Dimasssius/DIY_Alliance_NixieClock_Userland/hardcore/README.md

[Главная](../README.md) / Hardcore

# ⚡ Hardcore Edition

Обложка DIY_Alliance Nixie Clock

Расширенная линейка часов DIY_Alliance. Сборочные документы выбираются по количеству индикаторов и комплектации.

## Выберите количество индикаторов

| Плата | Вид платы | Материалы |
| :--- | :---: | :--- |
| **Hardcore · 4 индикатора** | Верхняя сторона Hardcore на 4 индикатора, базовая комплектация | [Выбрать комплектацию](assembly/hardcore-boards-x4-tubes/README.md) |
| **Hardcore · 6 индикаторов** | Верхняя сторона Hardcore на 6 индикаторов, базовая комплектация | [Выбрать комплектацию](assembly/hardcore-boards-x6-tubes/README.md) |

## Комплектации Hardcore

| Название в документах | Как понимать |
| :--- | :--- |
| Minimal | Минимальная комплектация компонентов для запуска часов |
| Base | Базовая комплектация с основными функциями |
| Maximal | Расширенная комплектация с дополнительными датчиками и модулями |

Выбирайте комплектацию по своему набору и BOM. Наличие отдельных функций проверяйте по схеме и настройкам прошивки.

## Сборка, прошивка и использование

| Задача | Раздел |
| :--- | :--- |
| Подготовиться к первой сборке | [Начало работы](../START_HERE.md) |
| Найти инструкцию | [Инструкции Hardcore](manuals/README.md) |
| Настроить и загрузить прошивку | [Совместимость Hardcore](firmware/README.md) · [Общий порядок настройки](../common/firmware/CONFIGURATION.md) |
| Настроить время, подсветку и будильник | [Управление часами](../common/manuals/USER_GUIDE.md) |
| Найти ответ или причину неисправности | [Вопросы по Hardcore](faq/README.md) · [Диагностика](../common/troubleshooting/README.md) |
| Найти характеристики компонентов | [Даташиты](datasheets/README.md) |

> [!NOTE]
> Отдельная пошаговая инструкция Hardcore и готовые сборки прошивок пока не опубликованы. Доступны схемы, BOM, чертежи и общие руководства.

Ревизию уточняйте по маркировке платы. Изображения в каталоге служат визуальным ориентиром. [Полный каталог сборочных материалов](assembly/README.md).
