Dimasssius/DIY_Alliance_NixieClock_Userland/standard/README.md

[Главная](../README.md) / Standard

# 🔧 Standard Edition

Обложка DIY_Alliance Nixie Clock

Базовая линейка часов DIY_Alliance. Сборочные документы выбираются по количеству индикаторов, варианту монтажа и ориентации индикаторов.

## Выберите количество индикаторов

| Плата | Вид платы | Материалы |
| :--- | :---: | :--- |
| **Standard · 4 индикатора** | Верхняя сторона Standard на 4 индикатора | [Выбрать документы](assembly/standard-boards-x4-tubes/README.md) |
| **Standard · 6 индикаторов** | Верхняя сторона Standard на 6 индикаторов | [Выбрать документы](assembly/standard-boards-x6-tubes/README.md) |

## Варианты Standard

Для каждой платы есть документы на **выводной монтаж** и **поверхностный монтаж (SMD)**, с **вертикальными** или **горизонтальными** индикаторами. Выбирайте одинаковый вариант в BOM, схеме и сборочном чертеже.

## Сборка, прошивка и использование

| Задача | Раздел |
| :--- | :--- |
| Подготовиться к первой сборке | [Начало работы](../START_HERE.md) |
| Найти инструкцию | [Инструкции Standard](manuals/README.md) |
| Настроить и загрузить прошивку | [Совместимость Standard](firmware/README.md) · [Общий порядок настройки](../common/firmware/CONFIGURATION.md) |
| Настроить время, подсветку и будильник | [Управление часами](../common/manuals/USER_GUIDE.md) |
| Найти ответ или причину неисправности | [Вопросы по Standard](faq/README.md) · [Диагностика](../common/troubleshooting/README.md) |

> [!NOTE]
> PDF-инструкции по сборке опубликованы для x4 и x6. Готовые сборки прошивок для скачивания пока отсутствуют; доступны заметки по настройке.

Ревизию уточняйте по маркировке платы. Изображения в каталоге служат визуальным ориентиром. [Полный каталог сборочных материалов](assembly/README.md).
