Dimasssius/DIY_Alliance_NixieClock_Userland/images/diagrams/README.md

[Главная](../../README.md) / [Изображения](../README.md) / Диаграммы и схемы подключения

# 🖼️ Диаграммы и схемы подключения

Отдельные поясняющие диаграммы пока не добавлены.

Электрические схемы конкретных плат доступны в каталогах [Standard](../../standard/assembly/README.md) и [Hardcore](../../hardcore/assembly/README.md).
