Dimasssius/DIY_Alliance_NixieClock_Userland/START_HERE.md

[Главная](README.md) / Начало работы

# 🚀 Начало работы: от платы до работающих часов

Если часы уже собраны, откройте [руководство пользователя](common/manuals/USER_GUIDE.md). Если возникла неисправность — [диагностику](common/troubleshooting/README.md).

## 1. Определите свою сборку

Перед выбором файлов уточните:

| Параметр | Что нужно знать |
| :--- | :--- |
| **Линейка** | Standard или Hardcore |
| **Количество индикаторов** | 4 или 6 |
| **Ревизия** | Маркировка на плате и документы к набору |
| **Вариант сборки** | Для Standard — выводной или поверхностный монтаж и ориентация индикаторов; для Hardcore — Minimal, Base или Maximal |
| **Индикаторы** | Модель и посадочное место верхней индикаторной платы |

Число индикаторов и ревизия платы — разные параметры. Если маркировка непонятна, уточните вариант у автора проекта до выбора компонентов и прошивки.

| Ваша плата | Материалы |
| :--- | :--- |
| Standard, 4 индикатора | [Страница платы](standard/assembly/standard-boards-x4-tubes/README.md) |
| Standard, 6 индикаторов | [Страница платы](standard/assembly/standard-boards-x6-tubes/README.md) |
| Hardcore, 4 индикатора | [Выбор комплектации](hardcore/assembly/hardcore-boards-x4-tubes/README.md) |
| Hardcore, 6 индикаторов | [Выбор комплектации](hardcore/assembly/hardcore-boards-x6-tubes/README.md) |

## 2. Подготовьте документы и компоненты

На странице своей платы или комплектации откройте **BOM → схему → сборочный чертёж**. Для Standard выбирайте один и тот же вариант монтажа и ориентации индикаторов во всех документах.

- **BOM** — список компонентов, их номиналы, корпуса и количество.
- **Схема** — электрические соединения и обозначения компонентов.
- **Сборочный чертёж** — расположение компонентов на плате.
- **Рендер** — внешний вид платы для визуальной проверки.

Прочитайте [подготовку к сборке](common/manuals/ASSEMBLY_GUIDE.md) и проверьте [совместимость индикаторов](common/indicators/README.md).

Для Standard опубликованы [PDF-инструкции на 4 и 6 индикаторов](standard/manuals/README.md). Отдельной пошаговой инструкции Hardcore пока нет; доступны [общие рекомендации и документы комплектаций](hardcore/manuals/README.md).

## 3. Соберите и проверьте плату

Следуйте инструкции своей версии. Сверяйте номиналы с BOM, ориентацию компонентов — со схемой и маркировкой, расположение — со сборочным чертежом.

Перед первым включением проверьте монтаж, полярность питания и отсутствие коротких замыканий. Известные нюансы описаны в [общем руководстве](common/manuals/ASSEMBLY_GUIDE.md#известные-нюансы-индикаторных-плат).

> [!CAUTION]
> В часах есть высоковольтная часть. Выполняйте пайку и исправление монтажа при отключённом питании.

## 4. Настройте и загрузите прошивку

> [!NOTE]
> Готовые сборки прошивок для плат DIY_Alliance в этом репозитории пока не опубликованы. В Wiki описана настройка внешней прошивки radon-lab/NixieClock.

Откройте [раздел прошивки](common/firmware/README.md), затем [порядок настройки и загрузки](common/firmware/CONFIGURATION.md). Сверьте линейку, ревизию, число индикаторов, периферию и разводку своей платы.

## 5. Проверьте результат и настройте часы

После загрузки проверьте отображение цифр, порядок индикаторов и работу кнопок. Настройте время и нужные функции по [руководству пользователя](common/manuals/USER_GUIDE.md).

Если результат отличается от ожидаемого, выберите симптом в [разделе диагностики](common/troubleshooting/README.md). Если вопрос остался, подготовьте данные своей сборки и [описание проблемы](FAQ.md#какие-данные-подготовить-для-обращения-за-помощью).
