Dimasssius/DIY_Alliance_NixieClock_Userland/announcements/2026-06-07-pcb-v2-announcement.md

[Главная](../README.md) / [Новости](README.md) / Платы v2.0

# 📰 Новая версия печатных плат v2.0 заказана

**Опубликовано: 7 июня 2026 года.** Описание планов и состояния проекта на дату публикации.

Подготовлена новая версия печатных плат DIY_Alliance Nixie Clock v2.0 для Standard и Hardcore линеек.

Платы уже заказаны. После получения я протестирую их, исправлю возможные проблемы, внесу мелкие доработки и после этого буду готов запускать платы в производство и продажу.

## Standard Boards x4 Tubes v2.0

В стандартной плате на 4 индикатора изменений не очень много, но они затрагивают удобство сборки и качество разводки:

- Изменено расположение почти всех компонентов, увеличено расстояние между ними, улучшена разводка дорожек и полигонов.
- Доработаны футпринты некоторых компонентов, например изменен футпринт Micro USB-коннектора.
- UART-преобразователь CH340C перенесен на верхний слой. Теперь все компоненты, кроме холдера батарейки CR1025, находятся на верхнем слое печатной платы.
- Слегка изменены размеры печатной платы: размеры теперь кратны сетке 0.025 мм.
- Buzzer заменен на FUET-4020.
- Изменились некоторые электронные компоненты, например установлен другой, более подходящий MOSFET.

## Standard Boards x6 Tubes v2.0

В стандартной плате на 6 индикаторов изменения аналогично направлены на улучшение разводки и сборки:

- Изменено расположение почти всех компонентов, увеличено расстояние между ними, улучшена разводка дорожек и полигонов.
- Доработаны футпринты некоторых компонентов, например изменен футпринт Micro USB-коннектора.
- UART-преобразователь CH340C перенесен на верхний слой. Теперь все компоненты находятся на верхнем слое печатной платы.
- Слегка изменены размеры печатной платы: размеры теперь кратны сетке 0.025 мм.
- Изменились некоторые электронные компоненты, например установлен другой, более подходящий MOSFET.

## Hardcore Boards x4 Tubes v2.0

Версия Hardcore на 4 индикатора была переработана значительно глубже:

- Плата переделана с нуля, изменены некоторые компоненты, например MOSFET у повышающего преобразователя.
- Повышающий преобразователь перемещен на верхний слой. Теперь на нижнем слое размещается только CH340C.
- Buzzer заменен на FUET-4020.
- Типоразмер конденсаторов и резисторов заменен на 0603 у всех компонентов, кроме обвязки ESP8266, где остался 0402.

## Hardcore Boards x6 Tubes v2.0

Версия Hardcore на 6 индикаторов также переработана с нуля:

- Плата переделана с нуля, изменены некоторые компоненты, например MOSFET у повышающего преобразователя.
- Повышающий преобразователь перемещен на верхний слой. Теперь все компоненты расположены на верхнем слое.
- Типоразмер конденсаторов и резисторов заменен на 0603 у всех компонентов.
- Добавлена поддержка RTC RV-3028-C7.
- Выведены Test Point под пайку MP3-плеера и FM-тюнера.

## Следующие шаги

1. Получить заказанные платы v2.0.
2. Собрать и протестировать Standard x4/x6 и Hardcore x4/x6.
3. Исправить возможные проблемы после проверки.
4. Внести мелкие доработки, если они понадобятся.
5. Портировать актуальную прошивку под печатные платы DIY_Alliance.
6. Подготовить платы к производству и продаже.
7. Плотно заняться переработкой верхних, индикаторных печатных плат под все поддерживаемые индикаторы.
