Dimasssius/DIY_Alliance_NixieClock_Userland/hardcore/assembly/hardcore-boards-x4-tubes/base-configuration/report-board-stack/Report Board Stack.PDF

# Board Stack Report

Stack Up | Layer Stack
Layer | Board Layer Stack | Name | Material | Thickness | Constant

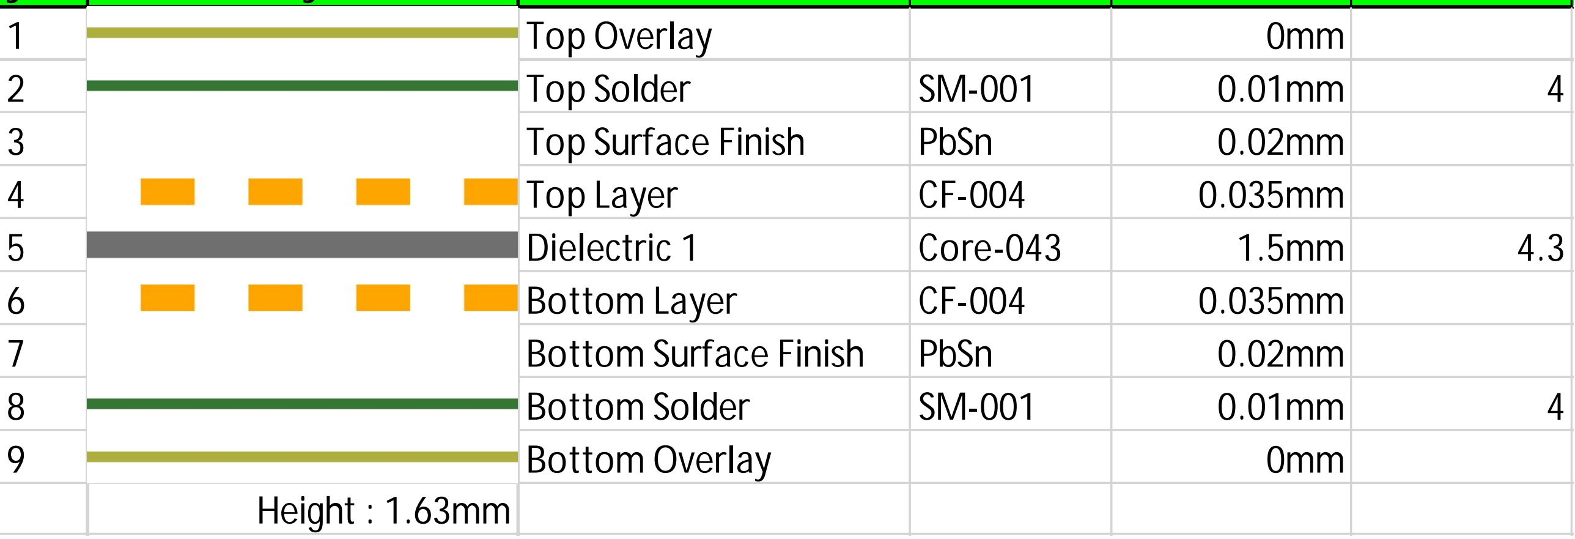
[picture p6: figure]
Top Overlay; Top Solder; Top Surface Finish; PbSn; Top Layer; Dielectric 1; Core-043; Bottom Layer; Bottom Surface Finish; Bottom Solder; Bottom Overlay; Height : 1.63mm
