Dimasssius/DIY_Alliance_NixieClock_Userland/announcements/README.md

[Главная](../README.md) / Новости проекта

# 📰 Новости проекта

Объявления о платах и планах автора. Дата публикации важна: планы из старого объявления не подтверждают текущую готовность платы или прошивки.

| Дата | Объявление |
| :--- | :--- |
| 7 июня 2026 | [Заказаны новые платы v2.0: изменения Standard и Hardcore](2026-06-07-pcb-v2-announcement.md) |

Изменения файлов Wiki: [история изменений](../CHANGELOG.md).
