Dimasssius/DIY_Alliance_NixieClock_Userland/common/README.md

[Главная](../README.md) / Общие материалы

# 🧭 Общие материалы

Руководства и справка для Standard и Hardcore. BOM, схемы и сборочные чертежи выбирайте в [каталоге Standard](../standard/README.md) или [каталоге Hardcore](../hardcore/README.md).

| Задача | Раздел |
| :--- | :--- |
| Подготовиться к сборке и проверить компоненты | [Общие рекомендации по сборке](manuals/ASSEMBLY_GUIDE.md) |
| Научиться управлять часами | [Кнопки, настройки и режимы](manuals/USER_GUIDE.md) |
| Выбрать прошивку и понять совместимость | [Прошивка](firmware/README.md) |
| Настроить пины, катодную маску и порядок анодов | [Настройка и загрузка прошивки](firmware/CONFIGURATION.md) |
| Проверить модель индикаторов и сокет | [База индикаторов](indicators/README.md) |
| Подобрать катодную маску | [Инструменты](tools/README.md) |
| Найти причину неисправности | [Диагностика](troubleshooting/README.md) |

Все руководства, включая PDF по эксплуатации: [раздел инструкций](manuals/README.md).
