Dimasssius/DIY_Alliance_NixieClock_Userland/images/README.md

[Главная](../README.md) / Изображения

# 🖼️ Изображения проекта

| Что нужно | Где найти | Статус |
| :--- | :--- | :--- |
| Фотографии газоразрядных индикаторов | [Галерея индикаторов](indicators/README.md) | Есть фотографии советских моделей |
| Рендеры конкретной платы | [Standard](../standard/README.md) · [Hardcore](../hardcore/README.md) | Есть в материалах плат и комплектаций |
| Общие фотографии сборки | [Фотографии проекта](photos/README.md) | Пока не добавлены |
| Обложка и правила оформления Wiki | [Баннеры Wiki](banners/README.md) | Есть тематическая обложка |
| Общие рендеры устройств | [Рендеры проекта](renders/README.md) | Пока не добавлены |
| Поясняющие диаграммы | [Диаграммы](diagrams/README.md) | Пока не добавлены |

Список поддерживаемых моделей и сокетов находится в [базе индикаторов](../common/indicators/README.md).
