Dimasssius/DIY_Alliance_NixieClock_Userland/common/firmware/README.md

[Главная](../../README.md) / [Общие материалы](../README.md) / Прошивка

# ⚙️ Прошивка: источник, совместимость и настройка

> [!NOTE]
> Готовые сборки прошивок для плат DIY_Alliance в этой Wiki пока не опубликованы. Здесь описана адаптация внешней прошивки под вашу сборку.

В документации проекта используется [radon-lab/NixieClock](https://github.com/radon-lab/NixieClock). Её исходный код находится во внешнем репозитории; здесь собраны пояснения по настройке для Standard и Hardcore.

## С чего начать

| Задача | Документ |
| :--- | :--- |
| Проверить, что учитывать для своей линейки | [Standard](../../standard/firmware/README.md) · [Hardcore](../../hardcore/firmware/README.md) |
| Настроить пины, периферию и индикацию | [Порядок настройки](CONFIGURATION.md#порядок-настройки-прошивки) |
| Загрузить прошивку в микроконтроллер | [Порядок загрузки](CONFIGURATION.md#порядок-прошивки-микроконтроллера) |
| Исправить неправильные цифры | [Подбор катодной маски](CONFIGURATION.md#подбор-катодной-маски-индикаторов) |
| Исправить порядок индикаторов | [Подбор порядка анодов](CONFIGURATION.md#подбор-порядка-анодов) |
| Разобраться с ошибкой | [Диагностика](../troubleshooting/README.md) |

## Что зависит от платы

Сверьте **линейку → ревизию → число индикаторов → вариант сборки → установленную периферию**. Настройки пинов, индикации и модулей проверяйте по схеме своей платы.

Общие инструкции описывают процесс настройки. Проверенный комплект конфигурационных файлов для каждой ревизии в Wiki пока не опубликован.

| Файл внешней прошивки | Назначение в документации Wiki |
| :--- | :--- |
| `connection.h` | Пины подключения периферии |
| `userConfig.h` | Выбор периферии и пользовательские настройки |
| `config.h` | Общие настройки, маска дешифратора и порядок катодов |
| `indication.h` | Порядок анодов индикаторов |
| `boards.h` | Собственные настройки платы для переноса на другие версии прошивки |

Для разводки, отличающейся от базовой платы автора прошивки, в документации Wiki используется `BOARD_TYPE 0`. Подробности — в [порядке настройки](CONFIGURATION.md).

## Сервисные режимы при включении

[Сброс настроек, меню отладки и тест системы](../manuals/USER_GUIDE.md#сервисные-режимы-при-включении) описаны в руководстве пользователя. Наличие и поведение режимов зависят от используемой прошивки.

## Источник и изменения плат

Источник прошивки: [radon-lab/NixieClock](https://github.com/radon-lab/NixieClock), лицензия MIT.

Изменения новых плат описаны в [объявлении от 7 июня 2026 года](../../announcements/2026-06-07-pcb-v2-announcement.md). Объявление фиксирует планы на дату публикации; совместимость конкретной сборки проверяйте отдельно.
