Dimasssius/DIY_Alliance_NixieClock_Userland/common/indicators/README.md

[Главная](../../README.md) / [Общие материалы](../README.md) / Индикаторы

# 💡 Поддерживаемые индикаторы

База моделей газоразрядных индикаторов и вариантов индикаторных плат DIY_Alliance. Модель индикатора относится к верхней плате; материалы нижней платы выбирайте в [Standard](../../standard/README.md) или [Hardcore](../../hardcore/README.md).

## Как выбрать вариант

1. Найдите модель в таблице ниже.
2. Проверьте число индикаторов и наличие смешанной конфигурации.
3. При замене модели откройте список совместимых сокетов.
4. Сверьте распиновку, электрические и механические параметры со своей сборкой.

**«4 или 6 индикаторов»** означает два отдельных варианта платы. **«ИН-8 + ИН-16»** означает смешанную сборку: 4 основных ИН-8 и 2 ИН-16 для секунд.

Совместимость сокета описывает посадочное место. Применимость другой модели к конкретной сборке нужно проверять отдельно.

[Советские модели](#советские-индикаторы) · [Популярные зарубежные](#популярные-зарубежные-индикаторы) · [Редкие зарубежные](#редкие-зарубежные-индикаторы) · [Фотографии](../../images/indicators/README.md)

## Советские индикаторы

| Индикатор | Вариант платы | Совместимые по сокету |
| :--- | :--- | :--- |
| **ИН-1** | 4 или 6 индикаторов | — |
| **ИН-2** | 4 или 6 индикаторов | — |
| **ИН-4** | 4 или 6 индикаторов | — |
| **ИН-4 + ИН-2** | 4 индикатора ИН-4 + 2 секундных ИН-2 | — |
| **ИН-8** | 4 или 6 индикаторов | — |
| **ИН-8 + ИН-16** | 4 индикатора ИН-8 + 2 секундных ИН-16 | — |
| **ИН-8-2** | 4 или 6 индикаторов | — |
| **ИН-8-2 + ИН-16** | 4 индикатора ИН-8-2 + 2 секундных ИН-16 | — |
| **ИН-12** | 4 или 6 индикаторов | [Список моделей](#сокет-ин-12) |
| **ИН-12 + ИН-17** | 4 индикатора ИН-12 + 2 секундных ИН-17 | [Список моделей](#сокет-ин-12) |
| **ИН-14** | 4 или 6 индикаторов | — |
| **ИН-14 + ИН-16** | 4 индикатора ИН-14 + 2 секундных ИН-16 | — |
| **ИН-16** | 4 или 6 индикаторов | — |
| **ИН-17** | 4 или 6 индикаторов | — |
| **ИН-18** | 4 или 6 индикаторов | — |
| **ИН-18 + ИН-14** | 4 индикатора ИН-18 + 2 секундных ИН-14 | — |

## Популярные зарубежные индикаторы

| Индикатор | Вариант платы | Совместимые по сокету |
| :--- | :--- | :--- |
| **Z566M** | 4 или 6 индикаторов | [Список моделей](#сокет-z566m) |
| **Z560M** | 4 или 6 индикаторов | [Список моделей](#сокет-z560m) |
| **ZM1040** | 4 или 6 индикаторов | [Список моделей](#сокет-zm1040) |
| **ZM1080** | 4 или 6 индикаторов | [Список моделей](#сокет-zm1080) |
| **ZM1000** | 4 или 6 индикаторов | [Список моделей](#сокет-zm1000) |

## Редкие зарубежные индикаторы

| Индикатор | Вариант платы | Совместимые по сокету |
| :--- | :--- | :--- |
| **NL-844** | 4 индикатора | [Список моделей](#сокет-nl-844) |
| **NL-5870** | 4 индикатора | [Список моделей](#сокет-nl-5870) |
| **CD80** | 4 индикатора | — |

## Сокеты и совместимые модели

Списки ниже сохранены из исходной базы. Перед установкой другой модели проверьте её параметры и распиновку.

### Сокет ИН-12

IN-15A, IN-15B, ZM1162, ZM1180, ZM1181, ZM1182, ZM1183, ZM1185A, ZM1185B, ZM1185D, ZM1185E, ZM1185F, ZM1186, ZM1188, GR1420, GR1430, F9152A, CD43, CD56, B59956

### Сокет Z566M

LC631, Z5660M, Z567M, Z5670M, B566M, Z522M, ZM1040, ZM1041, ZM1041S, ZM1042, ZM1043, ZM1043S, ZM1047, ZM1049

### Сокет Z560M

Z560M, Z5600M, Z510M, Z561M, Z562M2, Z562M3, ZM1020, ZM1021, ZM1022, ZM1023, ZM1024, ZM1025, B5092, B5094, NL5094, B6032, B6033, B6034, B6036, B6091, 6844A, LC513A, LC511, LL551, LL552, LL553, LL554, LL555, LL556, LL557, LL558, QS30-1

### Сокет ZM1040

ZM1041, ZM1041S, ZM1042, ZM1043, ZM1043S, ZM1047, ZM1049

### Сокет ZM1080

Z570M, B570M, Z573M, Z574M, Z5730M, Z5740M, ZM1081, ZM1082, ZM1134, ZM1138A, F9080B, F9080BA, TAF1093, TAF1317A, TAU7030

### Сокет ZM1000

ZM1001, ZM1005, ZM1005R, ZM1006, ZM1010, ZM1011, ZM1012, ZM1013, MTC0X 3B/3F/3J/4I/5B/6B/6F, MCD0X, MUD0X

### Сокет NL-844

NL803, NL807, NL811, NL812, NL821, NL840, NL840VR, NL841, NL842, NL843, NL845, NL847, NL848, NL864, NL867, NL900, NL908, NL939, NL943, CK1907, CK8754, 340-0005

### Сокет NL-5870

NL-5870S, NL-5870ST, NL-5870SF, NL-5870TF, NL-5870L, NL-950S

Фотографии: [советские индикаторы](../../images/indicators/soviet/README.md). Галерея зарубежных моделей пока не заполнена.
