Dimasssius/DIY_Alliance_NixieClock_Userland/hardcore/firmware/README.md

[Главная](../../README.md) / [Hardcore](../README.md) / Прошивка

# ⚙️ Прошивка Hardcore: совместимость и настройка

> [!NOTE]
> Готовые сборки и архивы прошивок для Hardcore в этой папке пока не опубликованы. Доступна документация по настройке внешней прошивки.

В документации проекта используется [radon-lab/NixieClock](https://github.com/radon-lab/NixieClock) с параметрами под разводку DIY_Alliance.

## Перед загрузкой

Сверьте:

- линейку **Hardcore**, количество индикаторов **4 / 6** и ревизию платы;
- комплектацию **Minimal / Base / Maximal** и установленную периферию;
- подключение пинов по схеме своей платы;
- катодную маску и порядок анодов выбранных индикаторов.

Количество индикаторов само по себе не определяет совместимость прошивки.

## Порядок действий

1. Откройте [BOM и схему своей платы](../assembly/README.md).
2. Прочитайте [общие пояснения по прошивке](../../common/firmware/README.md).
3. Выполните [настройку и загрузку](../../common/firmware/CONFIGURATION.md).
4. Проверьте цифры и порядок индикаторов; при проблемах используйте [диагностику](../../common/troubleshooting/README.md).
