Dimasssius/DIY_Alliance_NixieClock_Userland/images/banners/README.md

[Главная](../../README.md) / [Изображения](../README.md) / Баннеры

# 🖼️ Баннеры Wiki

Тематическая обложка базы знаний: графитовый фон, медные дорожки и янтарное свечение газоразрядных индикаторов. Изображение используется на главной и в разделах Standard/Hardcore.

Обложка DIY_Alliance Nixie Clock с шестью светящимися газоразрядными индикаторами

| Файл | Назначение |
| :--- | :--- |
| [wiki-hero.png](wiki-hero.png) | Обложка, PNG, 2172 × 724 пикселя |
| [Исходный промпт](wiki-hero.prompt.txt) | Описание, использованное встроенным инструментом imagegen |

Обложка — декоративная иллюстрация. Фотографии и рендеры конкретных плат находятся в каталогах [Standard](../../standard/README.md) и [Hardcore](../../hardcore/README.md).

## Правила оформления

- На одной странице достаточно одной обложки. В каталогах отдельных файлов используются компактный заголовок и контекст платы.
- Эмодзи обозначают раздел или действие. Текст подписи всегда сохраняется; длинные таблицы не заполняются декоративными значками.
- Основной текст и длинные описания выравниваются слева. Форматы файлов, коды, номера и превью — по центру.
- Заголовки технических разделов сохраняются, чтобы не ломать ссылки на настройку, диагностику и коды ошибок.
- Изображения содержат понятный `alt`. Обложка адаптируется по ширине через `width="100%"`.
- В README используются возможности GitHub Markdown: заголовки, таблицы, ссылки, предупреждения и раскрываемые примечания.
- Принудительная ширина таблиц через CSS недоступна в репозитории GitHub. Не добавляйте пустые изображения и пробелы для растягивания.

Ограничения платформы: [GitHub Markup](https://github.com/github/markup), [стили таблиц Primer](https://github.com/primer/css/blob/main/src/markdown/tables.scss).
