Dimasssius/DIY_Alliance_NixieClock_Userland/images/indicators/README.md

[Главная](../../README.md) / [Изображения](../README.md) / Индикаторы

# 💡 Фотографии индикаторов

Галерея помогает сравнить внешний вид моделей. Совместимость и варианты плат проверяйте по [базе индикаторов](../../common/indicators/README.md).

| Раздел | Что доступно |
| :--- | :--- |
| [Советские индикаторы](soviet/README.md) | Фотографии 10 моделей |
| [Зарубежные индикаторы](foreign/README.md) | Фотографии пока не добавлены |
