Dimasssius/DIY_Alliance_NixieClock_Userland/images/photos/README.md

[Главная](../../README.md) / [Изображения](../README.md) / Фотографии проекта

# 🖼️ Фотографии проекта

Общие фотографии сборки и готовых устройств пока не добавлены.

Доступны [фотографии советских индикаторов](../indicators/soviet/README.md).
