Dimasssius/DIY_Alliance_NixieClock_Userland/images/renders/README.md

[Главная](../../README.md) / [Изображения](../README.md) / Рендеры проекта

# 🖼️ Рендеры проекта

Общие рендеры устройств пока не добавлены. [Обложка базы знаний](../banners/README.md) находится в отдельном разделе баннеров.

Рендеры конкретных плат доступны в каталогах [Standard](../../standard/README.md) и [Hardcore](../../hardcore/README.md).
