Dimasssius/DIY_Alliance_NixieClock_Userland/images/indicators/foreign/README.md

[Главная](../../../README.md) / [Изображения](../../README.md) / [Индикаторы](../README.md) / Зарубежные модели

# 💡 Зарубежные индикаторы

Фотографии зарубежных моделей пока не добавлены.

Доступны [списки популярных и редких зарубежных индикаторов](../../../common/indicators/README.md#популярные-зарубежные-индикаторы) и [фотографии советских моделей](../soviet/README.md).
