Dimasssius/DIY_Alliance_NixieClock_Userland/images/indicators/soviet/README.md

[Главная](../../../README.md) / [Изображения](../../README.md) / [Индикаторы](../README.md) / Советские модели

# 💡 Советские индикаторы

Фотографии моделей из базы проекта. Откройте изображение для просмотра в полном размере. Варианты плат и совместимость: [база индикаторов](../../../common/indicators/README.md).

| Модель | Фотография |
| :---: | :---: |
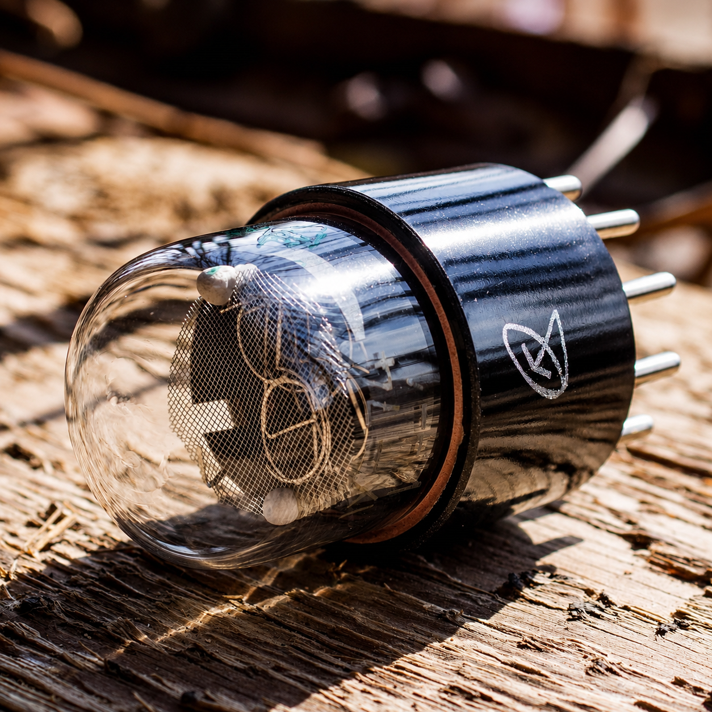
[picture p7: images/indicators/soviet/ИН-1.png]
Газоразрядный индикатор ИН-1
| **ИН-1** |  |
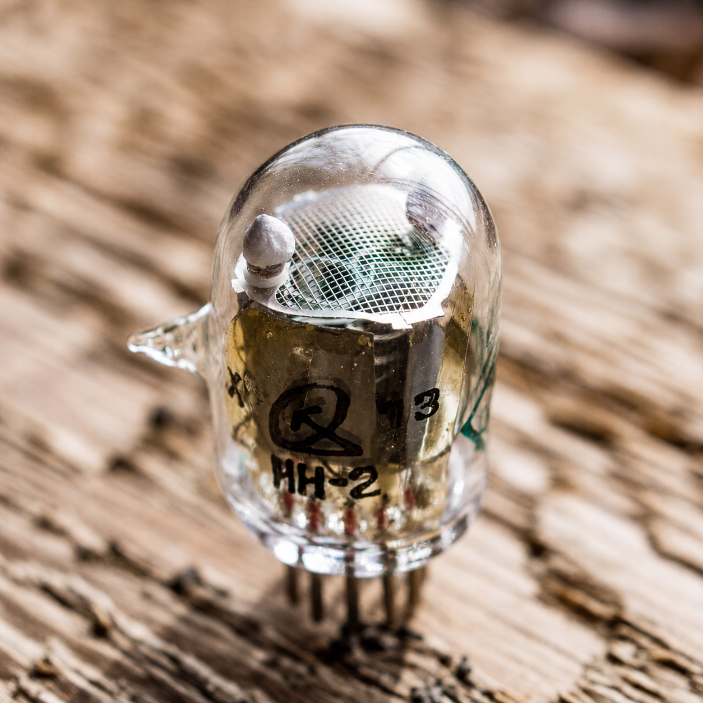
[picture p8: images/indicators/soviet/ИН-2.png]
Газоразрядный индикатор ИН-2
| **ИН-2** |  |
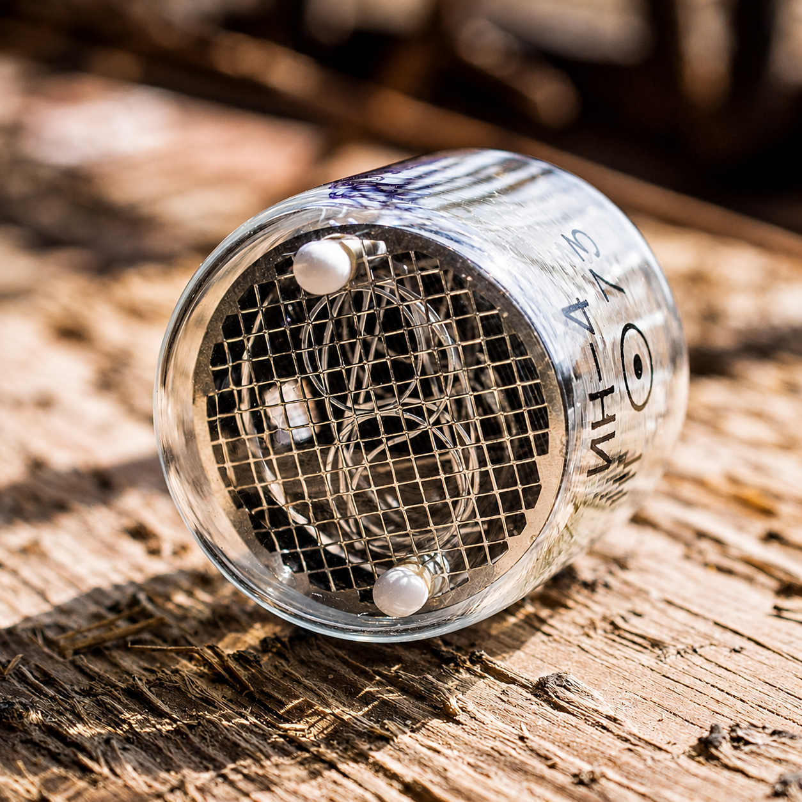
[picture p9: images/indicators/soviet/ИН-4.png]
Газоразрядный индикатор ИН-4
| **ИН-4** |  |
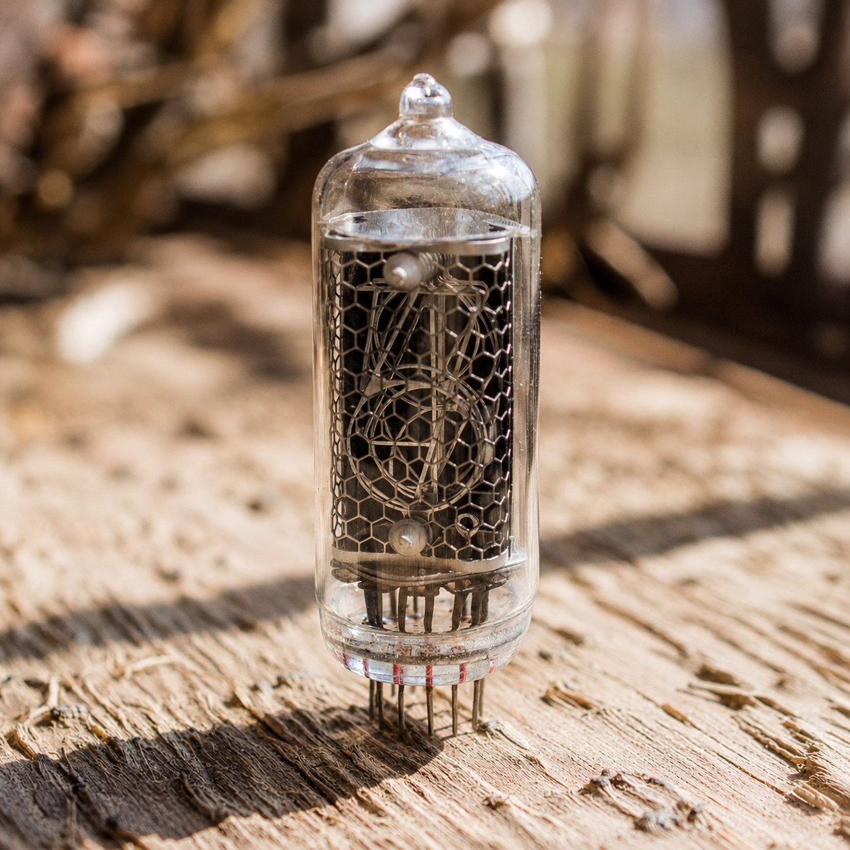
[picture p10: images/indicators/soviet/ИН-8-2.png]
Газоразрядный индикатор ИН-8-2
| **ИН-8-2** |  |
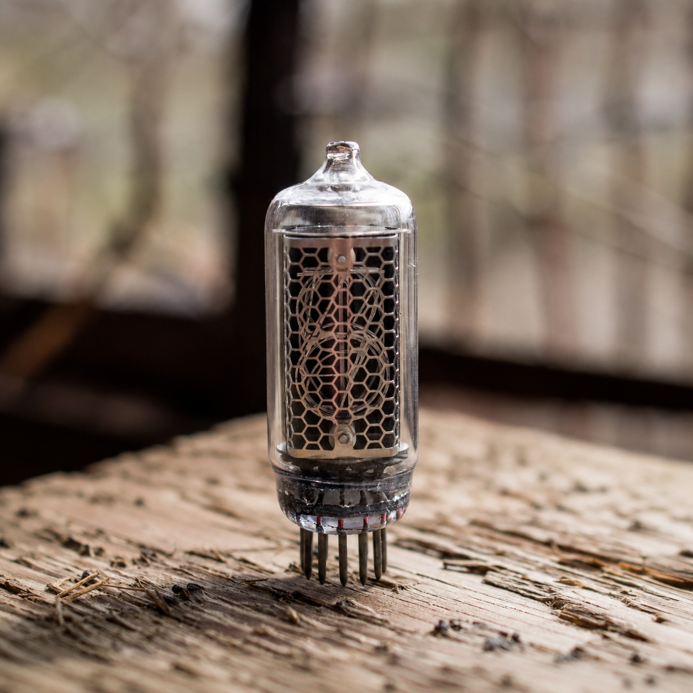
[picture p11: images/indicators/soviet/ИН-8.png]
Газоразрядный индикатор ИН-8
| **ИН-8** |  |
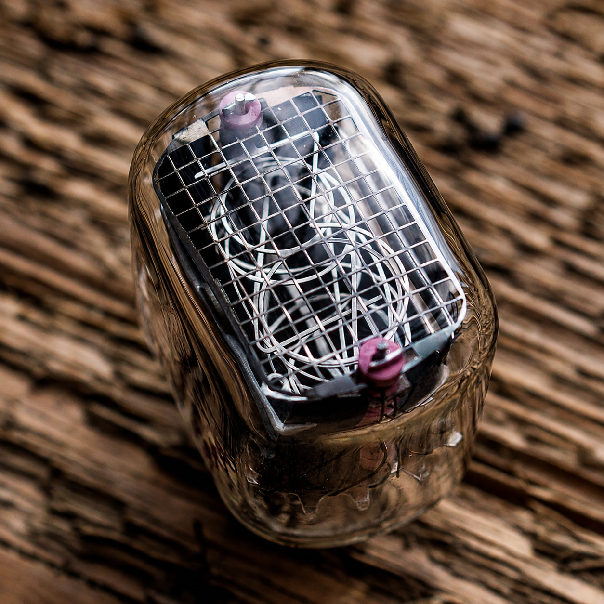
[picture p12: images/indicators/soviet/ИН-12.png]
Газоразрядный индикатор ИН-12
| **ИН-12** |  |
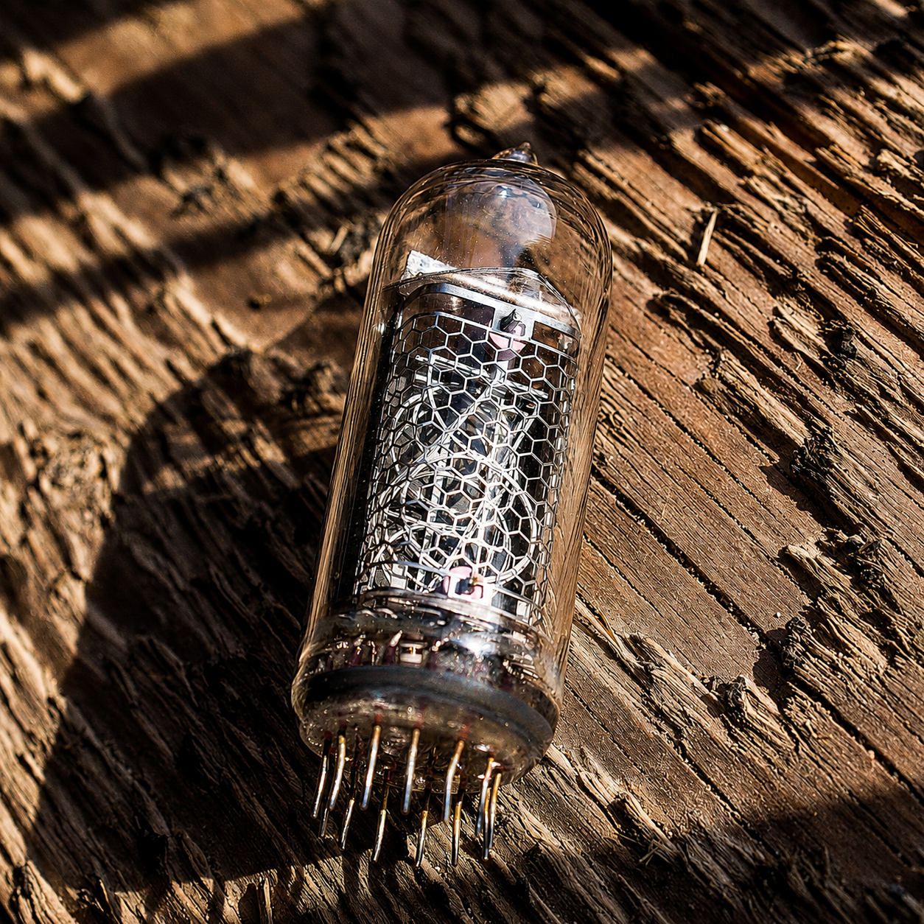
[picture p13: images/indicators/soviet/ИН-14.png]
Газоразрядный индикатор ИН-14
| **ИН-14** |  |
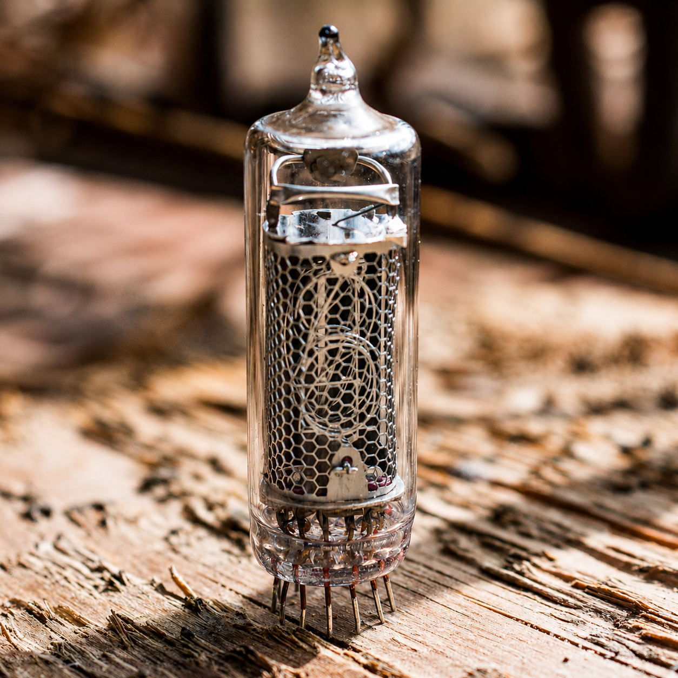
[picture p14: images/indicators/soviet/ИН-16.png]
Газоразрядный индикатор ИН-16
| **ИН-16** |  |
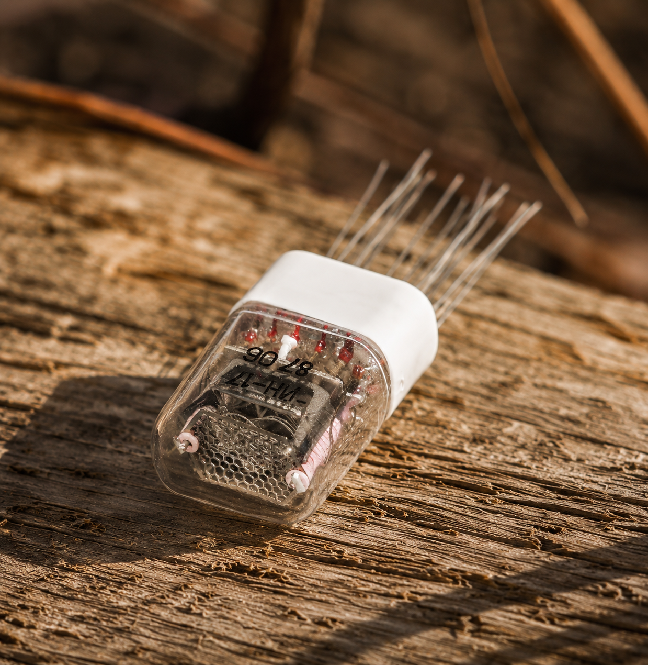
[picture p15: images/indicators/soviet/ИН-17.png]
Газоразрядный индикатор ИН-17
| **ИН-17** |  |
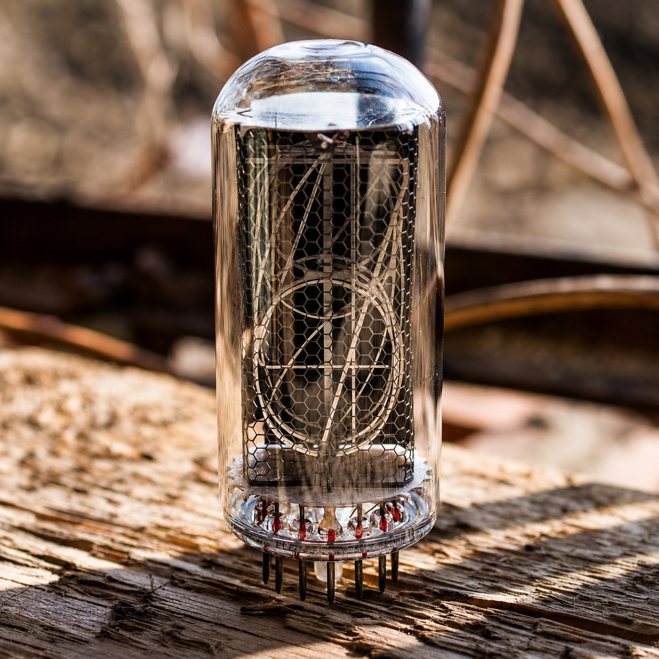
[picture p16: images/indicators/soviet/ИН-18.png]
Газоразрядный индикатор ИН-18
| **ИН-18** |  |
