Dimasssius/DIY_Alliance_NixieClock_Userland/hardcore/assembly/hardcore-boards-x6-tubes/maximal-configuration/report-board-stack/README.md

[Главная](../../../../../README.md) / [Hardcore](../../../../README.md) / [6 индикаторов](../../README.md) / [Maximal](../README.md) / Отчёт по слоям платы

# 📑 Отчёт по слоям платы

**Hardcore · 6 индикаторов · Maximal**

Справочный PDF-отчёт по стеку платы: её слоям и структуре. Для обычной сборки начните с BOM, схемы и сборочного чертежа.

| Формат | Файл |
| :---: | :--- |
| **PDF** | [Отчёт по слоям платы](Report%20Board%20Stack.PDF) |

Файлы относятся к указанной комплектации Hardcore. Ревизию сверяйте по маркировке платы.

[Вернуться к комплектации](../README.md) · [Начало работы](../../../../../START_HERE.md)
