Dimasssius/DIY_Alliance_NixieClock_Userland/WIKI_REVIEW.md

[Главная](README.md) / Аудит Wiki

# 🔎 Аудит структуры и подачи Wiki

Аудит выполнен 10 октября 2026 года для чтения документации в репозитории GitHub. Проверены Markdown-страницы, состав файлов и локальная навигация. На момент начала работы: **99 Markdown-страниц, 93 PDF, 14 таблиц Excel, 54 PNG**.

## Основные проблемы и внесённые изменения

| Проблема исходной Wiki | Что изменено |
| :--- | :--- |
| Главная подробно перечисляла папки и повторяла описания линеек; новичку приходилось самому выбирать маршрут | [Главная](README.md) строится вокруг задач и визуального выбора четырёх плат |
| Start Here перечислял каталоги без последовательности действий | [Начало работы](START_HERE.md) ведёт через выбор сборки, документы, монтаж, прошивку и проверку |
| FAQ ссылался на отсутствующий `troubleshooting/` и называл несуществующий каталог `schematics/` | [FAQ](FAQ.md) ссылается на реальные страницы диагностики и схем |
| Документация обещала доступные прошивки, но каталоги содержали только README и служебные файлы | Статус готовых сборок указан на главной, в маршруте сборки и разделах прошивки |
| Отдельная инструкция Hardcore выглядела как заполненный раздел | [Раздел Hardcore](hardcore/manuals/README.md) показывает, что опубликовано и что ещё отсутствует |
| 54 README каталогов файлов почти не помогали выбрать документ | Добавлены русские названия, контекст платы, прямые ссылки на файлы и возврат к родительской странице |
| Различия монтажа Standard и комплектаций Hardcore терялись среди названий папок | У Standard есть таблицы четырёх вариантов сборки, у Hardcore — страницы трёх комплектаций с основными документами |
| Общие руководства и диагностика требовали последовательного чтения | Добавлены быстрые переходы и таблица симптомов |
| Таблица индикаторов многократно повторяла одни списки совместимых сокетов | Совпадающие строки на 4 и 6 индикаторов объединены; отдельные смешанные конфигурации сохранены |
| Часть текстов была адресована наполнителю репозитория: «размещайте здесь», «здесь можно хранить» | Пользовательские страницы описывают доступные материалы; незаполненные галереи отмечены явно |

Файлы плат, PDF, таблицы, изображения, программы и существующие пути сохранены. Эта переработка касается навигации и подачи; электрические параметры и работоспособность аппаратных сборок отдельно не проверялись.

## Что ещё нужно подготовить автору

| Приоритет | Что добавить | Критерий готовности |
| :---: | :--- | :--- |
| 1 | Паспорт каждой ревизии платы | Фото маркировки, ревизия, совместимые индикаторные платы, подходящие BOM и схемы, известные отличия |
| 1 | Проверенные комплекты конфигурации прошивки | Указаны версия исходной прошивки, линейка, ревизия, x4/x6, комплектация, индикаторы и проверенная периферия; приложены файлы настроек |
| 1 | Пошаговую инструкцию Hardcore | Этапы монтажа, фотографии, контроль перед первым включением и проверка каждой комплектации |
| 2 | Уточнения к общим техническим заметкам | Для каждого конкретного номинала, модуля, кода ошибки и процедуры указана область применимости и источник |
| 2 | Проверку процедур настройки по выбранной версии внешней прошивки | Имена файлов, параметры и шаги загрузки сверены с конкретным релизом radon-lab/NixieClock |
| 2 | Сводку различий Minimal / Base / Maximal | Матрица компонентов и функций основана на BOM и результатах проверки, без общих обещаний |
| 2 | Проверку базы совместимых индикаторов | Сокет, распиновка, электрические и механические ограничения подтверждены для конкретных плат |
| 3 | Фотографии готовых часов и этапов сборки | Подписаны плата, ревизия, индикаторы и особенности монтажа |
| 3 | Проверяемый способ обращения за поддержкой | Указана актуальная ссылка на канал связи автора и ожидаемые данные обращения |

В объявлении от [7 июня 2026 года](announcements/2026-06-07-pcb-v2-announcement.md) описаны планы по платам v2.0. Оно не заменяет подтверждение испытаний и совместимости каждой ревизии.

## Правила дальнейшего наполнения

1. **Главная отвечает на задачи.** Каталоги и подробности остаются на страницах плат и материалов.
2. **Один факт — один основной источник.** Общее описание процесса находится в `common/`; на страницах линеек — особенности и ссылки.
3. **Названия для читателя — на русском.** Standard, Hardcore, Minimal, Base, Maximal, маркировки компонентов и имена файлов сохраняются.
4. **Каждая страница даёт следующий шаг.** Наверху — путь к родительским страницам; рядом с файлом — назначение и формат.
5. **Планируемые материалы имеют явный статус.** Не обещать загрузку из пустого каталога и не помечать непроверенную сборку как готовую.
6. **Совместимость указывается полностью.** Линейка, ревизия, количество индикаторов, вариант монтажа или комплектация, периферия и версия прошивки.
7. **Старые пути сохраняются при переносах.** На прежней странице оставить короткую ссылку на новый источник; перед изменением проверить входящие ссылки.
8. **Изменения проверяются перед публикацией.** Локальные ссылки, изображения, якоря заголовков и доступность страниц из главной.

## Результаты проверки структуры — первый этап

- Все **100 страниц** достижимы по ссылкам от главной.
- Проверены **1042 локальные ссылки** и **56 переходов к заголовкам**; отсутствующих целей не найдено.
- Все **184 файла материалов** доступны через ссылки из документации.
- Проверены **130 Markdown-таблиц**: число столбцов согласовано.
- Все **39 исходных вариантов индикаторов** и их списки сокетов сохранены после объединения повторов.
- Технические разделы руководств по сборке, управлению, настройке прошивки и диагностике сохранены без изменений.
- Проверка `git diff --check` проходит; изменения существующих файлов затрагивают только Markdown.

## Визуальное оформление — второй этап

- Добавлена [тематическая обложка](images/banners/README.md) в графитовых и янтарных тонах для главной и разделов Standard/Hardcore.
- Эмодзи используются как маркеры заголовков и ключевых задач. Значение каждого раздела по-прежнему понятно из текста.
- Все существующие таблицы получили единое выравнивание. Описания читаются слева; короткие форматы, номера и изображения — по центру.
- Коды ошибок и номера меню выделены моноширинным шрифтом. Названия кнопок, компонентов и параметров легче найти глазами.
- Сохранены ссылки, данные таблиц, программный код и заголовки технических разделов.

### Проверка оформления

- Все **101 страница** доступны по навигации от главной.
- Проверены **1056 локальных ссылок**, **56 якорей** и **131 таблица**; ошибок не найдено.
- Все **185 файлов материалов**, включая новую обложку, доступны через ссылки.
- Через API GitHub получен HTML десяти страниц. Локальный предпросмотр со стилями Primer проверен в светлой и тёмной теме, на ширинах 1280 и 390 пикселей: **40 вариантов**.
- В предпросмотрах не обнаружены незагруженные изображения или выход страницы за ширину экрана.
- Данные исходных таблиц сохранены при изменении разметки; на главной добавлены маркеры задач, в каталоге изображений — новая обложка. Программные блоки и исходные файлы плат не изменены.

### Почему таблицы не растягиваются принудительно

GitHub удаляет пользовательские стили при обработке Markdown и задаёт таблицам ширину по содержимому с горизонтальной прокруткой при необходимости. Поэтому `width="100%"` у HTML-таблицы не гарантирует растягивание на всю страницу. Пустые картинки и длинные пробелы для растягивания не используются: они ухудшают чтение на телефоне и сопровождение документов.

Источники: [обработка Markdown на GitHub](https://github.com/github/markup), [стили таблиц Primer](https://github.com/primer/css/blob/main/src/markdown/tables.scss).

## Границы проверки

Проверка касается файлов и Markdown-навигации внутри репозитория. Содержимое всех PDF и BOM не сверялось с аппаратными ревизиями, внешняя прошивка не собиралась, платы не испытывались. Наличие документа в каталоге само по себе не подтверждает его совместимость с конкретной платой.
