Dimasssius/DIY_Alliance_NixieClock_Userland/hardcore/assembly/hardcore-boards-x4-tubes/base-configuration/bom/README.md

[Главная](../../../../../README.md) / [Hardcore](../../../../README.md) / [4 индикатора](../../README.md) / [Base](../README.md) / Списки компонентов (BOM)

# 📋 Списки компонентов (BOM)

**Hardcore · 4 индикатора · Base**

Откройте PDF для просмотра или Excel для работы со списком. Сверяйте номиналы, корпуса и количество компонентов со своей сборкой.

| Формат | Файл |
| :---: | :--- |
| **Excel** | [Список компонентов](Bill%20Of%20Materials%20-%20Excell.xlsx) |
| **PDF** | [Список компонентов](Bill%20Of%20Materials%20-%20PDF.PDF) |

Файлы относятся к указанной комплектации Hardcore. Ревизию сверяйте по маркировке платы.

[Вернуться к комплектации](../README.md) · [Начало работы](../../../../../START_HERE.md)
