Dimasssius/DIY_Alliance_NixieClock_Userland/standard/assembly/standard-boards-x4-tubes/bom/Перечень элементов (BOM) - PDF (Выводные компоненты, Вертикальные индикаторы).PDF

Project: | Nixie Clock Avito x4.PrjPcb
Variant: | THD Variation - Vertical Tubes
Author: | Dimasssius
Report Date: | 04.06.2026
# | Designator | Comment | Description | Footprint | Quantity

1 | C1 | 4.7uF | Capacitor, Aluminum Electrolytic Capacitor, Through Hole, D6.3xL12mm, 4.7uF, 400V, ±20%, Aluminum Electrolytic Capacitors - Leaded, ROHS | CAP_THD_ELEC_ALUM_D8.0MM_H12.5MM_SHORT _SMD_C1828_#3_T 1
2 | C8 | 100uF | Capacitor, Aluminum Electrolytic Capacitor, Through Hole, D4xL7mm, 100uF, 6.3V, ±20%, Aluminum Electrolytic Capacitors - Leaded, ROHS | CAP_THD_ELEC_ALUM_D4.0MM_H7.0MM_THD/SMD_THD | 1
3 | C9 | 0.1uF | Capacitor, Ceramic, Through Hole, 50V, 100nF, X7R, ±10%, P=2.54mm, Ceramic Capacitors, RoHS | CAP_THD_CERML | 1
4 | C10, C11 | 0.1uF | Capacitor, Ceramic (MLCC), SMD, 100nF, 6.3V, ±10%, X7R, Multilayer Ceramic Capacitors MLCC - SMD/SMT, ROHS | CAP_SMD_MLCC_C0603_(M1608)_C0402A_(M1005A) | 2
5 | D1 | BYV26C | Diode, DO-41, 600V, 30A, 30ns, Independent, 2.5V@1A, 1A ,Single Diodes ROHS | DO-41/DO-214AC_VERTICAL_SMD/THD_THD | 1
6 | D2 | 1N5819 | Diode Schottky, DO-41, 30A, Independent, 40V, 900mV@3A, 1A, Single Diodes, RoHS | DO-41/DO-214AC_VERTICAL_SMD/THD_THD | 1
7 | D3, D4 | LED0603 | LED Indication - Discrete, 0603, 20mA, 225mcd, Colorless Transparent Lens, -20℃~+85℃, Positive Stick, 620nm~630nm, Red, 120°, 50mW, 2.3V, LED Indication - Discrete, ROHS | LED 0603_(1608)_0402A_(1005) | 2
8 | IC1 | ARD-NANO30NP | Development Board, Arduino Nano v3.0 | ARDNANO30NP | 1
9 | IC2 | K155ID1 | Decoder, DIP-16, 5V±5%, 25mA, 150ns, High Voltage Output, BCD to Decimal Decoders, RoHS | DIP16 | 1
10 | IC3, IC4, IC5, IC6, IC7 | TLP291 | Photovoltaic Output Optoisolator, SOP-4-1.27mm, 80V, 3.75kV, 50mA, 300mV@2.4mA, 8mA, 1, 5V, 1.25V, DC Transistor, Photovoltaic Output Optoisolators, ROHS | SOIC127P700X230-4N | 5
11 | IC8 | DS3231 Mini | Development Board, Real Time Clock | DS3231 Mini - Uspide Down | 1
12 | J1 | Female Header 1x10-Pin | Female Header, 1x10-Pin, 10P, P=2.54mm, Direct Insert, H:8.5mm, W:2.54mm, D:3.2mm, Single Row, Black Brass, Top Square, Hole Plugin, 3A, 20mΩ, 1000V, -40℃~+105℃, Female Headers, ROHS | HEADER_FEMALE_10PIN | 1
13 | J2 | Female Header 1x8-Pin | Female Header, 1x8-Pin, 8P, P=2.54mm, Direct Insert, H:8.5mm, W:2.54mm, D:3.2mm, Single Row, Black Brass, Top Square, Hole Plugin, 3A, 20mΩ, 1000V, -40℃~+105℃, Female Headers, ROHS | HEADER_FEMALE_8PIN | 1
14 | J4 | U254-051N-4BH806 | USB Connector, 1.8A, USB 2.0, Horizontal Attachment, 5P, Female, -20℃~+85℃, Micro-B, SMD, USB Connectors, ROHS | USB_MIICRO_HORIZONTAL_3 | 1
15 | L1 | XR6*8-151K-L | Fixed Inductor, Through Hole, D6xL8mm, 150uH, ±10%, 500mA, 780mΩ, Drum-core Inductor, Fixed Inductors, RoHS | XR6*8-151K-L_FNR6045S151MT_THD | 1
16 | LS1 | FUET-4020 | Buzzer, SMD, 4x4mm, 65dB, Passive (Externally Driven), Electromagnetic, 4kHz, Buzzers ROHS | FUET-4020 | 1
17 | Q1 | STP20NF20 | MOSFET (N-Channel), TO-220, 200V, 18A, 30W, 125mΩ@10V, 1 N-Channel, Single FETs, MOSFETs, RoHS | TO-220/DPAK_THD/SMD_THD_#1 | 1
18 | Q2 | MMBTA42 | Transistor Bipolar (BJT), NPN, SOT-23, 300V, 225mW, 25@10mA, 10V, 500mA, NPN Bipolar (BJT), ROHS | SOT105P255X140-3N | 1
19 | R1, R3, R7, R15 | 10kΩ | Resistor, Metal Film Resistor, Through Hole, D2.3xL6.5mm, 10kΩ, ±1%, 250mW, Through Hole Resistors, ROHS | RES_THD/SMD_VERTICAL_R0603_R0402_10K_THD | 4
20 | R2 | 1kΩ | Resistor, Metal Film Resistor, Through Hole, D2.3xL6.5mm, 1kΩ, ±1%, 250mW, Through Hole Resistors, ROHS | RES_THD/SMD_VERTICAL_R0603_R0402_1K_THD | 1
21 | R4 | 680kΩ | Resistor, Metal Film Resistor, Through Hole, D2.3xL6.5mm, 680kΩ, ±1%, 250mW, Through Hole Resistors, ROHS | RES_THD/SMD_VERTICAL_R0603_R0402_680K_THD | 1
22 | R5 | 100Ω | Resistor, Metal Film Resistor, Through Hole, D2.3xL6.5mm, 100Ω, ±1%, 250mW, Through Hole Resistors, ROHS | RES_THD/SMD_VERTICAL_R0603_R0402_100OHM_THD | 1
23 | R6 | 10kΩ | Resistor, Metal Film Resistor, Through Hole, D2.3xL6.5mm, 10kΩ, ±1%, 250mW, Through Hole Resistors, ROHS | RES_THD/SMD_R0603_R0402_10K_THD | 1
24 | R8 | 470Ω | Resistor, Metal Film Resistor, Through Hole, D2.3xL6.5mm, 470Ω, ±1%, 250mW, Through Hole Resistors, ROHS | RES_THD/SMD_VERTICAL_R0603_R0402_470OHM_THD | 1
25 | R9 | 4.7kΩ | Resistor, Metal Film Resistor, Through Hole, D2.3xL6.5mm, 4.7kΩ, ±1%, 250mW, Through Hole Resistors, ROHS | RES_THD/SMD_VERTICAL_R0603_R0402_4.7K_THD | 1
26 | R12 | 3kΩ | Resistor, Metal Film Resistor, Through Hole, D2.3xL6.5mm, 3kΩ, ±1%, 250mW, Through Hole Resistors, ROHS | RES_THD/SMD_VERTICAL_R0603_R0402_3K_THD | 1
27 | R13 | 33kΩ | Resistor, Metal Film Resistor, Through Hole, D2.3xL6.5mm, 33kΩ, ±1%, 250mW, Through Hole Resistors, ROHS | RES_THD/SMD_VERTICAL_R0603_R0402_33K_THD | 1
28 | R14 | 56kΩ | Resistor, Metal Film Resistor, Through Hole, D2.3xL6.5mm, 56kΩ, ±1%, 250mW, Through Hole Resistors, ROHS | RES_THD/SMD_VERTICAL_R0603_R0402_56K_THD | 1
29 | R17 | 200Ω | Resistor, Metal Film Resistor, Through Hole, D2.3xL6.5mm, 200Ω, ±1%, 250mW, Through Hole Resistors, ROHS | RES_THD/SMD_VERTICAL_R0603_R0402_200OHM_THD | 1
30 | R18 | 5.1kΩ | Resistor, Thick Film Resistor, SMD, 5.1kΩ, ±5%, Chip Resistor - Surface Mount, ROHS | RES_SMD_R0603_(M1608)_R0402A_(M1005A) | 1
31 | R19 | 10Ω | Resistor, Thick Film Resistor, SMD, 10Ω, ±5%, Chip Resistor - Surface Mount, ROHS | RES_SMD_R0603_(M1608)_R0402A_(M1005A) | 1
32 | R20 | 100Ω | Resistor, Thick Film Resistor, SMD, 100Ω, ±5%, Chip Resistor - Surface Mount, ROHS | RES_SMD_R0603_(M1608)_R0402A_(M1005A) | 1
33 | R21, R22, R23, R24 | 1kΩ | Resistor, Thick Film Resistor, SMD, 1kΩ, ±5%, Chip Resistor - Surface Mount, ROHS | RES_SMD_R0603_(M1608)_R0402A_(M1005A) | 4
34 | S3, S6, S9, S12 | EVQPF108K | Switch Tactile, Through Hole, 6.2mm, 5mm, With bracket, 50mA, Round Button, Bend-in 6.2mm, SPST 50,000 times, 12V, 250gf, Plugin Tactile Switches, ROHS | EVQPF008K | 4
35 | S13 | BME280 | Development Board, LGA-8(2.5x2.5), Temperature and Humidity Sensor, ROHS | BME280_DEVBOARD | 1
36 | U1 | CH340C | USB Converter, SOP-16, 2Mbps Transceiver, USB 2.0, USB Converters, ROHS | SOIC127P600X180-16N | 1
Notes | 51

# Component list

Перечень элементов (BOM) - PDF (Выводные компоненты, Вертикальные индикаторы) for Variant [THD Variation - Vertical Tubes] of Project [Nixie Clock Avito x4.PrjPcb] (N
