Dimasssius/DIY_Alliance_NixieClock_Userland/standard/assembly/standard-boards-x6-tubes/bom/Перечень элементов (BOM) - PDF (Выводные компоненты, Вертикальные индикаторы).PDF

Project: | Nixie Clock Avito x6.PrjPcb
Variant: | THD Variation - Vertical Tubes
Author: | Dimasssius
Report Date: | 04.06.2026
# | Designator | Comment | Description | Footprint | Quantity

1 | C1 | 4.7uF | Capacitor, Aluminum Electrolytic Capacitor, Through Hole, D6.3xL12mm, 4.7uF, 400V, ±20%, Aluminum Electrolytic Capacitors - Leaded, ROHS | CAP_THD_ELEC_ALUM_D8.0MM_H12.5MM_SHORT _SMD_C1828_#2_T 1
2 | C2 | 0.1uF | Capacitor, Ceramic, Through Hole, 50V, 100nF, X7R, ±10%, P=2.54mm, Ceramic Capacitors, RoHS | CAP_THD_CERML | 1
3 | C3 | 100uF | Capacitor, Aluminum Electrolytic Capacitor, Through Hole, D4xL7mm, 100uF, 6.3V, ±20%, Aluminum Electrolytic Capacitors - Leaded, ROHS | CAP_THD_ELEC_ALUM_D4.0MM_H7.0MM_THD/SMD_THD | 1
4 | C5, C6 | 0.1uF | Capacitor, Ceramic (MLCC), SMD, 100nF, 6.3V, ±10%, X7R, Multilayer Ceramic Capacitors MLCC - SMD/SMT, ROHS | CAP_SMD_MLCC_C0603_(M1608)_C0402A_(M1005A) | 2
5 | D1 | BYV26C | Diode, DO-41, 600V, 30A, 30ns, Independent, 2.5V@1A, 1A ,Single Diodes ROHS | DO-41/DO-214AC_THD/SMD_THD | 1
6 | D2 | 1N5819 | Diode Schottky, DO-41, 30A, Independent, 40V, 900mV@3A, 1A, Single Diodes, RoHS | DO-41/DO-214AC_VERTICAL_SMD/THD_THD | 1
7 | D3, D4 | LED0603 | LED Indication - Discrete, 0603, 20mA, 225mcd, Colorless Transparent Lens, -20℃~+85℃, Positive Stick, 620nm~630nm, Red, 120°, 50mW, 2.3V, LED Indication - Discrete, ROHS | LED 0603_(1608)_0402A_(1005) | 2
8 | IC1 | K155ID1 | Decoder, DIP-16, 5V±5%, 25mA, 150ns, High Voltage Output, BCD to Decimal Decoders, RoHS | DIP16 | 1
9 | IC2, IC3, IC4, IC5, IC6, IC7, IC8 | TLP291 | Photovoltaic Output Optoisolator, SOP-4-1.27mm, 80V, 3.75kV, 50mA, 300mV@2.4mA, 8mA, 1, 5V, 1.25V, DC Transistor, Photovoltaic Output Optoisolators, ROHS | SOIC127P700X230-4N | 7
10 | IC9 | DS3231 Mini | Development Board, Real Time Clock | DS3231 Mini - Uspide Down | 1
11 | IC11 | DHT11 | Temperature and Humidity Sensor, SIP-4, ROHS | DHT11 - SMD | 1
12 | IC12 | DS18B20+ | Temperature Sensor, THD, TO-92, 3V~5.5V, -55℃~+125℃, ±0.5, Single Bus, RoHS | TO-92 | 1
13 | IC14 | ARD-NANO30NP | Development Board, Arduino Nano v3.0 | ARDNANO30NP | 1
14 | J1, J2 | Female Header 1x10-Pin | Female Header, 1x10-Pin, 10P, P=2.54mm, Direct Insert, H:8.5mm, W:2.54mm, D:3.2mm, Single Row, Black Brass, Top Square, Hole Plugin, 3A, 20mΩ, 1000V, -40℃~+105℃, Female Headers, ROHS | HEADER_FEMALE_10PIN | 2
15 | J3, J4 | Female Header 1x3-Pin | Female Header, 1x3-Pin, 3P, P=2.54mm, Direct Insert, H:8.5mm, W:2.54mm, D:3.2mm, Single Row, Black Brass, Top Square, Hole Plugin, 3A, 20mΩ, 1000V, -40℃~+105℃, Female Headers, ROHS | HEADER_FEMALE_3PIN | 2
16 | J9 | U254-051N-4BH806 | USB Connector, 1.8A, USB 2.0, Horizontal Attachment, 5P, Female, -20℃~+85℃, Micro-B, SMD, USB Connectors, ROHS | USB_MIICRO_HORIZONTAL_3 | 1
17 | L1 | XR6*8-151K-L | Fixed Inductor, Through Hole, D6xL8mm, 150uH, ±10%, 500mA, 780mΩ, Drum-core Inductor, Fixed Inductors, RoHS | XR6*8-151K-L_CDRH74N_THD | 1
18 | LS1 | CMI-9605-0580T | Buzzer, D=9.6mm, 80dB, Active (Built-in Driver Circuit, Electromagnetic Type, 2.7kHz, Plugin, Buzzers, ROHS | CMI96050580T | 1
19 | Q1 | STP20NF20 | MOSFET (N-Channel), TO-220, 200V, 18A, 30W, 125mΩ@10V, 1 N-Channel, Single FETs, MOSFETs, RoHS | TO-220/DPAK_THD/SMD_THD_#2 | 1
20 | Q2 | MPSA42 | Transistor Bipolar (BJT), NPN, TO-92-3, 300V, 625mW, 25@1.0mA, 10V, 500mA, Bipolar (BJT), ROHS | TO-92 | 1
21 | R1, R2, R6, R8, R14 | 10kΩ | Resistor, Metal Film Resistor, Through Hole, D2.3xL6.5mm, 10kΩ, ±1%, 250mW, Through Hole Resistors, ROHS | RES_THD/SMD_R0603_R0402_10K_THD | 5
22 | R3 | 1kΩ | Resistor, Metal Film Resistor, Through Hole, D2.3xL6.5mm, 1kΩ, ±1%, 250mW, Through Hole Resistors, ROHS | RES_THD/SMD_R0603_R0402_1K_THD | 1
23 | R4 | 680kΩ | Resistor, Metal Film Resistor, Through Hole, D2.3xL6.5mm, 680kΩ, ±1%, 250mW, Through Hole Resistors, ROHS | RES_THD/SMD_R0603_R0402_680K_THD | 1
24 | R5, R10 | 100Ω | Resistor, Metal Film Resistor, Through Hole, D2.3xL6.5mm, 100Ω, ±1%, 250mW, Through Hole Resistors, ROHS | RES_THD/SMD_R0603_R0402_100OHM_THD | 2
25 | R7 | 470Ω | Resistor, Metal Film Resistor, Through Hole, D2.3xL6.5mm, 470Ω, ±1%, 250mW, Through Hole Resistors, ROHS | RES_THD/SMD_R0603_R0402_470OHM_THD | 1
26 | R11 | 3kΩ | Resistor, Metal Film Resistor, Through Hole, D2.3xL6.5mm, 3kΩ, ±1%, 250mW, Through Hole Resistors, ROHS | RES_THD/SMD_R0603_R0402_3K_THD | 1
27 | R12 | 33kΩ | Resistor, Metal Film Resistor, Through Hole, D2.3xL6.5mm, 33kΩ, ±1%, 250mW, Through Hole Resistors, ROHS | RES_THD/SMD_R0603_R0402_33K_THD | 1
28 | R13 | 56kΩ | Resistor, Metal Film Resistor, Through Hole, D2.3xL6.5mm, 56kΩ, ±1%, 250mW, Through Hole Resistors, ROHS | RES_THD/SMD_R0603_R0402_56K_THD | 1
29 | R15 | 200Ω | Resistor, Metal Film Resistor, Through Hole, D2.3xL6.5mm, 200Ω, ±1%, 250mW, Through Hole Resistors, ROHS | RES_THD/SMD_R0603_R0402_200OHM_THD | 1
30 | R16, R23 | 4.7kΩ | Resistor, Metal Film Resistor, Through Hole, D2.3xL6.5mm, 4.7kΩ, ±1%, 250mW, Through Hole Resistors, ROHS | RES_THD/SMD_R0603_R0402_4.7K_THD | 2
31 | R19, R20, R21, R22 | 1kΩ | Resistor, Thick Film Resistor, SMD, 1kΩ, ±5%, Chip Resistor - Surface Mount, ROHS | RES_SMD_R0603_(M1608)_R0402A_(M1005A) | 4
32 | R? | 5.1kΩ | Resistor, Thick Film Resistor, SMD, 5.1kΩ, ±5%, Chip Resistor - Surface Mount, ROHS | RES_SMD_R0603_(M1608)_R0402A_(M1005A) | 1
33 | S3, S7, S11, S15 | EVQPF108K | Switch Tactile | EVQPF008K | 4
34 | S17 | BME280 | Development Board, LGA-8(2.5x2.5), Temperature and Humidity Sensor, ROHS | BME280_DEVBOARD | 1
35 | U1 | CH340C | USB Converter, SOP-16, 2Mbps Transceiver, USB 2.0, USB Converters, ROHS | SOIC127P600X180-16N | 1
Notes | 57

# Component list

Перечень элементов (BOM) - PDF (Выводные компоненты, Вертикальные индикаторы) for Variant [THD Variation - Vertical Tubes] of Project [Nixie Clock Avito x6.PrjPcb] (N
