Dimasssius/DIY_Alliance_NixieClock_Userland/standard/assembly/standard-boards-x6-tubes/bom/Перечень элементов (BOM) - PDF (Поверхностный монтаж, Вертикальные индикаторы).PDF

Project: | Nixie Clock Avito x6.PrjPcb
Variant: | SMD Variation - Vertical Tubes
Author: | Dimasssius
Report Date: | 04.06.2026
# | Designator | Comment | Description | Footprint | Quantity

1 | B1 | CR1025 | Battery Clip Coin, SMD, CR1025, Cell | CR1025 | 1
2 | C1 | 1uF | Capacitor, Ceramic (MLCC), SMD, 1uF, 250V, ±10%, X7R, Multilayer Ceramic Capacitors MLCC - SMD/SMT, ROHS | CAP_THD_ELEC_ALUM_D8.0MM_H12.5MM_SHORT _SMD_C1828_#2_SMD 1
3 | C2 | 0.1uF | Capacitor, Ceramic (MLCC), SMD, 100nF, 6.3V, ±10%, X7R, Multilayer Ceramic Capacitors MLCC - SMD/SMT, ROHS | CAP_SMD_MLCC_C0603_(M1608)_C0402A_(M1005A)_THD/SMD_SMD 1
4 | C3 | 100uF | Capacitor, Aluminum Electrolytic Capacitor, SMD, D5xL5.4mm, 100uF, 6.3V, ±20%, Aluminum Electrolytic Capacitors - SMD, ROHS | CAP_THD_ELEC_ALUM_D4.0MM_H7.0MM_THD/SMD_SMD | 1
5 | C4, C5, C6, C7, C8, C9 | 0.1uF | Capacitor, Ceramic (MLCC), SMD, 100nF, 6.3V, ±10%, X7R, Multilayer Ceramic Capacitors MLCC - SMD/SMT, ROHS | CAP_SMD_MLCC_C0603_(M1608)_C0402A_(M1005A) | 6
6 | C10, C11 | 22pF | Capacitor, Ceramic (MLCC), SMD, 22pF, 50V, ±5%, C0G, Multilayer Ceramic Capacitors MLCC - SMD/SMT, ROHS | CAP_SMD_MLCC_C0603_(M1608)_C0402A_(M1005A) | 2
7 | D1 | ES2J | Diode, SMD, SMA(DO-214AC), 600V, 2A, 35ns, 1.7V@2A, Fast Recovery / High Efficiency Diodes, ROHS | DO-41/DO-214AC_THD/SMD_SMD | 1
8 | D2 | SS12 | Diode Schottky, SMD, SMA(DO-214AC), 20V, 1A, 500mV@1A, Schottky Diodes, ROHS | DO-41/DO-214AC_VERTICAL_SMD/THD_SMD | 1
9 | D3, D4 | LED0603 | LED Indication - Discrete, 0603, 20mA, 225mcd, Colorless Transparent Lens, -20℃~+85℃, Positive Stick, 620nm~630nm, Red, 120°, 50mW, 2.3V, LED Indication - Discrete, ROHS | LED 0603_(1608)_0402A_(1005) | 2
10 | IC1 | K155ID1 | Decoder, DIP-16, 5V±5%, 25mA, 150ns, High Voltage Output, BCD to Decimal Decoders, RoHS | DIP16 | 1
11 | IC2, IC3, IC4, IC5, IC6, IC7, IC8 | TLP291 | Photovoltaic Output Optoisolator, SOP-4-1.27mm, 80V, 3.75kV, 50mA, 300mV@2.4mA, 8mA, 1, 5V, 1.25V, DC Transistor, Photovoltaic Output Optoisolators, ROHS | SOIC127P700X230-4N | 7
12 | IC10 | DS3231SN | Real Time Clock, SOIC-16-300mil, I2C, Real Time Clocks, ROHS | SOIC127P1032X265-16N | 1
13 | IC11 | DHT11 | Temperature and Humidity Sensor, SIP-4, ROHS | DHT11 - SMD | 1
14 | IC12 | DS18B20+ | Temperature Sensor, THD, TO-92, 3V~5.5V, -55℃~+125℃, ±0.5, Single Bus, RoHS | TO-92 | 1
15 | IC13 | ATMEGA328P-AU | Microcontroller, TQFP-32(7x7), AVR, 20MHz, Microcontrollers (MCU/MPU/SOC), ROHS | QFP80P900X900X120-32N WITH SPI INTERFACE 2.54 | 1
16 | J1, J2 | Female Header 1x10-Pin | Female Header, 1x10-Pin, 10P, P=2.54mm, Direct Insert, H:8.5mm, W:2.54mm, D:3.2mm, Single Row, Black Brass, Top Square, Hole Plugin, 3A, 20mΩ, 1000V, -40℃~+105℃, Female Headers, ROHS | HEADER_FEMALE_10PIN | 2
17 | J3, J4 | Female Header 1x3-Pin | Female Header, 1x3-Pin, 3P, P=2.54mm, Direct Insert, H:8.5mm, W:2.54mm, D:3.2mm, Single Row, Black Brass, Top Square, Hole Plugin, 3A, 20mΩ, 1000V, -40℃~+105℃, Female Headers, ROHS | HEADER_FEMALE_3PIN | 2
18 | J8 | TYPE-C 16PIN 2MD(073) | USB Connector, 5A, USB 3.1, Horizontal Attachment, 16P, Female, -25℃~+85℃, Type-C, SMD, USB Connectors, ROHS | USB_C_DOUBLE_V/H_HORIZONTAL | 1
19 | L1 | XR6*8-151K-L | Fixed Inductor, Through Hole, D6xL8mm, 150uH, ±10%, 500mA, 780mΩ, Drum-core Inductor, Fixed Inductors, RoHS | XR6*8-151K-L_CDRH74N_THD | 1
20 | LS1 | CMI-9605-0580T | Buzzer, D=9.6mm, 80dB, Active (Built-in Driver Circuit, Electromagnetic Type, 2.7kHz, Plugin, Buzzers, ROHS | CMI96050580T | 1
21 | Q1 | STD20NF20 | MOSFET (N-Channel), DPAK, 200V, 18A, 30W, 125mΩ@10V, 1 N-Channel, Single FETs, MOSFETs, RoHS | TO-220/DPAK_THD/SMD_SMD_#2 | 1
22 | Q2 | MPSA42 | Transistor Bipolar (BJT), NPN, TO-92-3, 300V, 625mW, 25@1.0mA, 10V, 500mA, Bipolar (BJT), ROHS | TO-92 | 1
23 | R1, R2, R6, R8, R14 | 10kΩ | Resistor, Thick Film Resistor, SMD, 10kΩ, ±5%, Chip Resistor - Surface Mount, ROHS | RES_THD/SMD_R0603_R0402_10K_SMD | 5
24 | R3 | 1kΩ | Resistor, Thick Film Resistor, SMD, 1kΩ, ±5%, Chip Resistor - Surface Mount, ROHS | RES_THD/SMD_R0603_R0402_1K_SMD | 1
25 | R4 | 680kΩ | Resistor, Thick Film Resistor, SMD, 680kΩ, ±5%, Chip Resistor - Surface Mount, ROHS | RES_THD/SMD_R0603_R0402_680K_SMD | 1
26 | R5, R10 | 100Ω | Resistor, Thick Film Resistor, SMD, 100Ω, ±5%, Chip Resistor - Surface Mount, ROHS | RES_THD/SMD_R0603_R0402_100OHM_SMD | 2
27 | R7 | 470Ω | Resistor, Thick Film Resistor, SMD, 470Ω, ±5%, Chip Resistor - Surface Mount, ROHS | RES_THD/SMD_R0603_R0402_470OHM_SMD | 1
28 | R11 | 3kΩ | Resistor, Thick Film Resistor, SMD, 3kΩ, ±5%, Chip Resistor - Surface Mount, ROHS | RES_THD/SMD_R0603_R0402_3K_SMD | 1
29 | R12 | 33kΩ | Resistor, Thick Film Resistor, SMD, 33kΩ, ±5%, Chip Resistor - Surface Mount, ROHS | RES_THD/SMD_R0603_R0402_33K_SMD | 1
30 | R13 | 56kΩ | Resistor, Thick Film Resistor, SMD, 56kΩ, ±5%, Chip Resistor - Surface Mount, ROHS | RES_THD/SMD_R0603_R0402_56K_SMD | 1
31 | R15 | 200Ω | Resistor, Thick Film Resistor, SMD, 200Ω, ±5%, Chip Resistor - Surface Mount, ROHS | RES_THD/SMD_R0603_R0402_200OHM_SMD | 1
32 | R16, R23 | 4.7kΩ | Resistor, Thick Film Resistor, SMD, 4.7kΩ, ±5%, Chip Resistor - Surface Mount, ROHS | RES_THD/SMD_R0603_R0402_4.7K_SMD | 2
33 | R17, R18 | 4.7kΩ | Resistor, Thick Film Resistor, SMD, 4.7kΩ, ±5%, Chip Resistor - Surface Mount, ROHS | RES_SMD_R0603_(M1608)_R0402A_(M1005A) | 2
34 | R19, R20, R21, R22 | 1kΩ | Resistor, Thick Film Resistor, SMD, 1kΩ, ±5%, Chip Resistor - Surface Mount, ROHS | RES_SMD_R0603_(M1608)_R0402A_(M1005A) | 4
35 | R24 | 10kΩ | Resistor, Thick Film Resistor, SMD, 10kΩ, ±5%, Chip Resistor - Surface Mount, ROHS | RES_SMD_R0603_(M1608)_R0402A_(M1005A) | 1
36 | R? | 5.1kΩ | Resistor, Thick Film Resistor, SMD, 5.1kΩ, ±5%, Chip Resistor - Surface Mount, ROHS | RES_SMD_R0603_(M1608)_R0402A_(M1005A) | 1
37 | S1, S5, S9, S13 | TS-1009B | Switch Tactile, Through Hole, 4.5x4.5mm, Round Button, 50mA, Bend-in 4.5mm, SPST, 12V, Plugin, Tactile Switches, ROHS | TS-1009B | 4
38 | S17 | BME280 | Development Board, LGA-8(2.5x2.5), Temperature and Humidity Sensor, ROHS | BME280_DEVBOARD | 1
39 | U1 | CH340C | USB Converter, SOP-16, 2Mbps Transceiver, USB 2.0, USB Converters, ROHS | SOIC127P600X180-16N | 1
40 | Y1 | X322516MLB4SI | Crystal Oscillator, SMD, 3225(3.2x2.5), 9pF, Crystals ROHS | XTL_4_3225 | 1
Notes | 68

# Component list

Перечень элементов (BOM) - PDF (Поверхностный монтаж, Вертикальные индикаторы) for Variant [SMD Variation - Vertical Tubes] of Project [Nixie Clock Avito x6.PrjPcb]
