Dimasssius/DIY_Alliance_NixieClock_Userland/hardcore/assembly/hardcore-boards-x4-tubes/minimal-configuration/bom/Bill Of Materials - PDF.PDF

Project: | Nixie Clock Avito x4 - SMD.PrjPcb
Variant: | Minimal Configuration
Author: | Dimasssius
Report Date: | 04.06.2026
# | Designator | Comment | Description | Footprint | Quantity

1 | B1 | CR1025 | Battery Clip Coin, SMD, CR1025, Cell | CR1025 | 1
2 | C1 | 1uF | Capacitor, Ceramic (MLCC), SMD, 1uF, 250V, ±10%, X7R, Multilayer Ceramic Capacitors MLCC - SMD/SMT, ROHS | CAP_SMD_MLCC_C1812_(M4532) | 1
3 | C2, C15, C17, C18, C22, C25 | 0.1uF | Capacitor, Ceramic (MLCC), SMD, 100nF, 6.3V, ±10%, X7R, Multilayer Ceramic Capacitors MLCC - SMD/SMT, ROHS | CAP_SMD_MLCC_C0603_(M1608)_C0402A_(M1005A) | 6
4 | C3 | 22uF | Capacitor, Ceramic (MLCC), SMD, 22uF, 6.3V, ±20%, X5R, Multilayer Ceramic Capacitors MLCC - SMD/SMT, ROHS | CAP_SMD_MLCC_C0603_(M1608) | 1
5 | C4, C11 | 0.22uF | Capacitor, Ceramic (MLCC), SMD, 220nF, 6.3V, ±10%, X7R, Multilayer Ceramic Capacitors MLCC - SMD/SMT, ROHS | CAP_SMD_MLCC_C0603_(M1608)_C0402A_(M1005A) | 2
6 | C12 | 1uF | Capacitor, Ceramic (MLCC), SMD, 1uF, 6.3V, ±10%, X5R, Multilayer Ceramic Capacitors MLCC - SMD/SMT, ROHS | CAP_SMD_MLCC_C0603_(M1608)_C0402A_(M1005A) | 1
7 | C23 | 100uF | Capacitor, Aluminum Electrolytic Capacitor, SMD, D5xL5.4mm, 100uF, 6.3V, ±20%, Aluminum Electrolytic Capacitors - SMD, ROHS | CAP_SMD_ELEC_ALUM_5MM_H5.4MM | 1
8 | D1 | US1M | Diode, SMD, SMA(DO-214AC), 1kV, 1A, 75ns, 1.65V@1A, Independent Type, SMA, Fast Recovery / High Efficiency Diodes, ROHS | DO-214AC | 1
9 | D4 | SS12 | Diode Schottky, SMD, SMA(DO-214AC), 20V, 1A, 500mV@1A, Schottky Diodes, ROHS | DO-214AC | 1
10 | IC1, IC2, IC3, IC4, IC5 | TLP291 | Photovoltaic Output Optoisolator, SOP-4-1.27mm, 80V, 3.75kV, 50mA, 300mV@2.4mA, 8mA, 1, 5V, 1.25V, DC Transistor, Photovoltaic Output Optoisolators, ROHS | SOIC127P700X230-4N | 5
11 | IC6 | 74HC595D | Shift Register, SOIC-16, Serial To Serial Or Parallel Shift Register, ROHS | SOIC127P600X175-16N | 1
12 | IC9 | MAX668 | AC-DC Controller and Regulator, MSOP-10, 100kHz~500kHz, 3V~28V, AC-DC Controllers and Regulators, ROHS | SOP50P490X110-10N | 1
13 | IC10 | ATMEGA328P-AU | Microcontroller, TQFP-32(7x7), AVR, 20MHz, Microcontrollers (MCU/MPU/SOC), ROHS | QFP80P900X900X120-32N WITH SPI INTERFACE 2.54 | 1
14 | IC12 | DS3231SN | Real Time Clock, SOIC-16-300mil, I2C, Real Time Clocks, ROHS | SOIC127P1032X265-16N | 1
15 | IC14 | K155ID1 | Decoder, DIP-16, 5V±5%, 25mA, 150ns, High Voltage Output, BCD to Decimal Decoders, RoHS | DIP16 | 1
16 | J1, J3 | Female Header 1x10-Pin | Female Header, 1x10-Pin, 10P, P=2.54mm, Direct Insert, H:8.5mm, W:2.54mm, D:3.2mm, Single Row, Black Brass, Top Square, Hole Plugin, 3A, 20mΩ, 1000V, -40℃~+105℃, Female Headers, ROHS | HEADER_FEMALE_10PIN | 2
17 | J2 | USB_C | USB Connector, 5A, USB 3.1, 1 Horizontal Attachment, 16P, Female, -25℃~+85℃, Type-C, SMD, USB Connectors, ROHS | USB_C_DOUBLE | 1
18 | Q3 | AON7264E | MOSFET (N-Channel), DFN-8(3x3), 60V, 28A, 11W, 13.3mΩ@4.5V, 28A, 1.8V, 1 N-channel, MOSFETs, ROHS | DFN-8-EP(3x3) | 1
19 | R2, R8 | 33kΩ | Resistor, Thick Film Resistor, SMD, 33kΩ, ±5%, Chip Resistor - Surface Mount, ROHS | RES_SMD_R0603_(M1608)_R0402A_(M1005A) | 2
20 | R3 | 470Ω | Resistor, Thick Film Resistor, SMD, 470Ω, ±5%, Chip Resistor - Surface Mount, ROHS | RES_SMD_R0603_(M1608)_R0402A_(M1005A) | 1
21 | R4, R25, R27 | 10kΩ | Resistor, Thick Film Resistor, SMD, 10kΩ, ±5%, Chip Resistor - Surface Mount, ROHS | RES_SMD_R0603_(M1608)_R0402A_(M1005A) | 3
22 | R10 | 3kΩ | Resistor, Thick Film Resistor, SMD, 3kΩ, ±5%, Chip Resistor - Surface Mount, ROHS | RES_SMD_R0603_(M1608)_R0402A_(M1005A) | 1
23 | R12 | 0.1Ω | Resistor, Thick Film Resistor, SMD, 0.1Ω, ±5%, Chip Resistor - Surface Mount, ROHS | RES_SMD_R1206_(M3216) | 1
24 | R14 | 1.5MΩ | Resistor, Thick Film Resistor, SMD, 1.5MΩ, ±5%, Chip Resistor - Surface Mount, ROHS | RES_SMD_R0603_(M1608)_R0402A_(M1005A) | 1
25 | R17 | 8.2kΩ | Resistor, Thick Film Resistor, SMD, 8.2kΩ, ±5%, Chip Resistor - Surface Mount, ROHS | RES_SMD_R0603_(M1608)_R0402A_(M1005A) | 1
26 | R19 | 3kΩ | Resistor, Potentiometer, SMD, SMD-3P, 3.9x3.1mm, Potentiometer, 3kΩ, ±25%, 150mW, Potentiometers, Variable Resistors, ROHS | TC33X | 1
27 | R20 | 499kΩ | Resistor, Thick Film Resistor, SMD, 499kΩ, ±5%, Chip Resistor - Surface Mount, ROHS | RES_SMD_R0603_(M1608)_R0402A_(M1005A) | 1
28 | R22 | 200Ω | Resistor, Thick Film Resistor, SMD, 200Ω, ±5%, Chip Resistor - Surface Mount, ROHS | RES_SMD_R0603_(M1608)_R0402A_(M1005A) | 1
29 | R28 | 5.1kΩ | Resistor, Thick Film Resistor, SMD, 5.1kΩ, ±5%, Chip Resistor - Surface Mount, ROHS | RES_SMD_R0603_(M1608)_R0402A_(M1005A) | 1
30 | R29, R30, R32 | 4.7kΩ | Resistor, Thick Film Resistor, SMD, 4.7kΩ, ±5%, Chip Resistor - Surface Mount, ROHS | RES_SMD_R0603_(M1608)_R0402A_(M1005A) | 3
31 | S2, S3, S4 | TS-1009B | Switch Tactile Through Hole, 4.5x4.5mm, Round Button, 50mA, Bend-in 4.5mm, SPST, 12V, Plugin, Tactile Switches, ROHS | TS-1009B | 3
32 | S5 | TSA016A2518C | Switch Tactile SMD, 3.35x2.5mm, Oval button, 50mA, Standing paste, 4.2mm ,180gf, 12V, SMD Tactile Switches, ROHS | TS20 | 1
33 | S7, S8, S9 | TS-1187A-B-A-B | Switch Tactile SMD, 5.1x5.1mm, Without bracket, 50mA, 100000 Times, 160gf, 12V, Round, SMD Tactile Switches, ROHS | TS-1187A-B-A-B | 3
34 | TR1 | EE0504S | Power Transformer, SMD-5P, 1:10, 6.4x6.4mm, Power Transformers, ROHS | EE0504S | 1
35 | Y2 | CSTCE16M0V53-R0 | Ceramic Resonators, SMD, SMD3213-3P, 3.2x1.3mm,16MHz, 15pF, 40Ω, Ceramic Resonators, ROHS | XTL_3_3213 | 1
Notes | 55

# Component list

Bill Of Materials - PDF for Variant [Minimal Configuration] of Project [Nixie Clock Avito x4 - SMD.PrjPcb] (No PCB Document Selected)
