Dimasssius/DIY_Alliance_NixieClock_Userland/standard/assembly/standard-boards-x4-tubes/bom/README.md

[Главная](../../../../README.md) / [Standard](../../../README.md) / [4 индикатора](../README.md) / Списки компонентов (BOM)

# 📋 Списки компонентов (BOM)

**Standard · 4 индикатора**

Откройте PDF для просмотра или Excel для работы со списком. Сверяйте номиналы, корпуса и количество компонентов со своей сборкой.

| Вариант сборки | PDF | Excel |
| :--- | :---: | :---: |
| Выводной · вертикальные индикаторы | [PDF](Перечень%20элементов%20%28BOM%29%20-%20PDF%20%28Выводные%20компоненты%2C%20Вертикальные%20индикаторы%29.PDF) | [Excel](Перечень%20элементов%20%28BOM%29%20-%20Excell%20%28Выводные%20компоненты%2C%20Вертикальные%20индикаторы%29.xlsx) |
| Выводной · горизонтальные индикаторы | [PDF](Перечень%20элементов%20%28BOM%29%20-%20PDF%20%28Выводные%20компоненты%2C%20Горизонтальные%20индикаторы%29.PDF) | [Excel](Перечень%20элементов%20%28BOM%29%20-%20Excell%20%28Выводные%20компоненты%2C%20Горизонтальные%20индикаторы%29.xlsx) |
| SMD · вертикальные индикаторы | [PDF](Перечень%20элементов%20%28BOM%29%20-%20PDF%20%28Поверхностный%20монтаж%2C%20Вертикальные%20индикаторы%29.PDF) | [Excel](Перечень%20элементов%20%28BOM%29%20-%20Excell%20%28Поверхностный%20монтаж%2C%20Вертикальные%20индикаторы%29.xlsx) |
| SMD · горизонтальные индикаторы | [PDF](Перечень%20элементов%20%28BOM%29%20-%20PDF%20%28Поверхностный%20монтаж%2C%20Горизонтальные%20индикаторы%29.PDF) | [Excel](Перечень%20элементов%20%28BOM%29%20-%20Excell%20%28Поверхностный%20монтаж%2C%20Горизонтальные%20индикаторы%29.xlsx) |

Выбирайте один вариант монтажа и ориентации индикаторов во всех документах. Ревизию сверяйте по маркировке платы.

[Вернуться к материалам платы](../README.md) · [Начало работы](../../../../START_HERE.md)
