Dimasssius/DIY_Alliance_NixieClock_Userland/standard/assembly/standard-boards-x6-tubes/export-step/3D Модель - STEP (Поверхностный монтаж, Вертикальные индикаторы).step

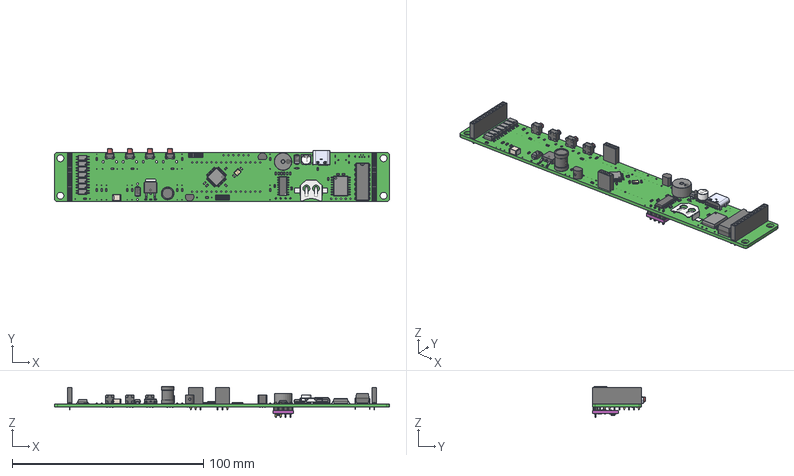
[picture p18: CAD file, 2026-06-04]
standard/assembly/standard-boards-x6-tubes/export-step/3D Модель - STEP (Поверхностный монтаж, Вертикальные индикаторы).step
174.9 x 27.9 x 16.2 mm
R0603 - 200 Ohm
R0603 - 680 kOhm
SMA (DO-214AC) x 2
Pin1 x 10
Pin2 x 10
CeramicBody x 10
Resistor 0603 Without Marking x 8
MS-001BB
Pino
Base
Pino001
Base001
Pino002
Base002
Pino003
Base003
GY-BME280
TO-92_New x 2
LED 0603 Base GREEN x 2
LED 0603 Lens GREEN x 2
User Library-SOIC-16-2
RLB0712_vertical_New
Female Header Pitch 2.54mm 1x3_7.50mm x 2
Female Header Pitch 2.54mm 1x10_25.75mm x 2
CR1025
button_case x 4
button_front_pannel x 4
button_push_5.5mm x 4
button_pin x 8
3225 SMD Crystal Oscillator
Buzzer_New
PinsArrayLR x 9
PinsArrayTB
