Dimasssius/DIY_Alliance_NixieClock_Userland/standard/assembly/standard-boards-x4-tubes/export-step/3D Модель - STEP (Поверхностный монтаж, Горизонтальные индикаторы).step

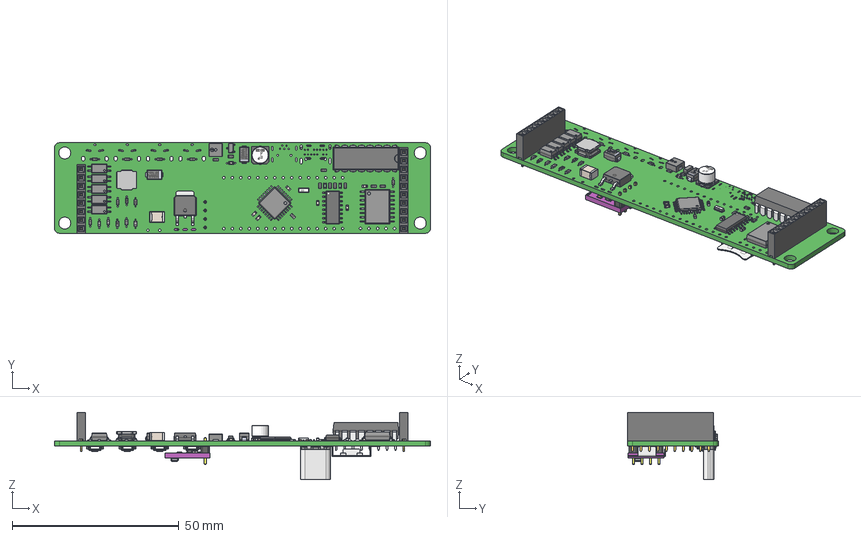
[picture p19: CAD file, 2026-06-04]
standard/assembly/standard-boards-x4-tubes/export-step/3D Модель - STEP (Поверхностный монтаж, Горизонтальные индикаторы).step
112.6 x 27.2 x 20.1 mm
Female Header Pitch 2.54mm 1x8_20.67mm
Female Header Pitch 2.54mm 1x10_25.75mm
Pin1 x 8
Pin2 x 8
CeramicBody x 8
Resistor 0603 Without Marking x 10
TYPE-C-14-vertical_H-10mm
SMA (DO-214AC) x 2
R0603 - 200 Ohm
R0603 - 680 kOhm
IND-SMD_L6.0-W6.0_FNR60XXS~IND-SMD_L6.0-W6.0-H2.8~LYEi
LED 0603 Base GREEN x 2
LED 0603 Lens GREEN x 2
CR1025
TactileButton(5mm)_SMD x 4
GY-BME280
Pino
Base
Pino001
Base001
Pino002
Base002
Pino003
Base003
PinsArrayLR x 7
MS-001BB
PinsArrayTB
User Library-SOIC-16-2
PinsArrayL
FilletPinR
