Dimasssius/DIY_Alliance_NixieClock_Userland/(list of files, cad)

Other CAD files:
standard/assembly/standard-boards-x4-tubes/export-step/3D Модель - PARASOLID (Поверхностный монтаж, Вертикальные индикаторы).x_t
standard/assembly/standard-boards-x4-tubes/export-step/3D Модель - PARASOLID (Поверхностный монтаж, Горизонтальные индикаторы).x_t
standard/assembly/standard-boards-x6-tubes/export-step/3D Модель - PARASOLID (Поверхностный монтаж, Вертикальные индикаторы).x_t
standard/assembly/standard-boards-x6-tubes/export-step/3D Модель - PARASOLID (Поверхностный монтаж, Горизонтальные индикаторы).x_t
