Dimasssius/DIY_Alliance_NixieClock_Userland/common/manuals/README.md

[Главная](../../README.md) / [Общие материалы](../README.md) / Руководства

# 📖 Руководства по сборке и эксплуатации

| Когда читать | Руководство | Что внутри |
| :--- | :--- | :--- |
| Перед сборкой | [Подготовка к сборке](ASSEMBLY_GUIDE.md) | Общие проверки, питание, нюансы индикаторных плат и дополнительные компоненты |
| После сборки | [Управление часами](USER_GUIDE.md) | Кнопки, время, подсветка, будильник, сервисные режимы и коды ошибок |
| Нужна полная инструкция по кнопкам | [Руководство по эксплуатации · PDF](<Руководство по эксплуатации.pdf>) | Исходный документ по управлению часами |

## Документы конкретной платы

[PDF-инструкции Standard](../../standard/manuals/README.md) · [Материалы Hardcore и статус инструкции](../../hardcore/manuals/README.md)

BOM и схемы находятся на страницах плат [Standard](../../standard/assembly/README.md) и [Hardcore](../../hardcore/assembly/README.md). Общие руководства используйте с учётом ревизии, комплектации и настроек прошивки.

## Другие полезные разделы

[Настройка прошивки](../firmware/CONFIGURATION.md) · [Диагностика по симптомам](../troubleshooting/README.md) · [Поддерживаемые индикаторы](../indicators/README.md)
