Dimasssius/DIY_Alliance_NixieClock_Userland/hardcore/manuals/README.md

[Главная](../../README.md) / [Hardcore](../README.md) / Инструкции

# 📖 Инструкции Hardcore

> [!NOTE]
> Отдельная пошаговая инструкция по сборке Hardcore пока не опубликована. Доступны общие рекомендации и материалы каждой комплектации.

## Документы вашей сборки

Выберите количество индикаторов, затем комплектацию **Minimal / Base / Maximal**:

| Плата | Выбор комплектации и документов |
| :--- | :--- |
| Hardcore · 4 индикатора | [Открыть материалы](../assembly/hardcore-boards-x4-tubes/README.md) |
| Hardcore · 6 индикаторов | [Открыть материалы](../assembly/hardcore-boards-x6-tubes/README.md) |

В выбранной комплектации откройте BOM, электрическую схему и сборочный чертёж. Расположение компонентов и подключение периферии проверяйте по документам Hardcore.

## Общие руководства

| Задача | Документ |
| :--- | :--- |
| Подготовка к сборке и общие проверки | [Рекомендации по сборке](../../common/manuals/ASSEMBLY_GUIDE.md) |
| Настройка и загрузка прошивки | [Конфигурация прошивки](../../common/firmware/CONFIGURATION.md) · [Совместимость Hardcore](../firmware/README.md) |
| Кнопки, время, подсветка и будильник | [Руководство пользователя](../../common/manuals/USER_GUIDE.md) |
| Поиск неисправностей | [Диагностика](../../common/troubleshooting/README.md) |

Доступность дополнительных функций зависит от комплектации и прошивки. Отдельное руководство по веб-интерфейсу в этом разделе пока не опубликовано.
