Dimasssius/DIY_Alliance_NixieClock_Userland/standard/manuals/README.md

[Главная](../../README.md) / [Standard](../README.md) / Инструкции

# 📖 Инструкции Standard

Выберите PDF по количеству индикаторов. BOM и схема дополнительно зависят от варианта монтажа и ориентации индикаторов.

| Сборка | Инструкция | BOM, схемы и чертежи |
| :--- | :--- | :--- |
| Standard · 4 индикатора | [Открыть PDF](<1. Часы на газоразрядных индикаторах на 4 индикатора.pdf>) | [Материалы платы](../assembly/standard-boards-x4-tubes/README.md) |
| Standard · 6 индикаторов | [Открыть PDF](<2. Часы на газоразрядных индикаторах на 6 индикаторов.pdf>) | [Материалы платы](../assembly/standard-boards-x6-tubes/README.md) |

## Дополнительные руководства

| Когда читать | Документ |
| :--- | :--- |
| Перед пайкой и первым включением | [Подготовка к сборке](../../common/manuals/ASSEMBLY_GUIDE.md) |
| Перед загрузкой прошивки | [Настройка и прошивка](../../common/firmware/CONFIGURATION.md) |
| После сборки | [Управление часами](../../common/manuals/USER_GUIDE.md) |
| При неисправности | [Диагностика по симптомам](../../common/troubleshooting/README.md) |

Перед монтажом сверяйте инструкцию, BOM, схему и маркировку своей ревизии платы. [Сводные ссылки из прежних заметок](ASSEMBLY_NOTES.md).
