Dimasssius/DIY_Alliance_NixieClock_Userland/hardcore/assembly/hardcore-boards-x4-tubes/README.md

[Главная](../../../README.md) / [Hardcore](../../README.md) / [Материалы сборки](../README.md) / 4 индикатора

# 🧩 Hardcore · 4 индикатора

<p align="center">
  Верхняя сторона платы Hardcore · 4 индикатора, базовая комплектация
</p>

## Выберите свою комплектацию

Комплектации относятся к установленным компонентам. Выбирайте по своему набору и BOM; ревизию платы проверяйте отдельно.

| Комплектация | Назначение | Документы |
| :--- | :--- | :--- |
| **Minimal — минимальная** | Компоненты, необходимые для запуска часов | [BOM, схема и чертёж](minimal-configuration/README.md) |
| **Base — базовая** | Основные функции часов | [BOM, схема и чертёж](base-configuration/README.md) |
| **Maximal — расширенная** | Дополнительные датчики и модули | [BOM, схема и чертёж](maximal-configuration/README.md) |

На изображении выше показана базовая комплектация. Рендеры выбранного варианта находятся на его странице.

## Что делать дальше

1. Откройте страницу своей комплектации и документы сборки.
2. Прочитайте [рекомендации по сборке](../../../common/manuals/ASSEMBLY_GUIDE.md) и [статус инструкции Hardcore](../../manuals/README.md).
3. Сверьте [совместимость прошивки](../../firmware/README.md) и выполните [настройку](../../../common/firmware/CONFIGURATION.md).

После сборки: [управление часами](../../../common/manuals/USER_GUIDE.md). При неисправностях: [диагностика](../../../common/troubleshooting/README.md).
