Dimasssius/DIY_Alliance_NixieClock_Userland/standard/assembly/standard-boards-x4-tubes/README.md

[Главная](../../../README.md) / [Standard](../../README.md) / [Материалы сборки](../README.md) / 4 индикатора

# 🧩 Standard · 4 индикатора

<p align="center">
  Верхняя сторона платы Standard · 4 индикатора
</p>

## 1. Выберите вариант своей сборки

В каждой строке — документы одного варианта. **BOM** означает список компонентов: PDF для просмотра, Excel для работы со списком.

| Монтаж | Индикаторы | BOM | Схема | Сборочный чертёж |
| :--- | :--- | :---: | :---: | :---: |
| Выводной | Вертикальные | [PDF](bom/Перечень%20элементов%20%28BOM%29%20-%20PDF%20%28Выводные%20компоненты%2C%20Вертикальные%20индикаторы%29.PDF) · [Excel](bom/Перечень%20элементов%20%28BOM%29%20-%20Excell%20%28Выводные%20компоненты%2C%20Вертикальные%20индикаторы%29.xlsx) | [PDF](schematic-print/Схема%20электрическая%20принципиальная%20%28Выводные%20компоненты%2C%20Вертикальные%20индикаторы%29.PDF) | [PDF](pcb-print/Сборочный%20чертёж%20%28Выводные%20компоненты%2C%20Вертикальные%20индикаторы%29.PDF) |
| Выводной | Горизонтальные | [PDF](bom/Перечень%20элементов%20%28BOM%29%20-%20PDF%20%28Выводные%20компоненты%2C%20Горизонтальные%20индикаторы%29.PDF) · [Excel](bom/Перечень%20элементов%20%28BOM%29%20-%20Excell%20%28Выводные%20компоненты%2C%20Горизонтальные%20индикаторы%29.xlsx) | [PDF](schematic-print/Схема%20электрическая%20принципиальная%20%28Выводные%20компоненты%2C%20Горизонтальные%20индикаторы%29.PDF) | [PDF](pcb-print/Сборочный%20чертёж%20%28Выводные%20компоненты%2C%20Горизонтальные%20индикаторы%29.PDF) |
| Поверхностный (SMD) | Вертикальные | [PDF](bom/Перечень%20элементов%20%28BOM%29%20-%20PDF%20%28Поверхностный%20монтаж%2C%20Вертикальные%20индикаторы%29.PDF) · [Excel](bom/Перечень%20элементов%20%28BOM%29%20-%20Excell%20%28Поверхностный%20монтаж%2C%20Вертикальные%20индикаторы%29.xlsx) | [PDF](schematic-print/Схема%20электрическая%20принципиальная%20%28Поверхностный%20монтаж%2C%20Вертикальные%20индикаторы%29.PDF) | [PDF](pcb-print/Сборочный%20чертёж%20%28Поверхностный%20монтаж%2C%20Вертикальные%20индикаторы%29.PDF) |
| Поверхностный (SMD) | Горизонтальные | [PDF](bom/Перечень%20элементов%20%28BOM%29%20-%20PDF%20%28Поверхностный%20монтаж%2C%20Горизонтальные%20индикаторы%29.PDF) · [Excel](bom/Перечень%20элементов%20%28BOM%29%20-%20Excell%20%28Поверхностный%20монтаж%2C%20Горизонтальные%20индикаторы%29.xlsx) | [PDF](schematic-print/Схема%20электрическая%20принципиальная%20%28Поверхностный%20монтаж%2C%20Горизонтальные%20индикаторы%29.PDF) | [PDF](pcb-print/Сборочный%20чертёж%20%28Поверхностный%20монтаж%2C%20Горизонтальные%20индикаторы%29.PDF) |

Сверьте ревизию платы с документами к набору. При расхождении номиналов или маркировки уточните данные до пайки.

## 2. Откройте инструкцию

[Инструкция по сборке · PDF](../../manuals/1.%20Часы%20на%20газоразрядных%20индикаторах%20на%204%20индикатора.pdf) · [Общая подготовка](../../../common/manuals/ASSEMBLY_GUIDE.md)

## 3. Настройте прошивку и проверьте часы

[Совместимость Standard](../../firmware/README.md) · [Настройка прошивки](../../../common/firmware/CONFIGURATION.md) · [Диагностика](../../../common/troubleshooting/README.md)

## Визуальные материалы и 3D-модели

| Материал | Куда перейти |
| :--- | :--- |
| Рендеры верхней и нижней стороны | [Изображения платы](pcb-3d-print/README.md) |
| Интерактивная 3D-модель в PDF | [3D PDF](pdf3d/README.md) |
| Модели для CAD | [STEP и PARASOLID](export-step/README.md) |
| Все списки компонентов | [BOM](bom/README.md) |
| Все электрические схемы | [Схемы](schematic-print/README.md) |
| Все сборочные чертежи | [Чертежи](pcb-print/README.md) |

После сборки: [управление часами](../../../common/manuals/USER_GUIDE.md).
