Dimasssius/DIY_Alliance_NixieClock_Userland/hardcore/assembly/hardcore-boards-x4-tubes/base-configuration/README.md

[Главная](../../../../README.md) / [Hardcore](../../../README.md) / [4 индикатора](../README.md) / Базовая комплектация

# 🧩 Hardcore · 4 индикатора · Base

Комплектация с основными функциями часов. Вариант x4 SMD: поверхностный монтаж. Используйте документы этой комплектации и сверяйте ревизию платы.

## Основные документы сборки

| Материал | Открыть | Для чего |
| :--- | :--- | :--- |
| [Список компонентов (BOM)](bom/README.md) | [PDF](bom/Bill%20Of%20Materials%20-%20PDF.PDF) · [Excel](bom/Bill%20Of%20Materials%20-%20Excell.xlsx) | Номиналы, корпуса и количество компонентов |
| [Электрическая схема](schematic-print/README.md) | [PDF](schematic-print/Schematic%20Prints.PDF) | Соединения и обозначения компонентов |
| [Сборочный чертёж](pcb-print/README.md) | [PDF](pcb-print/Assembly%20Drawings.PDF) | Расположение компонентов и проверка монтажа |
| Рендеры платы | [Верхняя и нижняя сторона](pcb-3d-print/README.md) | Визуальная проверка выбранной комплектации |

## Сборка и запуск

[Подготовка к сборке](../../../../common/manuals/ASSEMBLY_GUIDE.md) · [Инструкции Hardcore](../../../manuals/README.md) · [Совместимость прошивки](../../../firmware/README.md) · [Настройка и загрузка](../../../../common/firmware/CONFIGURATION.md)

Наличие дополнительных функций проверяйте по BOM, схеме и настройкам прошивки. Готовых сборок прошивок для скачивания в Wiki пока нет.

<details>
<summary>Дополнительные 3D-материалы и технические отчёты</summary>

| Материал | Открыть |
| :--- | :--- |
| Интерактивная 3D-модель в PDF | [3D PDF](pdf3d/README.md) |
| Отчёт по слоям платы | [Стек платы](report-board-stack/README.md) |
| Координаты размещения компонентов | [Pick and Place · CSV](pick-place/README.md) |

</details>

После сборки: [управление часами](../../../../common/manuals/USER_GUIDE.md) · [диагностика](../../../../common/troubleshooting/README.md).
