Dimasssius/DIY_Alliance_NixieClock_Userland/hardcore/assembly/hardcore-boards-x4-tubes/base-configuration/schematic-print/README.md

[Главная](../../../../../README.md) / [Hardcore](../../../../README.md) / [4 индикатора](../../README.md) / [Base](../README.md) / Электрические схемы

# 📐 Электрические схемы

**Hardcore · 4 индикатора · Base**

Электрические соединения и обозначения компонентов. Используйте вместе с BOM и сборочным чертежом своей сборки.

| Формат | Файл |
| :---: | :--- |
| **PDF** | [Электрические схемы](Schematic%20Prints.PDF) |

Файлы относятся к указанной комплектации Hardcore. Ревизию сверяйте по маркировке платы.

[Вернуться к комплектации](../README.md) · [Начало работы](../../../../../START_HERE.md)
