Dimasssius/DIY_Alliance_NixieClock_Userland/hardcore/assembly/hardcore-boards-x6-tubes/minimal-configuration/pcb-print/README.md

[Главная](../../../../../README.md) / [Hardcore](../../../../README.md) / [6 индикаторов](../../README.md) / [Minimal](../README.md) / Сборочные чертежи

# 🧩 Сборочные чертежи

**Hardcore · 6 индикаторов · Minimal**

Расположение компонентов на плате для проверки монтажа. Номиналы сверяйте с BOM, соединения — с электрической схемой.

| Формат | Файл |
| :---: | :--- |
| **PDF** | [Сборочные чертежи](Assembly%20Drawings.PDF) |

Файлы относятся к указанной комплектации Hardcore. Ревизию сверяйте по маркировке платы.

[Вернуться к комплектации](../README.md) · [Начало работы](../../../../../START_HERE.md)
