Dimasssius/DIY_Alliance_NixieClock_Userland/standard/assembly/standard-boards-x4-tubes/export-step/README.md

[Главная](../../../../README.md) / [Standard](../../../README.md) / [4 индикатора](../README.md) / 3D-модели STEP и PARASOLID

# 📦 3D-модели STEP и PARASOLID

**Standard · 4 индикатора**

Модели платы для работы в CAD. STEP и PARASOLID — два формата модели; выберите поддерживаемый вашим ПО.

| Вариант сборки | STEP | PARASOLID |
| :--- | :---: | :---: |
| Выводной · вертикальные индикаторы | [STEP](3D%20Модель%20-%20STEP%20%28Выводные%20компоненты%2C%20Вертикальные%20индикаторы%29.step) | [PARASOLID](3D%20Модель%20-%20PARASOLID%20%28Выводные%20компоненты%2C%20Вертикальные%20индикаторы%29.x_t) |
| Выводной · горизонтальные индикаторы | [STEP](3D%20Модель%20-%20STEP%20%28Выводные%20компоненты%2C%20Горизонтальные%20индикаторы%29.step) | [PARASOLID](3D%20Модель%20-%20PARASOLID%20%28Выводные%20компоненты%2C%20Горизонтальные%20индикаторы%29.x_t) |
| SMD · вертикальные индикаторы | [STEP](3D%20Модель%20-%20STEP%20%28Поверхностный%20монтаж%2C%20Вертикальные%20индикаторы%29.step) | [PARASOLID](3D%20Модель%20-%20PARASOLID%20%28Поверхностный%20монтаж%2C%20Вертикальные%20индикаторы%29.x_t) |
| SMD · горизонтальные индикаторы | [STEP](3D%20Модель%20-%20STEP%20%28Поверхностный%20монтаж%2C%20Горизонтальные%20индикаторы%29.step) | [PARASOLID](3D%20Модель%20-%20PARASOLID%20%28Поверхностный%20монтаж%2C%20Горизонтальные%20индикаторы%29.x_t) |

Выбирайте один вариант монтажа и ориентации индикаторов во всех документах. Ревизию сверяйте по маркировке платы.

[Вернуться к материалам платы](../README.md) · [Начало работы](../../../../START_HERE.md)
