Dimasssius/DIY_Alliance_NixieClock_Userland/standard/assembly/standard-boards-x4-tubes/pcb-3d-print/README.md

[Главная](../../../../README.md) / [Standard](../../../README.md) / [4 индикатора](../README.md) / Рендеры платы

# 🖼️ Рендеры платы

**Standard · 4 индикатора**

Верхняя и нижняя сторона платы. Рендер помогает сверить внешний вид и расположение компонентов; номиналы проверяйте по BOM.

| Вариант | Верхняя сторона | Нижняя сторона |
| :--- | :---: | :---: |
| Плата без компонентов | [PNG](Верхний%20слой%20%28Печатная%20плата%29.png) | [PNG](Нижний%20слой%20%28Печатная%20плата%29.png) |
| Выводной · вертикальные индикаторы | [PNG](Верхний%20слой%20%28Собранная%20печатная%20плата%2C%20Выводные%20компоненты%2C%20Вертикальные%20индикаторы%29.png) | [PNG](Нижний%20слой%20%28Собранная%20печатная%20плата%2C%20Выводные%20компоненты%2C%20Вертикальные%20индикаторы%29.png) |
| Выводной · горизонтальные индикаторы | [PNG](Верхний%20слой%20%28Собранная%20печатная%20плата%2C%20Выводные%20компоненты%2C%20Горизонтальные%20индикаторы%29.png) | [PNG](Нижний%20слой%20%28Собранная%20печатная%20плата%2C%20Выводные%20компоненты%2C%20Горизонтальные%20индикаторы%29.png) |
| SMD · вертикальные индикаторы | [PNG](Верхний%20слой%20%28Собранная%20печатная%20плата%2C%20Поверхностный%20монтаж%2C%20Вертикальные%20индикаторы%29.png) | [PNG](Нижний%20слой%20%28Собранная%20печатная%20плата%2C%20Поверхностный%20монтаж%2C%20Вертикальные%20индикаторы%29.png) |
| SMD · горизонтальные индикаторы | [PNG](Верхний%20слой%20%28Собранная%20печатная%20плата%2C%20Поверхностный%20монтаж%2C%20Горизонтальные%20индикаторы%29.png) | [PNG](Нижний%20слой%20%28Собранная%20печатная%20плата%2C%20Поверхностный%20монтаж%2C%20Горизонтальные%20индикаторы%29.png) |

Выбирайте один вариант монтажа и ориентации индикаторов во всех документах. Ревизию сверяйте по маркировке платы.

## Превью платы

Верхняя сторона платы Standard на 4 индикатора

[Вернуться к материалам платы](../README.md) · [Начало работы](../../../../START_HERE.md)
