Dimasssius/DIY_Alliance_NixieClock_Userland/standard/assembly/standard-boards-x4-tubes/pcb-print/README.md

[Главная](../../../../README.md) / [Standard](../../../README.md) / [4 индикатора](../README.md) / Сборочные чертежи

# 🧩 Сборочные чертежи

**Standard · 4 индикатора**

Расположение компонентов на плате для проверки монтажа. Номиналы сверяйте с BOM, соединения — с электрической схемой.

| Вариант сборки | Файл |
| :--- | :--- |
| Выводной · вертикальные индикаторы | [PDF](Сборочный%20чертёж%20%28Выводные%20компоненты%2C%20Вертикальные%20индикаторы%29.PDF) |
| Выводной · горизонтальные индикаторы | [PDF](Сборочный%20чертёж%20%28Выводные%20компоненты%2C%20Горизонтальные%20индикаторы%29.PDF) |
| SMD · вертикальные индикаторы | [PDF](Сборочный%20чертёж%20%28Поверхностный%20монтаж%2C%20Вертикальные%20индикаторы%29.PDF) |
| SMD · горизонтальные индикаторы | [PDF](Сборочный%20чертёж%20%28Поверхностный%20монтаж%2C%20Горизонтальные%20индикаторы%29.PDF) |

Выбирайте один вариант монтажа и ориентации индикаторов во всех документах. Ревизию сверяйте по маркировке платы.

[Вернуться к материалам платы](../README.md) · [Начало работы](../../../../START_HERE.md)
