Dimasssius/DIY_Alliance_NixieClock_Userland/standard/assembly/standard-boards-x4-tubes/pdf3d/README.md

[Главная](../../../../README.md) / [Standard](../../../README.md) / [4 индикатора](../README.md) / Интерактивные 3D PDF

# 📦 Интерактивные 3D PDF

**Standard · 4 индикатора**

PDF-файлы с интерактивной 3D-моделью для визуальной проверки платы. Если просмотр на GitHub не показывает 3D-содержимое, скачайте файл для просмотра.

| Вариант сборки | Файл |
| :--- | :--- |
| Плата без компонентов | [PDF](Acrobat%20Reader%20PDF3D%20-%203D%20Модель%20%28Печатная%20плата%29.PDF) |
| Выводной · вертикальные индикаторы | [PDF](Acrobat%20Reader%20PDF3D%20-%203D%20Модель%20%28Собранная%20печатная%20плата%2C%20Выводные%20компоненты%2C%20Вертикальные%20индикаторы%29.PDF) |
| Выводной · горизонтальные индикаторы | [PDF](Acrobat%20Reader%20PDF3D%20-%203D%20Модель%20%28Собранная%20печатная%20плата%2C%20Выводные%20компоненты%2C%20Горизонтальные%20индикаторы%29.PDF) |
| SMD · вертикальные индикаторы | [PDF](Acrobat%20Reader%20PDF3D%20-%203D%20Модель%20%28Собранная%20печатная%20плата%2C%20Поверхностный%20монтаж%2C%20Вертикальные%20индикаторы%29.PDF) |
| SMD · горизонтальные индикаторы | [PDF](Acrobat%20Reader%20PDF3D%20-%203D%20Модель%20%28Собранная%20печатная%20плата%2C%20Поверхностный%20монтаж%2C%20Горизонтальные%20индикаторы%29.PDF) |

Выбирайте один вариант монтажа и ориентации индикаторов во всех документах. Ревизию сверяйте по маркировке платы.

[Вернуться к материалам платы](../README.md) · [Начало работы](../../../../START_HERE.md)
