Dimasssius/DIY_Alliance_NixieClock_Userland/standard/assembly/standard-boards-x4-tubes/schematic-print/README.md

[Главная](../../../../README.md) / [Standard](../../../README.md) / [4 индикатора](../README.md) / Электрические схемы

# 📐 Электрические схемы

**Standard · 4 индикатора**

Электрические соединения и обозначения компонентов. Используйте вместе с BOM и сборочным чертежом своей сборки.

| Вариант сборки | Файл |
| :--- | :--- |
| Выводной · вертикальные индикаторы | [PDF](Схема%20электрическая%20принципиальная%20%28Выводные%20компоненты%2C%20Вертикальные%20индикаторы%29.PDF) |
| Выводной · горизонтальные индикаторы | [PDF](Схема%20электрическая%20принципиальная%20%28Выводные%20компоненты%2C%20Горизонтальные%20индикаторы%29.PDF) |
| SMD · вертикальные индикаторы | [PDF](Схема%20электрическая%20принципиальная%20%28Поверхностный%20монтаж%2C%20Вертикальные%20индикаторы%29.PDF) |
| SMD · горизонтальные индикаторы | [PDF](Схема%20электрическая%20принципиальная%20%28Поверхностный%20монтаж%2C%20Горизонтальные%20индикаторы%29.PDF) |

Выбирайте один вариант монтажа и ориентации индикаторов во всех документах. Ревизию сверяйте по маркировке платы.

[Вернуться к материалам платы](../README.md) · [Начало работы](../../../../START_HERE.md)
