Dimasssius/DIY_Alliance_NixieClock_Userland/hardcore/assembly/hardcore-boards-x4-tubes/base-configuration/pdf3d/README.md

[Главная](../../../../../README.md) / [Hardcore](../../../../README.md) / [4 индикатора](../../README.md) / [Base](../README.md) / Интерактивные 3D PDF

# 📦 Интерактивные 3D PDF

**Hardcore · 4 индикатора · Base**

PDF-файлы с интерактивной 3D-моделью для визуальной проверки платы. Если просмотр на GitHub не показывает 3D-содержимое, скачайте файл для просмотра.

| Формат | Файл |
| :---: | :--- |
| **PDF** | [Интерактивные 3D PDF](Acrobat%20Reader%20PDF3D%20-%20Black%20PCB.PDF) |

Файлы относятся к указанной комплектации Hardcore. Ревизию сверяйте по маркировке платы.

[Вернуться к комплектации](../README.md) · [Начало работы](../../../../../START_HERE.md)
