Dimasssius/DIY_Alliance_NixieClock_Userland/hardcore/assembly/hardcore-boards-x4-tubes/base-configuration/pick-place/README.md

[Главная](../../../../../README.md) / [Hardcore](../../../../README.md) / [4 индикатора](../../README.md) / [Base](../README.md) / Координаты компонентов (Pick and Place)

# 📍 Координаты компонентов (Pick and Place)

**Hardcore · 4 индикатора · Base**

CSV-файл с координатами размещения компонентов. Для ручной сборки расположение деталей удобнее смотреть в сборочном чертеже.

| Формат | Файл |
| :---: | :--- |
| **CSV** | [Координаты компонентов (Pick and Place)](Pick%20And%20Place%20%28PnP%29%20Files.csv) |

Файлы относятся к указанной комплектации Hardcore. Ревизию сверяйте по маркировке платы.

<details>
<summary>Примечание для сопровождающих</summary>

Перед публикацией проверьте, что файл можно открыто распространять.

</details>

[Вернуться к комплектации](../README.md) · [Начало работы](../../../../../START_HERE.md)
