Dimasssius/DIY_Alliance_NixieClock_Userland/hardcore/assembly/hardcore-boards-x4-tubes/maximal-configuration/pcb-3d-print/README.md

[Главная](../../../../../README.md) / [Hardcore](../../../../README.md) / [4 индикатора](../../README.md) / [Maximal](../README.md) / Рендеры платы

# 🖼️ Рендеры платы

**Hardcore · 4 индикатора · Maximal**

Верхняя и нижняя сторона платы. Рендер помогает сверить внешний вид и расположение компонентов; номиналы проверяйте по BOM.

| Вариант | Верхняя сторона | Нижняя сторона |
| :--- | :---: | :---: |
| Плата без компонентов | [PNG](Top%20Layer%20%28Black%2C%20PCB%29.png) | [PNG](Bottom%20Layer%20%28Black%2C%20PCB%29.png) |
| Собранная плата | [PNG](Top%20Layer%20%28Black%2C%20Assembled%29.png) | [PNG](Bottom%20Layer%20%28Black%2C%20Assembled%29.png) |

Файлы относятся к указанной комплектации Hardcore. Ревизию сверяйте по маркировке платы.

## Превью платы

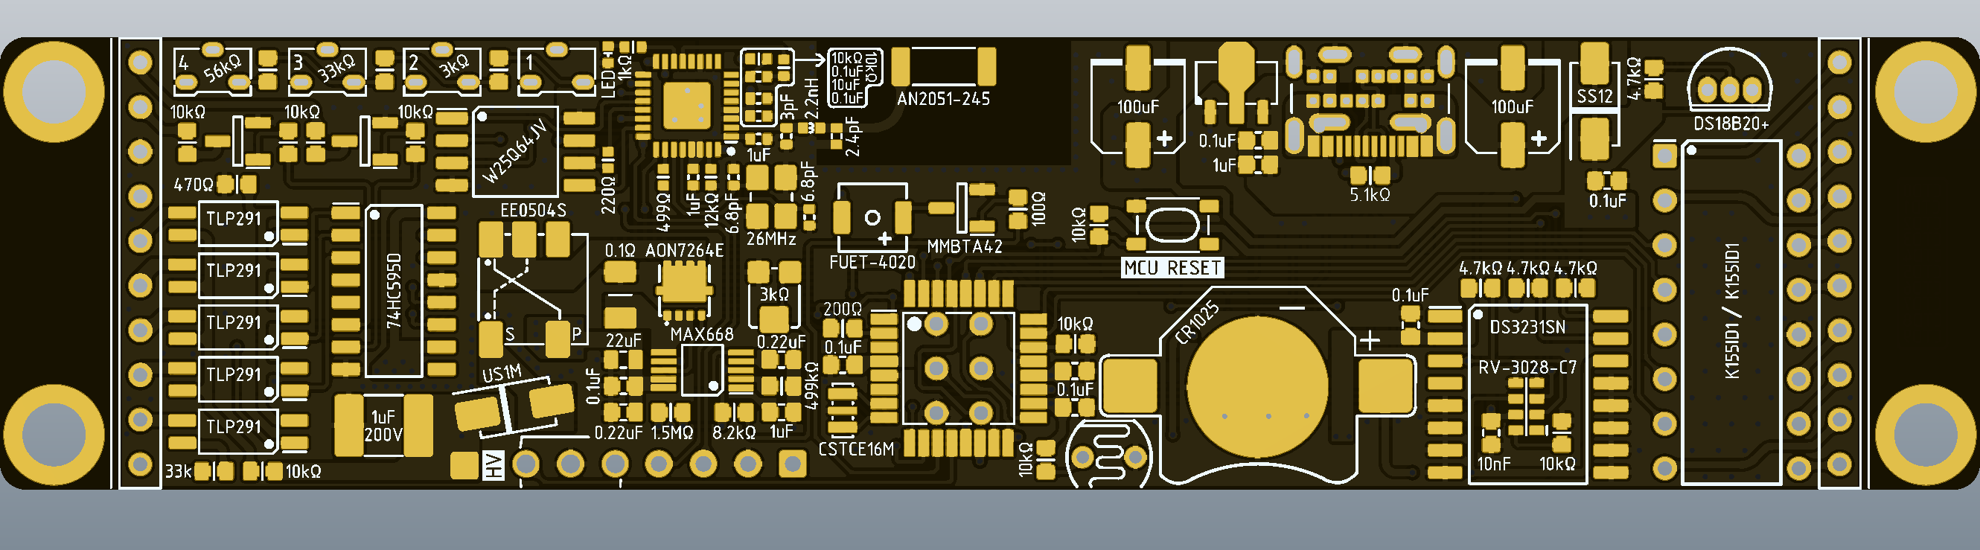
[picture p21: hardcore/assembly/hardcore-boards-x4-tubes/maximal-configuration/pcb-3d-print/Top Layer (Black, PCB).png]
Верхняя сторона платы Hardcore на 4 индикатора, комплектация Maximal


[Вернуться к комплектации](../README.md) · [Начало работы](../../../../../START_HERE.md)
