Dimasssius/DIY_Alliance_NixieClock_Userland/common/manuals/ASSEMBLY_GUIDE.md

[Главная](../../README.md) / [Общие материалы](../README.md) / [Руководства](README.md) / Подготовка к сборке

# 🛠️ Подготовка к сборке

Общие заметки из PDF-инструкций DIY_Alliance. Используйте их вместе с BOM, схемой и инструкцией своей платы. Конкретные номиналы и рекомендации по модулям сверяйте с ревизией и комплектацией.

Пошаговые документы: [Standard](../../standard/manuals/README.md) · [Hardcore и статус инструкции](../../hardcore/manuals/README.md).

## Быстрые переходы

- [Что проверить до пайки](#что-важно-знать-перед-началом-сборки)
- [Известные нюансы индикаторных плат](#известные-нюансы-индикаторных-плат)
- [Конструкция часов](#конструкция-часов)
- [Питание](#питание)
- [Дополнительные компоненты](#дополнительные-компоненты)
- [Установка DS3231 mini](#ds3231-mini)
- [Если документы расходятся](#дисклеймер)

## Дисклеймер

Проектная документация, инструкции и сопроводительные материалы могут содержать ошибки, неточности или устаревшие фрагменты. Часть информации на печатных платах и в инструкции может отличаться: номиналы компонентов, расположение элементов, маркировка или примечания к ревизии платы.

При обнаружении несоответствий проверяйте несколько источников:

- актуальную инструкцию;
- BOM конкретной версии платы;
- электрическую схему;
- маркировку на самой печатной плате;
- объявления и примечания к ревизии платы.

Если найдено несоответствие или ошибка, лучше сообщить автору проекта, чтобы документацию можно было исправить.

## Что важно знать перед началом сборки

Если это первый опыт пайки, сначала стоит потренироваться отдельно. Для сборки часов желательно подготовить нормальный паяльник с тонким жалом, качественный припой и флюс.

Перед пайкой обязательно проверяйте:

- полярность электролитических конденсаторов, диодов и других полярных компонентов;
- ключ первого вывода у микросхем и сложных компонентов;
- совпадение ключа на корпусе компонента с ключом на footprint печатной платы;
- номиналы и корпуса компонентов по BOM;
- отсутствие коротких замыканий;
- качество пайки после каждого этапа.

При аккуратной сборке по инструкции и корректной прошивке часы должны запускаться с первого включения. Большая часть проблем обычно связана с качеством пайки, неправильной ориентацией компонентов или невнимательностью при сборке.

## Известные нюансы индикаторных плат

- Номинал резисторов для разделительных неоновых точек на индикаторной плате должен быть `10 кОм`. На некоторых платах может быть указано `3 МОм`.
- Типоразмер резисторов и конденсаторов на индикаторной плате может отличаться от `0603`.
- На индикаторных платах новых ревизий может быть дополнительная текстовая информация на нижнем слое платы. Ее нужно учитывать при сборке.

## Конструкция часов

Часы состоят из двух печатных плат:

| Плата | Назначение |
| :--- | :--- |
| Нижняя плата | Основная универсальная плата |
| Верхняя плата | Индикаторная плата |

В зависимости от версии и навыков пайки возможны разные варианты сборки:

- DIP / выводные компоненты;
- SMD-компоненты;
- комбинированная сборка DIP и SMD.

У некоторых плат по бокам могут быть монтажные зоны с отверстиями. При необходимости их можно отделить по линии `V-Cut` без дополнительного инструмента.

## Питание

| Параметр | Значение |
| :--- | :--- |
| **Напряжение питания** | 5 В |
| **Потребление** | около 500 мА |
| **Рекомендуемый блок питания** | 5 В, 1 А |

Перед первым запуском проверьте полярность питания и отсутствие коротких замыканий.

## Дополнительные компоненты

На платах предусмотрена установка дополнительных компонентов, которые расширяют функциональность часов. Их наличие зависит от версии платы, комплектации и настроек прошивки.

| Компонент | Назначение | Примечание |
| :--- | :--- | :--- |
| **Датчик температуры, влажности и давления** | Отображение температуры, влажности и давления | В инструкциях упоминаются BME280/BMP280 и похожие датчики |
| **Buzzer / пьезодинамик** | Будильник, звуковые уведомления и озвучка нажатий | В новых версиях может использоваться FUET-4020 |
| **UART-преобразователь CH340C** | Прошивка микроконтроллера через USB | Не требует отдельной настройки в прошивке |
| **Дополнительная тактовая кнопка** | Таймер, секундомер, будильник и отдельные функции управления | Функциональность должна быть включена в прошивке |
| **Адресные светодиоды WS2812B** | Светодиодная подсветка | Режимы подсветки настраиваются в прошивке и меню часов |
| **Неоновые секундные точки** | Разделительные точки и индикация секунд | Режим работы выбирается в настройках часов |
| **Датчик движения** | Дополнительные сценарии управления или включения | Поддержка зависит от платы и прошивки |
| **IR-приемник** | Управление с ИК-пульта | В прошивке поддерживаются пульты NEC |
| **Wi-Fi модуль** | Веб-интерфейс, мониторинг и обновление прошивки | Только при наличии соответствующей аппаратной поддержки |
| **MP3-плеер / FM-тюнер** | Дополнительное звуковое расширение | Для некоторых плат могут быть выведены Test Point под пайку |

Функциональность дополнительных компонентов должна быть включена и настроена в прошивке часов. Исключение: UART-преобразователь, который нужен для прошивки микроконтроллера и не требует настройки в самой прошивке.

## DS3231 mini

При установке модуля DS3231 mini в инструкциях отмечен важный момент: штатный `female header`, который часто запаян на модуле с завода, нужно заменить на `male header`, а сам модуль установить батарейкой вверх.

Если используется синхронизация времени по SQW, на модуле DS3231 mini может потребоваться припаять дополнительный провод.
