Dimasssius/DIY_Alliance_NixieClock_Userland/standard/manuals/ASSEMBLY_NOTES.md

[Главная](../../README.md) / [Standard](../README.md) / [Инструкции](README.md) / Общие заметки

# 🛠️ Общие заметки по сборке

Заметки перенесены в общий раздел, поскольку относятся к нескольким линейкам плат. Используйте следующие документы:

| Задача | Документ |
| :--- | :--- |
| Подготовка к пайке, питание и дополнительные компоненты | [Подготовка к сборке](../../common/manuals/ASSEMBLY_GUIDE.md) |
| Настройка пинов, катодной маски и порядка анодов | [Настройка прошивки](../../common/firmware/CONFIGURATION.md) |
| Проверки при неисправностях | [Диагностика](../../common/troubleshooting/README.md) |

Пошаговые PDF для Standard: [инструкции на 4 и 6 индикаторов](README.md).
