Dimasssius/DIY_Alliance_NixieClock_Userland/common/manuals/Руководство по эксплуатации.pdf

# Часы на газоразрядных индикаторах

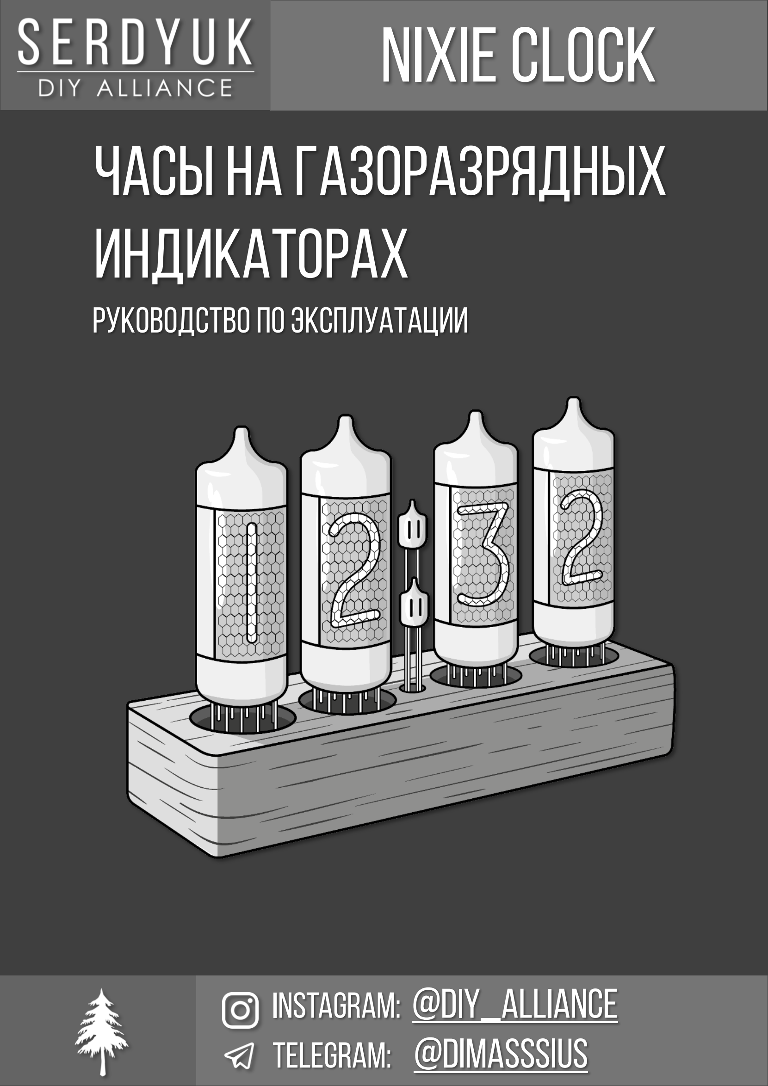
[picture p22: page 1]

# Instagram: @DIY_ALLIANCE (https://www.instagram.com/diy_alliance/) Telegram: @DIMASSSIUS (https://t.me/Dimasssius)

# Руководство по эксплуатации

# NIXIE clock

# Оглавление

# Дисклеймер

## Прежде всего хочу сказать, что я просто человек и абсолютно все инструкции и сопроводительные документы делаю самостоятельно и в

свободное время, поэтому документация может, а скорее всего и содержит,

## ряд ошибок и неточностей

## При обнаружении ошибок, неточностей и прочего просьба связаться с автором по гиперссылкам на первой странице для внесения исправлений в настоящее руководство

# Аппаратная поддержка

1. Датчики температуры:
– DHT11
– DHT12
– MW33
– DHT21
– DHT22 (AM2301/AM2302)
– DS18B20

– DS18S20
– DS1820
– BME280 (BMP085/180/280)
– SHT20 (SHT21/SHT25)
– SHT30 (SHT31/SHT35)
– AHT10 (AHT15); AHT20
2. Неоновая секундная точка (одна или две пары, либо одиночные)
3. Buzzer (для будильника и оповещений)
4. Подсветка на адресных светодиодах WS2812B
5. Дополнительная кнопка для управления таймером, секундомером и будильником
6. Приемник ИК пульта (можно подключить на свободные цифровые пины D0 или D3)
7. Датчик движения (можно подключить на свободные цифровые пины D0 или D3)
8. Синхронизация времени по SQW (на модуле DS3231 mini необходимо припаять провод)

# Программная поддержка

1. часовой формат времени 24 или 12 часов
2. Переход на летнее и зимнее время
3. Будильник (один или несколько)
4. Автоматическое определение подключенного датчика температуры (если выбрано несколько датчиков)
5. Авто-показтемпературы (влажности и давления)
6. Авто-показ даты
7. Отображениетекущей температуры, давления, влажности
8. Отображениетекущей даты
9. Меню настройки яркости и других функций
10. Быстрое меню для выбора анимации смены минут(секунд), точек, подсветки
11. Таймер-секундомер (только при наличии дополнительной кнопки)
12. Антиотравление ламп (3 варианта анимации, выбор из меню)
13. Мелодия смены часа (или озвучка при использовании плеера)
14. Смена яркости по времени и по датчику освещённости
15. Анимация глюков
16. 10 режимов анимации авто-показа (естьслучайный режим)
17. 10 режимов анимации минут(естьслучайный режим)
18. 3 режима анимации секунд для шести ламп
19. 15 режимов подсветки
20. 3 режима работы секундных точек (1 режим для двух неоновых ламп / 6 режимов разделительных точек и дополнительныережимы для отображения состояния будильника)
21. Возможностьсоздания собственных мелодий будильника
22. Система контроля основных параметров часов (ошибки)
23. Меню отладки (для опытных пользователей)
24. Озвучка пунктов меню, времени и температуры
25. Программирование кнопок ИК пульта из меню отладки
26. Режим сна (отключение ламп череззаданное время)
27. Веб-интерфейс для настройки и мониторинга (при наличии модуля wi-fi)
28. Обновление прошивки часов через веб интерфейс(при наличии модуля wi-fi)

# Описание кнопок

На часах имеется четыре тактовые кнопки – три основных и одна дополнительная:
Для управления и настройки часов обязательно должно присутствовать три основныетактовые кнопки, четвертая кнопка - функциональна
Основные кнопки:
1. "правая" кнопка
2. "средняя" кнопка
3. "левая" кнопка
функциональная кнопка:
4. "дополнительная" кнопка

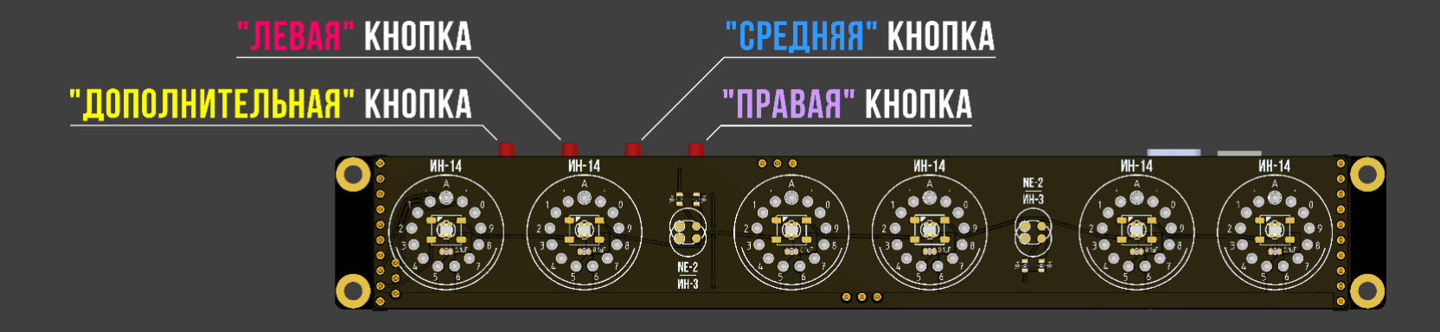
[picture p23: figure]

# Управление кнопками В РЕЖИМЕ ЧАСОВ

# (стандартный режим управления)

– | Клик по "правой" кнопке отображает текущую дату, при повторном нажатии переключает дату/год
– | Клик по "левой" кнопке отображает температуру, при повторном нажатии переключает температуру,
| давление и влажность
– Клик по "средней" кнопке переводит в режим настройки подсветки, режима работы секундных
| точек и анимации смены минут, где:
I. Клик по "левой" кнопке переключает режим светодиодной подсветки:
0. Подсветка выключена
1. статичная
2. дыхание
3. дыхание со сменой цвета
4. бегущий огонь
5. бегущий огонь со сменой цвета
6. бегущий огонь с радугой
7. бегущий огонь с конфетти
8. волна
9. волна со сменой цвета
10. волна с радугой
11. волна с конфетти
12. плавная смена цвета
13. радуга
14. конфетти

Удержание "левой" кнопки во время отображения режима подсветки переводит в режим установки цвета, выбор цвета осуществляется "левой" кнопкой
(войти можно только в режимах, поддерживающих смену цвета -статичная, дыхание, бегущий огонь, волна) II. Клик по "средней" кнопке переключает режим анимации разделительных точек:
0. Точки отключены
1. Статичная
2. мигает один раз в секунду
3. мигает два раза в секунду
4. динамичная (плавно мигает)

III. Клик по "правой" кнопке переключает режим анимации минут:
0. Без анимации
1. случайная анимация
2. плавное угасание и появление
3. перемотка по порядку числа
4. перемотка по порядку катодов
5. поезд
6. резинка
7. ворота
8. волна
9. блики
10. испарение
11. игровой автомат
если нет дополнительной кнопки - Удержание"правой" кнопки во время отображения режима анимации смены минут переводит в режим установки анимации смены секунд,
выбор анимации осуществляется "правой" кнопкой:
0. Без анимации
1. плавное угасание и появление
2. перемотка по порядку числа
3. перемотка по порядку катодов в лампе
IV. Клик по "дополнительной" кнопке - переключает режим анимации смены секунд:
0. Без анимации
1. плавное угасание и появление
2. перемотка по порядку числа
3. перемотка по порядку катодов в лампе

# Управление кнопками В РЕЖИМЕ ЧАСОВ

# (упрощенный режим управления)

– Клик по "правой" кнопке переключает режим анимации разделительных точек:
0. Точки отключены
1. Статичная
2. мигает один раз в секунду
3. мигает два раза в секунду
4. динамичная (плавно мигает)

– Клик по "средней" кнопке переключает режим анимации смены минут:
0. Без анимации
1. случайная анимация
2. плавное угасание и появление
3. перемотка по порядку числа
4. перемотка по порядку катодов
5. поезд
6. резинка
7. ворота
8. волна
9. блики
10. испарение
11. игровой автомат
– Удержание"средней" кнопки переключает режим анимации смены секунд:
0. Без анимации
1. плавное угасание и появление
2. перемотка по порядку числа
3. перемотка по порядку катодов в лампе) – Клик по "левой" кнопке переключает режим подсветки:
0. Подсветка выключена
1. статичная
2. дыхание
3. дыхание со сменой цвета
4. бегущий огонь
5. бегущий огонь со сменой цвета
6. бегущий огонь с радугой
7. бегущий огонь с конфетти
8. волна
9. волна со сменой цвета
10. волна с радугой
11. волна с конфетти
12. плавная смена цвета
13. радуга
14. конфетти

# Настройка времени и Основные настройки

стандартный и упрощенный режим управления:
Для входа в меню настройки времени необходимо Удерживать "правую" кнопку Управление в меню:
– "Средняя" кнопка - выбор, остальные "меньше" и "больше"
– Клик по "Средней" кнопке -смена настройки часы/минуты | месяц/дата | год
– Клик "меньше" или "больше" - изменение времени/даты
– Удержать "Среднюю" кнопку - возврат к режиму часов

Только стандартный режим управления:
Для входа в меню Основных настроек необходимо Удерживать "среднюю" кнопку Управление в меню:
– "Средняя" кнопка - выбор, остальные "меньше" и "больше"
– Клик по "Средней" кнопке - переход в подпункт пункт меню для настройки или возврат к выбору пункта меню
– Клик "меньше" или "больше" - выбор пункта меню
– Удержать "Среднюю" - возврат к режиму часов
– Удержать "меньше" или "больше" - выбор подпункта меню

Пункты меню:
– 01 - Формат времени (12ч | 24ч)
– 02 -Глюки (0 - выключены | 1 - включены)
– 03 -Звук кнопок (0 - выключен | 1 - включен)
– 04 - Время звука смены часа (Начало: Конец)
(Выключить звук смены часа - начало = конец)
– 05 - Время смены подсветки (Ночь : День)
(Выключить смену яркости (включить датчик освещения): ночь = день) – 06 - Яркость индикаторов (Ночь : День)
– 07 - Яркость подсветки (Ночь : День)
– 08 - Яркость секундных точек (Ночь : День)
– 09 - Коррекция датчика температуры (Коррекция : Сенсор(только отображение))
– 10 - Настройка интервала и анимации автоматического отображения
(в минутах (0 - выключить) : Анимация)
– 11 - Настройка интервала и анимации антиотравления индикаторов (Время в минутах : Анимация) – 12 - Установка времени ожидания после выхода из сна (Ночь (сек) : День (мин)) (0 - выключить)

# Настройка секундомера и таймера

Для включения таймера или секундомера необходимо нажать "дополнительную" кнопку Управление в меню:
– Клик по "дополнительной" кнопке- пуск/пауза
– Клик по "средней" кнопке- вход в настройку таймера (только в режиме таймера)
– Клик или удержание "левой" кнопки -режим секундомера
– Клик или удержание "правой" кнопки -режим таймера
– Удержать "дополнительную" кнопку -сброс таймера/секундомера
– Удержать "среднюю" кнопку - возврат к режиму часов
(таймер продолжает работать в фоне, секундомер ставится на паузу)

Для Настройки таймера В режиме таймера необходимо нажать на "среднюю" кнопку Управление в меню:
– Клик по "средней" кнопке- переключение разрядов ММ:СС (максимум 99:59) – Клик по "левой" кнопке- уменьшить значение
– Клик по "правой" кнопке- увеличить значение
– Удержать "среднюю" или "дополнительную" кнопку - выход к таймеру

# Настройка будильника

Для входа в меню настройки времени необходимо Удерживать "левую" кнопку Управление в меню:
– "Средняя" кнопка - выбор, остальные "меньше" и "больше"
– Клик по "средней" кнопке- перемещение по индикаторам
– Клик "меньше" или "больше" - изменение значений
– Удержать"меньше" или "больше":
1. смена настройки часы/минуты
2. режим
3. день недели/активация
4. мелодия
– Удержать"Среднюю" кнопку- возврат к режиму часов

Режимы будильника:
– 00 - выключен
– 01 -однократный
– 02 - каждый день
– 03 - по будням
– 04 - выбор по дням недели

Во время тревоги будильника:
– Клик по любой кнопке -Отложить будильник на установленный тайм-аут
– Удержание любой кнопки -Отключить будильник (если режим "однократный",то насовсем)

Если будильник был отложен:
– Удержание"Средней" или "дополнительной" кнопки в режиме часов -Отключить будильник
(если режим "однократный",то насовсем)

# Коды ошибок

Если возникла какая-то ошибка, то при старте часов будет длинный писк и отобразится код ошибки:
– 0001 - Нет связи с модулем DS3231 (модуль часов неисправен или проблемы с шиной i2c)
– 0002 -Сбой осциллятора DS3231
(батарейка модуля часов разряжена или проблемы с тактированием модуля часов) – 0003 -Слишком короткий сигнал SQW (во время работы часов обнаружены помехи или неверный сигнал на SQW) – 0004 -Слишком длинный сигнала SQW (пропал сигнал SQW во время работы часов или отсутствовал при запуске) – 0005 - Выбранный датчик температуры не обнаружен (проверить подключение датчика температуры)
– 0006 -Слишком низкое или слишком высокое напряжение питания (проверить источник питания)
– 0007 -Сбой памяти EEPROM (повреждение данных, если ошибка будет повторятся слишком часто - износ EEPROM) – 0008 - программная перезагрузка (говорит о нестабильности программы или о проблемах с микроконтроллером) – 0009 -Сбой работы преобразователя (регистры таймера были неожиданно изменены)
– 0010 - Переполнение заполнения шим преобразователя (превышен верхний предел заполнения шим)
– 0011 - Переполнение стека (утечка памяти)
– 0012 - Переполнение тиков времени (основная программа не отвечает)
– 0013 -Сбой работы динамической индикации
(регистры таймера были неожиданно изменены или превышен предел регистра сравнения)

# Дополнительные функции и меню для отладки

Для сброса настроек - необходимо зажать "среднюю" кнопку и подать питание на часы
Для запуска меню отладки - необходимо зажать"левую" кнопку и подать питание на часы
Для запуска теста системы (ламп тест) - необходимо зажать "правую" кнопку и подать питание на часы

Управление в меню отладки:
– Клик по "средней" кнопке- выбор пункта отладки
– Клик по"левой" кнопке- уменьшить значение
– Клик по"правой" кнопке- увеличить значение
– Удержать "среднюю" кнопку - выход к часам

Пункты отладки:
– 01 - Коррекция хода часов DS3231 (Коррекция (0..255) (128 = 0))
– 02 - Коррекция хода внутреннего осциллятора (Коррекция (+-400)(мкс))
– 03 - Минимальное значение шим (Для линейной регулировки)(100..190)
– 04 - Максимальное значение шим (Для линейной регулировки)(150..200)
– 05 - Коррекция напряжения преобразователя (Для регулировки по обратной связи)
(Внимание! Значение может меняться в зависимости от напряжения питания) (+-30)
– 06 - Программирование кнопок ИК пульта (Поддерживаются пульты только с протоколом NEC)(1..13) – 07 - Калибровка датчика освещенности (Автоматическое определение диапазона)
– 08 -Сброс настроек отладки (0..1)(0 -отмена | 1 - подтверждение)

Настройка кнопок пульта:
Управление:
– Клик по "средней" кнопке- выйти из режима программирования кнопок ИК пульта – Клик по "левой" кнопке- уменьшить значение номера кнопки ИК пульта
– Клик по "правой" кнопке- увеличить значение номера кнопки ИК пульта
– Удержать"среднюю" кнопку -сбросить текущую кнопку ИК пульта

Нумерация кнопок:
– 1 - левая клик
– 2 - Левая удержание
– 3 - Правая клик
– 4 - Правая удержание
– 5 -Средняя клик
– 6 -Средняя удержание
– 7 - Доп. кнопка клик
– 8 - Доп. кнопка удержание

– 9 - Вкл/выкл питание радио
– 10 - Прибавить громкость радио
– 11 - Убавить громкость радио
– 12 - Переключить на следующую радиостанцию – 13 - Переключить на предыдущую радиостанцию – 14..23 - Переключить на ячейку памяти радиостанции 0..9

Калибровка датчика освещённости:
1. Войти в режим отладки (удержание"левой" кнопки при подаче питания)
2. Выбрать пункт меню отладки 07(калибровка датчика освещенности)
3. Поставить часы в светлое место(на 1-3 сек)
4. Поставить часы в тёмное место(на 1-3 сек)
5. Клик средней кнопкой (выйти к выбору пунктов меню отладки)
6. Удержаниесредней кнопки (выйти из меню отладки и сохранить настройки)
