Dimasssius/DIY_Alliance_NixieClock_Userland/hardcore/assembly/hardcore-boards-x6-tubes/base-configuration/pcb-3d-print/Bottom Layer (Black, Assembled).png

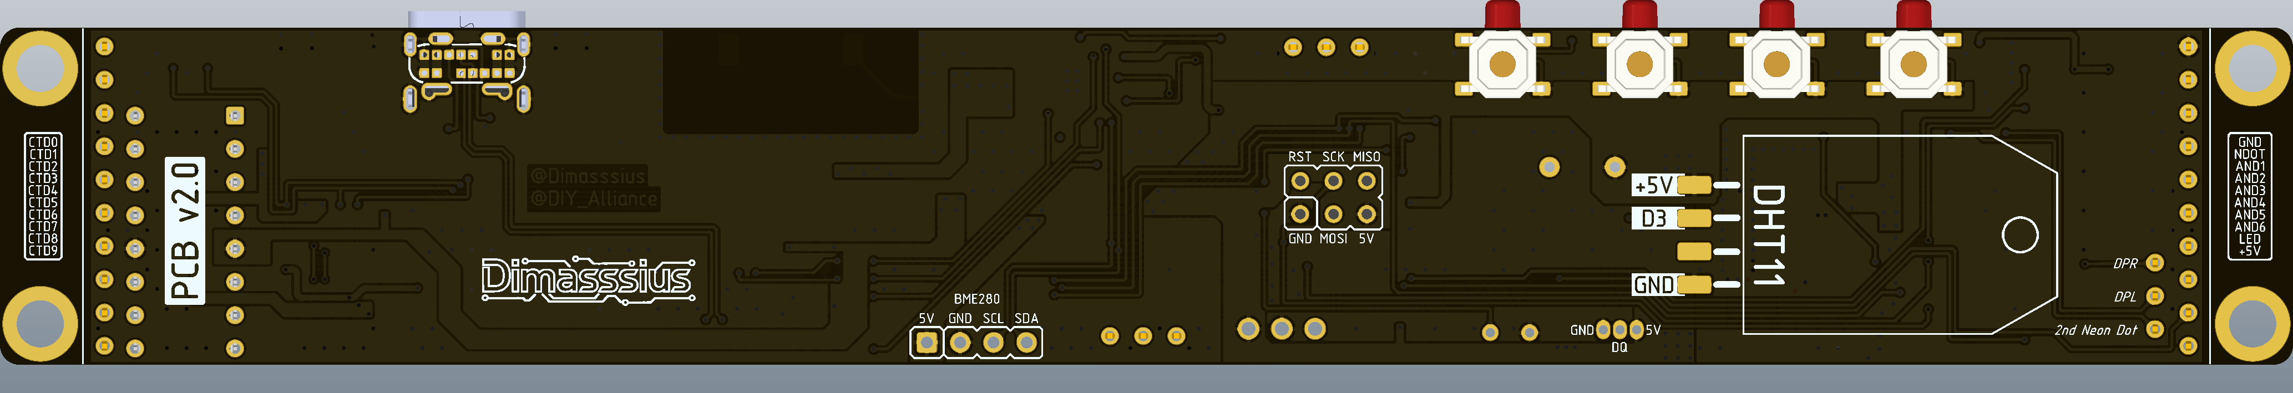
hardcore/assembly/hardcore-boards-x6-tubes/base-configuration/pcb-3d-print/Bottom Layer (Black, Assembled).png
