Dimasssius/DIY_Alliance_NixieClock_Userland/hardcore/assembly/hardcore-boards-x6-tubes/base-configuration/pcb-3d-print/Top Layer (Black, Assembled).png

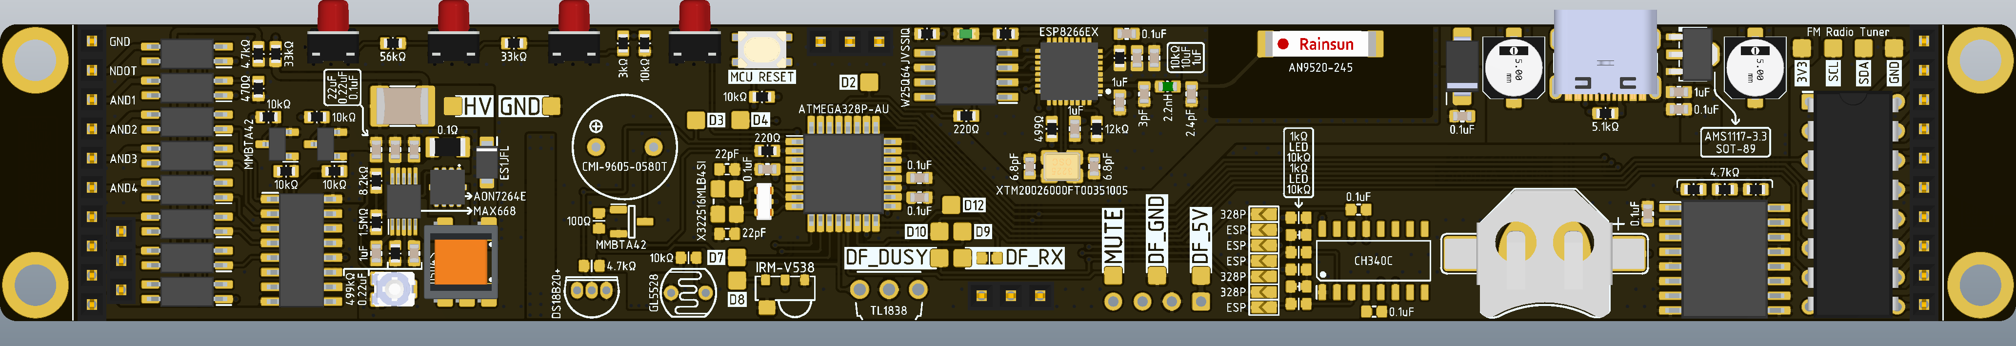
hardcore/assembly/hardcore-boards-x6-tubes/base-configuration/pcb-3d-print/Top Layer (Black, Assembled).png
