Dimasssius/DIY_Alliance_NixieClock_Userland/standard/assembly/standard-boards-x4-tubes/pcb-3d-print/Верхний слой (Собранная печатная плата, Выводные компоненты, Вертикальные индикаторы).png

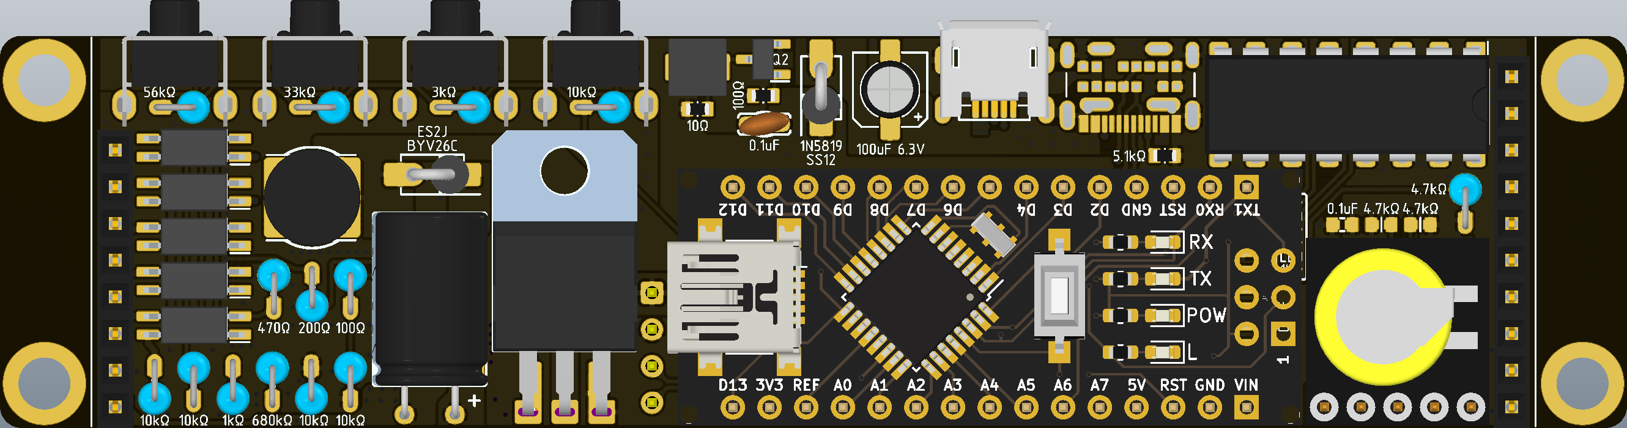
standard/assembly/standard-boards-x4-tubes/pcb-3d-print/Верхний слой (Собранная печатная плата, Выводные компоненты, Вертикальные индикаторы).png
