Dimasssius/DIY_Alliance_NixieClock_Userland/standard/assembly/standard-boards-x4-tubes/pcb-3d-print/Нижний слой (Печатная плата).png

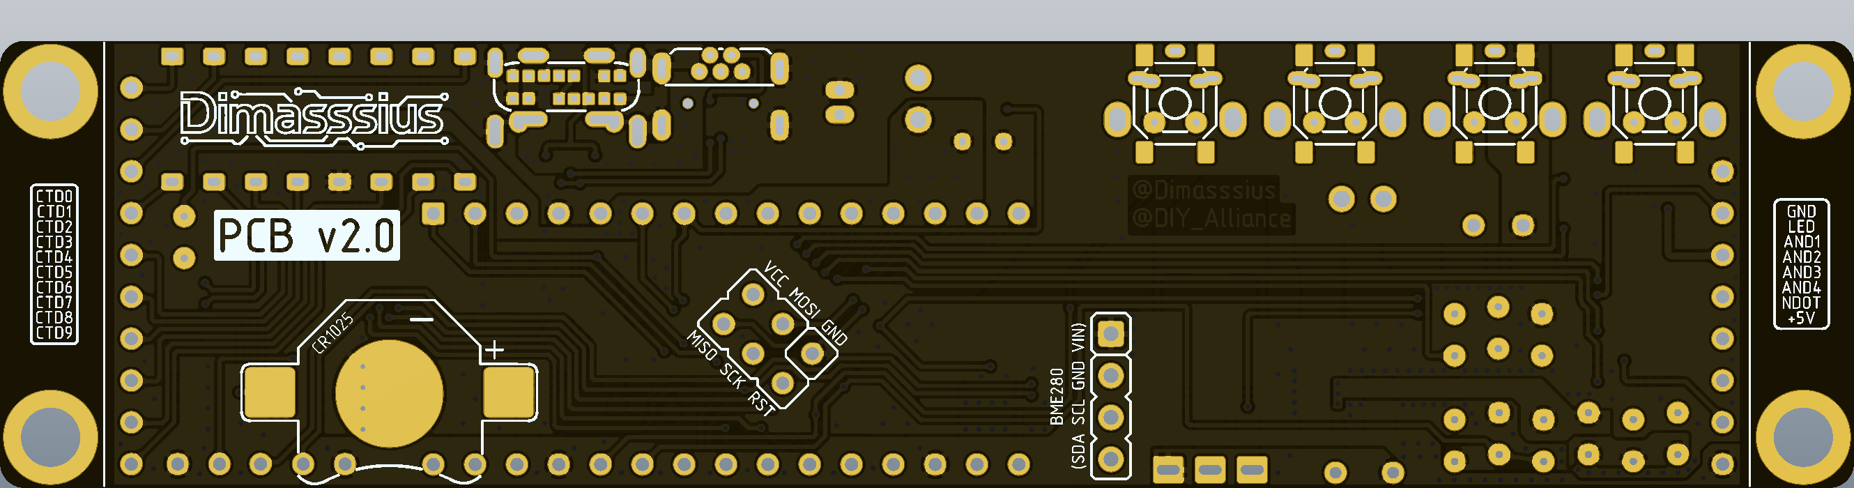
standard/assembly/standard-boards-x4-tubes/pcb-3d-print/Нижний слой (Печатная плата).png
