Dimasssius/DIY_Alliance_NixieClock_Userland/standard/assembly/standard-boards-x4-tubes/pcb-3d-print/Нижний слой (Собранная печатная плата, Поверхностный монтаж, Вертикальные индикаторы).png

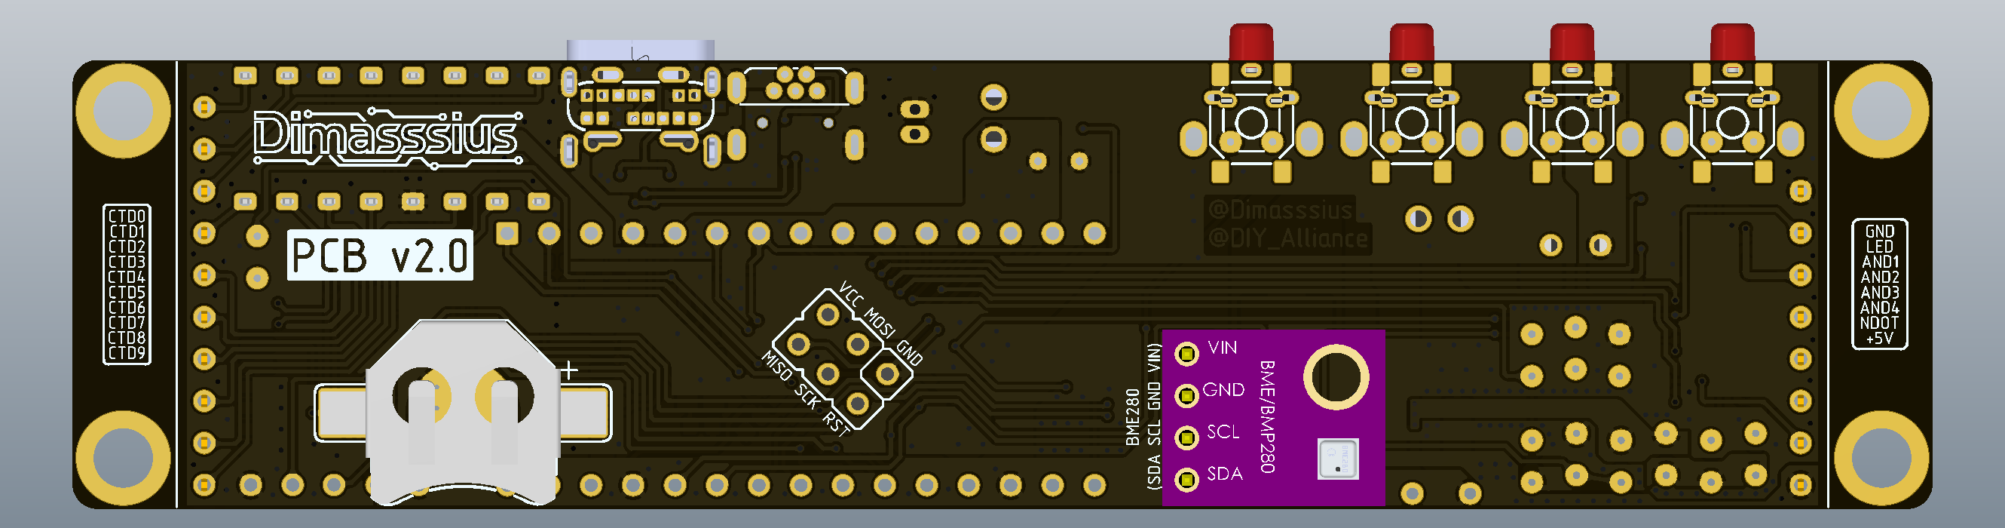
standard/assembly/standard-boards-x4-tubes/pcb-3d-print/Нижний слой (Собранная печатная плата, Поверхностный монтаж, Вертикальные индикаторы).png
