Dimasssius/DIY_Alliance_NixieClock_Userland/standard/assembly/standard-boards-x4-tubes/pcb-3d-print/Нижний слой (Собранная печатная плата, Поверхностный монтаж, Горизонтальные индикаторы).png

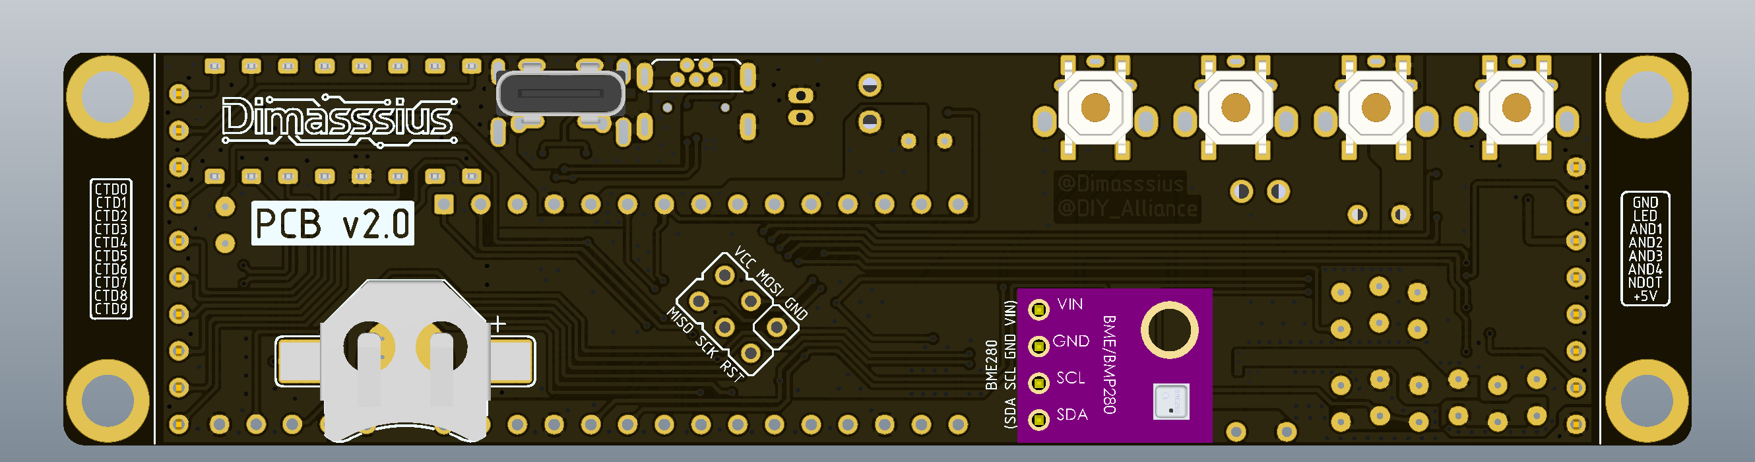
standard/assembly/standard-boards-x4-tubes/pcb-3d-print/Нижний слой (Собранная печатная плата, Поверхностный монтаж, Горизонтальные индикаторы).png
