Dimasssius/DIY_Alliance_NixieClock_Userland/standard/assembly/standard-boards-x6-tubes/pcb-3d-print/Верхний слой (Собранная печатная плата, Выводные компоненты, Горизонтальные индикаторы).png

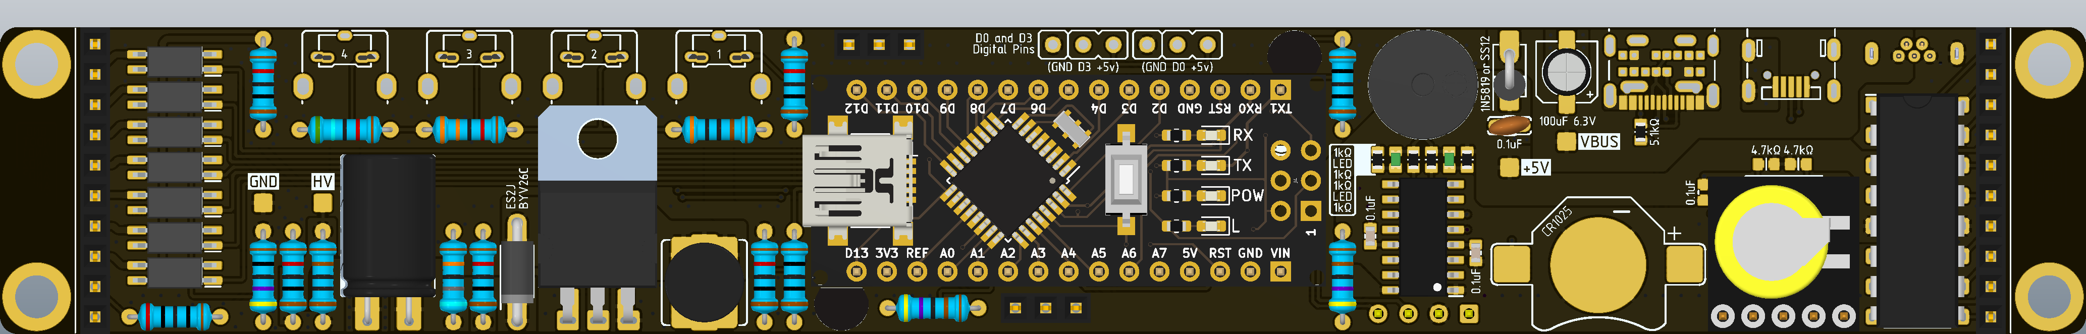
standard/assembly/standard-boards-x6-tubes/pcb-3d-print/Верхний слой (Собранная печатная плата, Выводные компоненты, Горизонтальные индикаторы).png
