Dimasssius/DIY_Alliance_NixieClock_Userland/standard/assembly/standard-boards-x6-tubes/pcb-3d-print/Верхний слой (Собранная печатная плата, Поверхностный монтаж, Вертикальные индикаторы).png

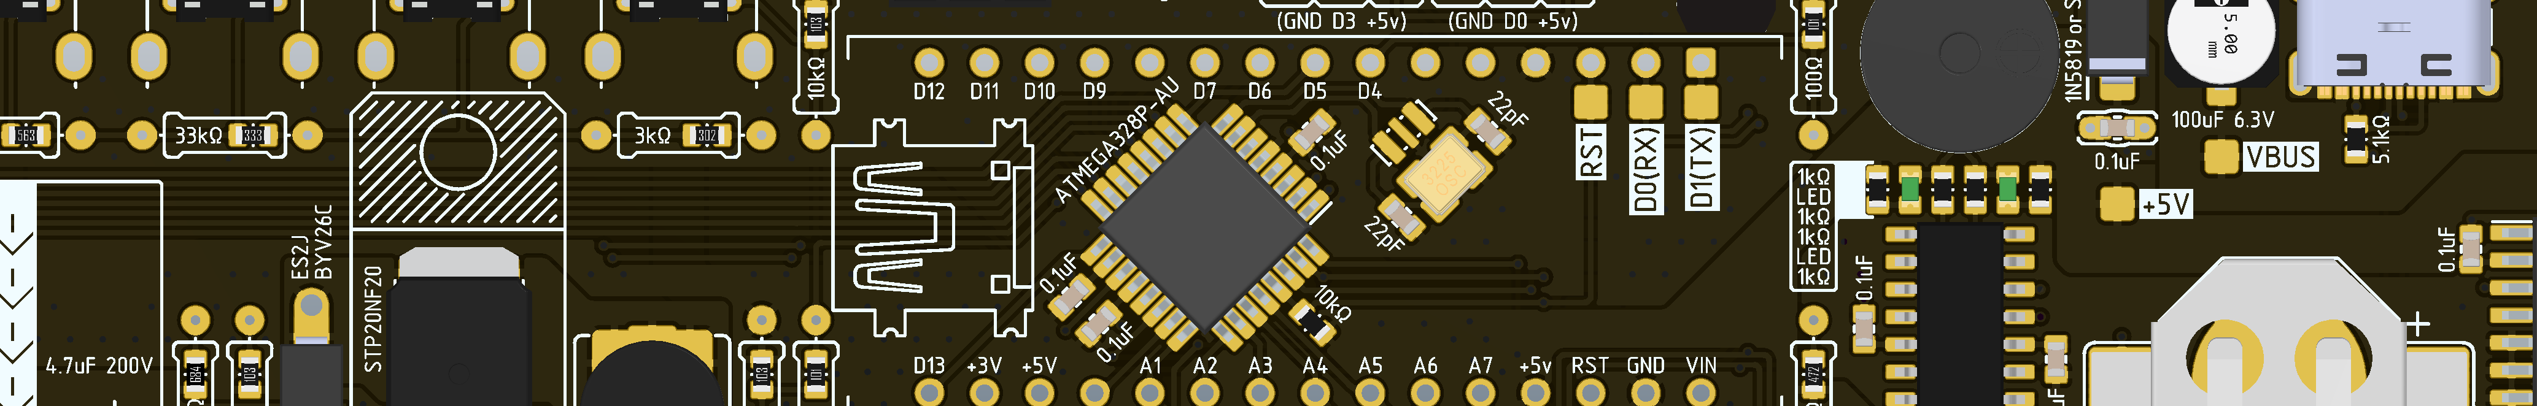
standard/assembly/standard-boards-x6-tubes/pcb-3d-print/Верхний слой (Собранная печатная плата, Поверхностный монтаж, Вертикальные индикаторы).png
