Dimasssius/DIY_Alliance_NixieClock_Userland/standard/assembly/standard-boards-x6-tubes/pcb-3d-print/Нижний слой (Собранная печатная плата, Выводные компоненты, Вертикальные индикаторы).png

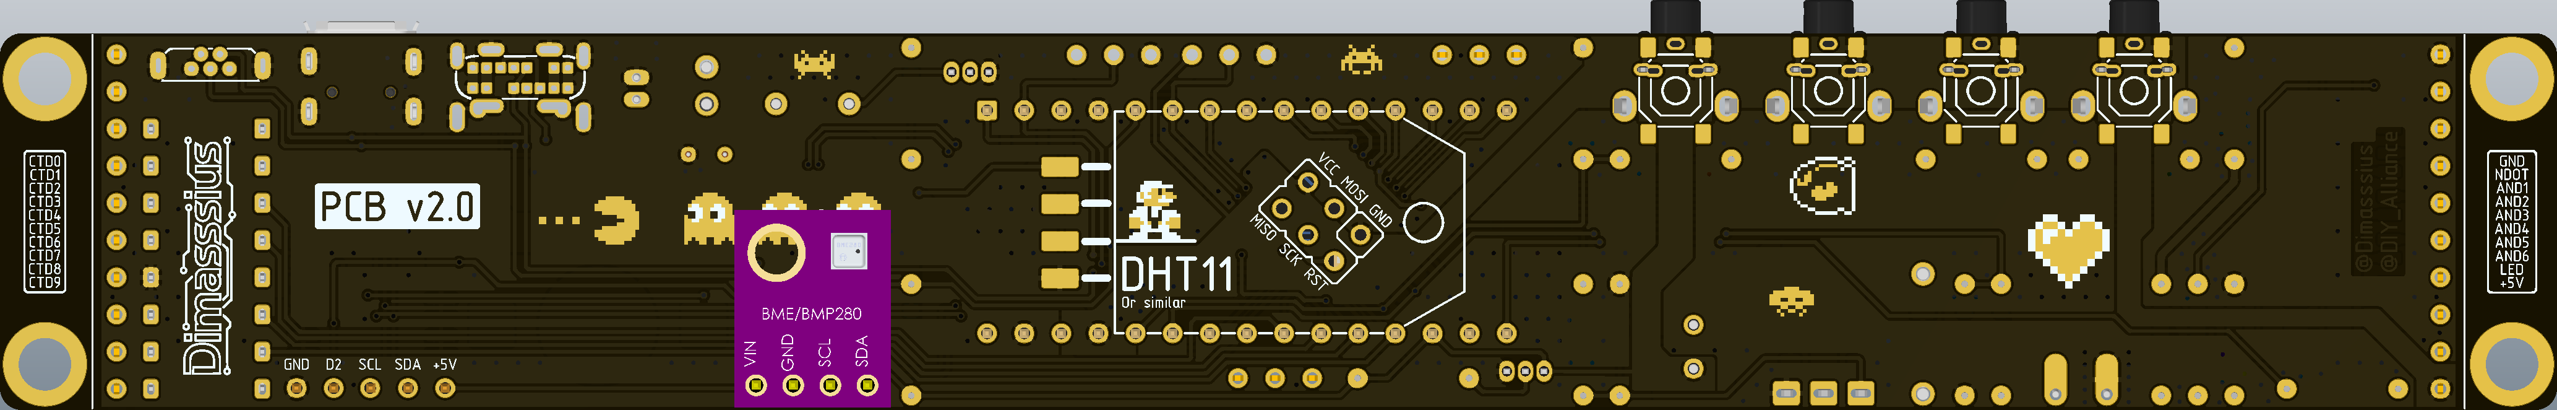
standard/assembly/standard-boards-x6-tubes/pcb-3d-print/Нижний слой (Собранная печатная плата, Выводные компоненты, Вертикальные индикаторы).png
