Dimasssius/DIY_Alliance_NixieClock_Userland/CHANGELOG.md

[Главная](README.md) / История изменений

# 📝 История изменений

## 10 октября 2026 — визуальное оформление

- Добавлена тематическая обложка для главной и разделов Standard/Hardcore.
- В заголовках и основной навигации появились умеренные тематические эмодзи.
- Все 130 существующих таблиц получили единое выравнивание: описания слева, форматы, коды и превью по центру.
- Коды ошибок и номера пунктов меню выделены моноширинным шрифтом; ключевые подписи в таблицах — полужирным.
- Сохранены заголовки технических разделов и прежние якоря разделов главной.
- Добавлены [правила использования баннера](images/banners/README.md) и исходный промпт.

## 10 октября 2026 — навигация и подача Wiki

- Главная переработана под задачи пользователей и визуальный выбор четырёх плат.
- Добавлен маршрут от выбора сборки до настройки и проверки часов.
- Страницы плат, комплектаций и 54 каталога материалов получили русские названия, навигацию и прямые ссылки на файлы.
- Исправлены переходы из FAQ к схемам, индикаторам и диагностике.
- Уточнено отсутствие готовых прошивок и отдельной пошаговой инструкции Hardcore.
- В общие руководства добавлены быстрые переходы, в диагностику — таблица симптомов.
- База индикаторов сокращена без потери вариантов и списков совместимых сокетов; добавлена галерея советских моделей.
- Пустые разделы изображений получили явный статус и ссылки на доступные материалы.
- Сохранены существующие пути и файлы плат; подготовлен [аудит и список следующих улучшений](WIKI_REVIEW.md).

## 2.0

- Подготовлена публичная структура репозитория для документации, прошивок и полезных файлов.
- Разделены материалы для Standard Edition и Hardcore Edition.
- Добавлены комплектации для плат Hardcore: Minimal, Base и Maximal.
- Материалы сборки Hardcore разделены на версии Hardcore Boards x4 Tubes и Hardcore Boards x6 Tubes.
- Материалы сборки Standard разделены на версии Standard Boards x4 Tubes и Standard Boards x6 Tubes.
- Убраны дублирующие верхние сборочные папки Standard и Hardcore; BOM, схемы, изображения и 3D-материалы перенесены в `assembly/`.
- Удалены папки `status-report` и файлы `Status Report.Txt` из сборочных материалов.
- Уточнены условия лицензирования: код и прошивки распространяются по MIT, документация и проектные материалы - по CC BY 4.0.
- Зафиксировано, что Gerber-файлы и исходники печатных плат в репозитории не публикуются.
- Добавлена информация об используемой прошивке [radon-lab/NixieClock](https://github.com/radon-lab/NixieClock) и ее адаптации под платы DIY_Alliance.
- Добавлены PDF-инструкции по сборке Standard Boards x4/x6 Tubes и краткие заметки по важным пунктам сборки.
- Добавлено общее руководство по эксплуатации и структурированная выжимка по управлению кнопками.
- В common добавлены общие материалы по сборке, настройке прошивки, подбору катодной маски, порядку анодов и типовым проблемам.
- Раздел troubleshooting перенесен в common как общий раздел диагностики для всех плат.
- Добавлена база поддерживаемых индикаторов и совместимых сокетов в common.
- Рендеры голых печатных плат добавлены в README соответствующих разделов и таблицы версий Standard и Hardcore.
