Dimasssius/DIY_Alliance_NixieClock_Userland/FAQ.md

[Главная](README.md) / Частые вопросы

# ❓ Частые вопросы

Если вы только получили плату, начните с [маршрута сборки](START_HERE.md). Если часы работают неправильно, откройте [диагностику по симптомам](common/troubleshooting/README.md).

## Где найти документы для моей платы?

Выберите [Standard](standard/README.md) или [Hardcore](hardcore/README.md), затем число индикаторов. Для Hardcore дополнительно выберите комплектацию Minimal, Base или Maximal.

На странице платы или комплектации находятся ссылки на BOM, схемы, сборочные чертежи и рендеры. Для Standard также учитывайте вариант монтажа и ориентацию индикаторов.

## Где скачать прошивку?

Готовые сборки прошивок для DIY_Alliance здесь пока не опубликованы. В документации указана внешняя прошивка [radon-lab/NixieClock](https://github.com/radon-lab/NixieClock), которую необходимо настроить под свою плату.

В Wiki доступны [общие пояснения](common/firmware/README.md), [порядок настройки](common/firmware/CONFIGURATION.md) и заметки по совместимости [Standard](standard/firmware/README.md) и [Hardcore](hardcore/firmware/README.md).

## Где находятся электрические схемы?

Схемы лежат в разделе **«Электрические схемы»** на странице выбранной платы или комплектации. Папка с файлами называется `schematic-print/`.

Выбор платы: [Standard x4/x6](standard/assembly/README.md) · [Hardcore x4/x6](hardcore/assembly/README.md).

## Есть ли инструкция по сборке?

Для Standard доступны [две PDF-инструкции: на 4 и на 6 индикаторов](standard/manuals/README.md).

Для Hardcore отдельная пошаговая инструкция пока не опубликована. Используйте [общие рекомендации и материалы своей комплектации](hardcore/manuals/README.md); не переносите расположение компонентов со Standard без сверки со схемой Hardcore.

## Что такое BOM и какой файл открыть?

BOM — перечень компонентов: номиналы, корпуса, количество и примечания к сборке. **PDF** удобен для просмотра, **Excel** — для работы со списком.

У Standard есть отдельные списки для выводного и поверхностного монтажа, вертикальных и горизонтальных индикаторов. У Hardcore список выбирается по числу индикаторов и комплектации.

## Какие индикаторы поддерживаются?

Список моделей, конфигураций и совместимых посадочных мест находится в [базе индикаторов](common/indicators/README.md).

Совпадение сокета нужно проверять вместе с электрическими и механическими параметрами конкретной сборки.

## Как настроить время, подсветку и будильник?

Откройте [руководство пользователя](common/manuals/USER_GUIDE.md). Полная [PDF-инструкция по эксплуатации](<common/manuals/Руководство по эксплуатации.pdf>) находится в том же разделе.

Наличие функций зависит от установленной периферии и настроек прошивки.

## Часы не работают. С чего начать?

Откройте [диагностику по симптомам](common/troubleshooting/README.md). Для ошибок при запуске есть [таблица кодов](common/manuals/USER_GUIDE.md#коды-ошибок).

При проверке используйте BOM и схему именно своей платы и комплектации.

## Какие данные подготовить для обращения за помощью?

Укажите:

- линейку, количество индикаторов и ревизию платы;
- комплектацию Hardcore или вариант монтажа Standard;
- модель индикаторов и установленную периферию;
- источник и версию прошивки, внесённые настройки;
- симптом, код ошибки и этап, на котором возникла проблема;
- что уже проверили; приложите чёткие фотографии обеих сторон платы, если вопрос связан с монтажом.

Автор проекта: **DIY_Alliance / @Dimasssius**.

## Где находятся Gerber-файлы? Можно ли заказать плату по материалам Wiki?

Gerber-файлы, исходники печатных плат и производственные PCB-проекты здесь не публикуются. Wiki предназначена для владельцев готовых плат и наборов. Подробнее — в [условиях использования материалов](LICENSE).

## Что нужно учесть перед первым включением?

В часах используется высокое напряжение. Прочитайте [подготовку к сборке](common/manuals/ASSEMBLY_GUIDE.md), проверьте монтаж, полярность питания и отсутствие коротких замыканий. Пайку и исправление монтажа выполняйте при отключённом питании.
