Dimasssius/DIY_Alliance_NixieClock_Userland/common/troubleshooting/README.md

[Главная](../../README.md) / [Общие материалы](../README.md) / Диагностика

# 🔍 Диагностика по симптомам

Выберите проблему и перейдите к проверкам. Используйте BOM и схему своей линейки, ревизии и комплектации.

| Симптом | Что открыть |
| :--- | :--- |
| Часы не запускаются после сборки | [Общие проверки](#общий-принцип-диагностики) |
| Прошивка не загружается | [Проверка ATmega328P и bootloader](#прошивка-не-загружается-в-atmega328p) |
| Подсветка работает нестабильно | [Проверка адресных светодиодов](#нестабильная-работа-адресных-светодиодов) |
| Подсветка работает, индикаторы не светятся | [Проверка высоковольтной части](#нет-высокого-напряжения-но-подсветка-работает) |
| Запуск не удаётся с индуктивностью 150 мкГн | [Заметка по преобразователю](#часы-не-запускаются-с-индуктивностью-150-мкгн) |
| Цифры не соответствуют ожидаемым | [Катодная маска](#индикаторы-отображают-неправильные-цифры) |
| Цифры верные, но позиции перепутаны | [Порядок анодов](#индикаторы-стоят-не-на-своих-позициях) |
| При запуске есть писк и код ошибки | [Таблица кодов](../manuals/USER_GUIDE.md#коды-ошибок) |

> [!CAUTION]
> Пайку, замену компонентов и исправление монтажа выполняйте при отключённом питании. В часах есть высоковольтная часть.

Примеры с конкретными номиналами и модулями ниже сверяйте с документами своей платы. При обращении за помощью подготовьте [данные сборки и описание проблемы](../../FAQ.md#какие-данные-подготовить-для-обращения-за-помощью).

## Общий принцип диагностики

Практика показывает, что большинство неисправностей после сборки связано с качеством пайки, неправильной установкой компонентов или невнимательностью при сборке.

Если после сборки и прошивки часы не запускаются:

1. Проверьте правильность установки компонентов.
2. Проверьте ориентацию диодов, оптопар, микросхем и электролитических конденсаторов.
3. Сверьте ключи компонентов с маркировкой на плате.
4. Пропаяйте подозрительные контакты.
5. Отмойте остатки флюса, особенно в местах с высоким напряжением.
6. Проверьте питание 5 В и достаточный ток блока питания.
7. Проверьте отсутствие коротких замыканий.
8. Проверьте корректность прошивки и выбранных настроек платы.

## Прошивка не загружается в ATmega328P

Если используется новый микроконтроллер ATmega328P и прошивка не загружается, возможно, в микроконтроллер не записан bootloader.

Что сделать:

- записать bootloader программатором USBasp или USBtinyISP;
- после записи bootloader загрузить скетч обычным способом;
- проверить выбор платы, COM-порта и варианта `Old Bootloader` в Arduino IDE.

## Нестабильная работа адресных светодиодов

Нестабильная работа адресных светодиодов может быть связана с кварцевым резонатором неправильной частоты. В инструкциях отдельно отмечается, что проблемы возможны при установке резонатора с частотой, отличной от 16 МГц.

Что проверить:

- частоту кварцевого резонатора;
- качество пайки резонатора и обвязки;
- настройки прошивки и выбранной платы.

## Нет высокого напряжения, но подсветка работает

Если на собранных часах нет высокого напряжения, но подсветка работает, проверьте цепи повышающего преобразователя и элементы, связанные с его запуском.

Для плат на 6 индикаторов в инструкциях отдельно упоминается резистор `100 Ом`: он должен быть запаян на посадочное место ниже Arduino Nano, а не рядом с надписью `Buzzer`.

## Часы не запускаются с индуктивностью 150 мкГн

В некоторых случаях при использовании индуктивности `150 мкГн` часы могут не запускаться.

Проверка:

1. Выпаять индуктивность.
2. Попробовать запустить часы.
3. Если заработала подсветка, проблема может быть связана с этой индуктивностью или цепями повышающего преобразователя.
4. Проверить номинал, качество компонента и пайку.

## Индикаторы отображают неправильные цифры

Если индикаторы светятся, но цифры отображаются неправильно:

- проверьте катодную маску в `config.h`;
- проверьте порядок катодов;
- при необходимости используйте [программу подбора катодной маски](../tools/cathode-mask/);
- сверяйтесь с даташитом конкретного индикатора.

## Индикаторы стоят не на своих позициях

Если цифры правильные, но позиции индикаторов перепутаны, например вместо часов отображаются минуты:

- проверьте порядок анодов в `indication.h`;
- меняйте порядок анодов постепенно;
- после каждого изменения перепрошивайте часы и проверяйте результат;
- для четырех индикаторов не удаляйте пятый и шестой анод из списка в прошивке.

## Ошибки при запуске

Коды ошибок при запуске описаны в [User Guide](../manuals/USER_GUIDE.md#коды-ошибок).
