Dimasssius/DIY_Alliance_NixieClock_Userland/hardcore/assembly/hardcore-boards-x4-tubes/base-configuration/pcb-print/Assembly Drawings.PDF

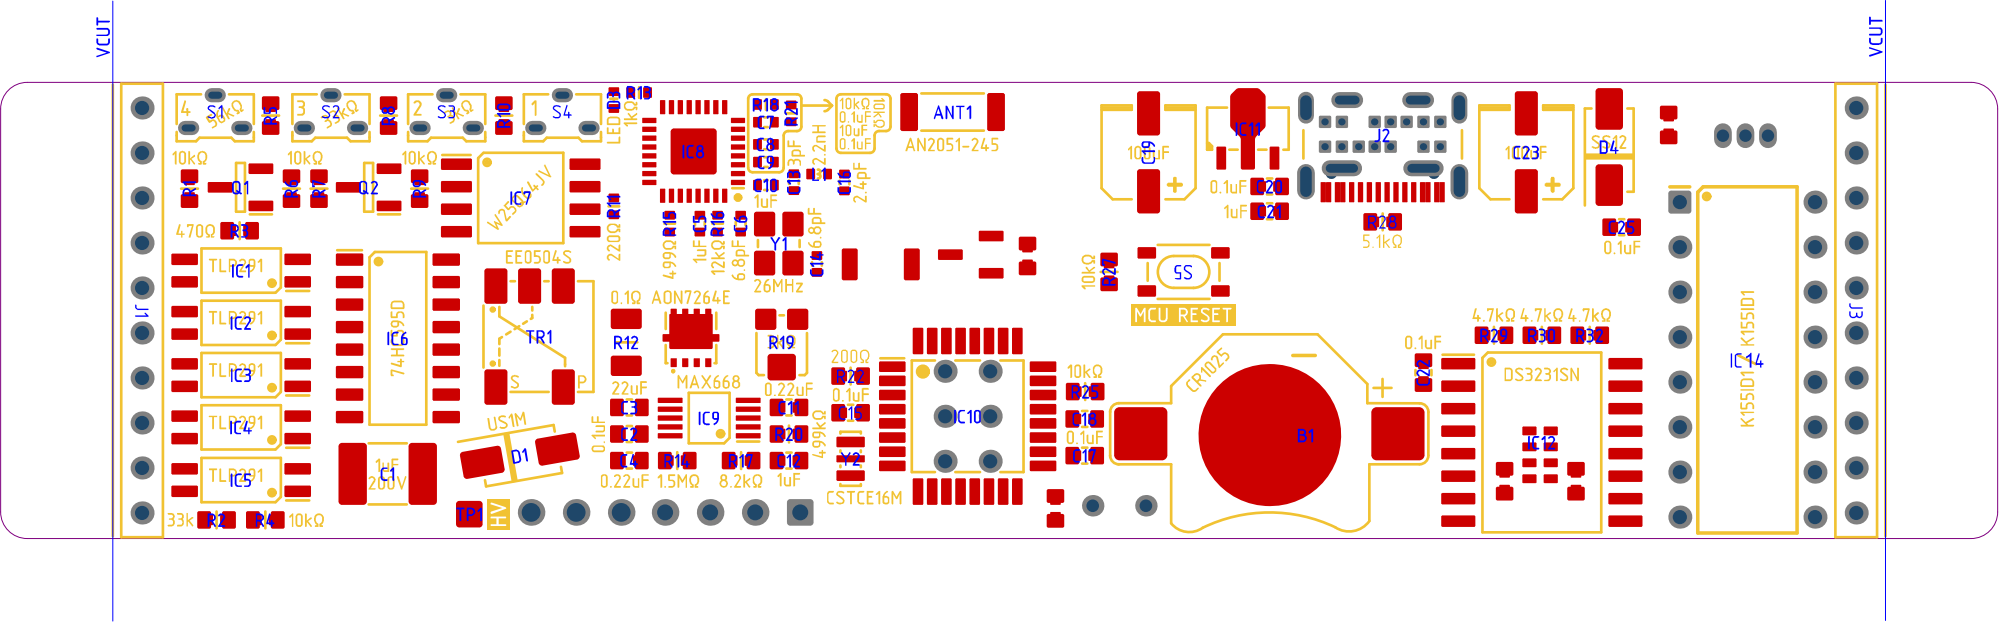
[picture p45: page 1]

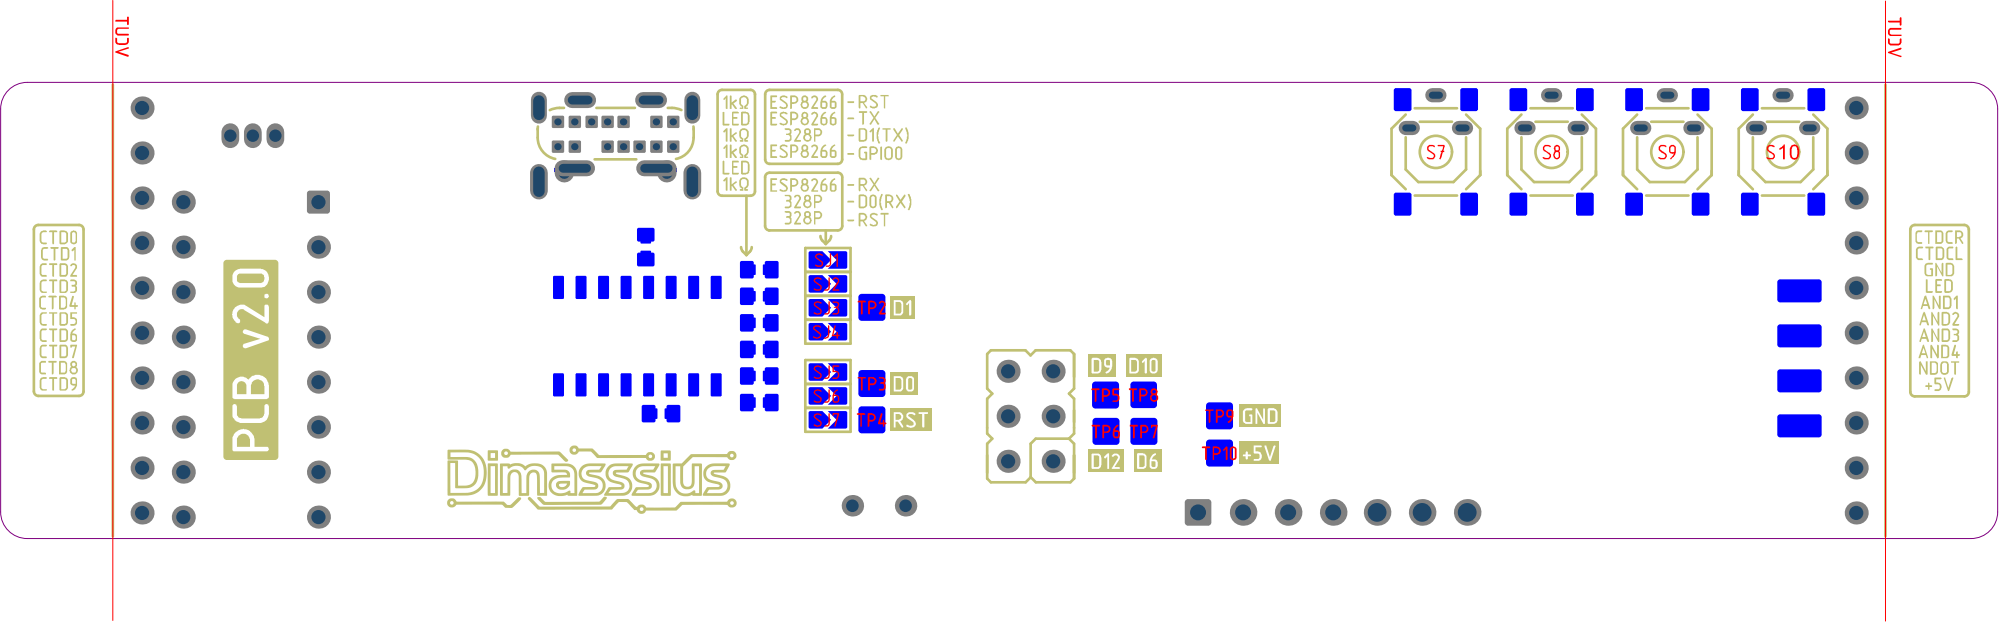
[picture p46: page 2]
