Dimasssius/DIY_Alliance_NixieClock_Userland/hardcore/assembly/hardcore-boards-x4-tubes/base-configuration/schematic-print/Schematic Prints.PDF

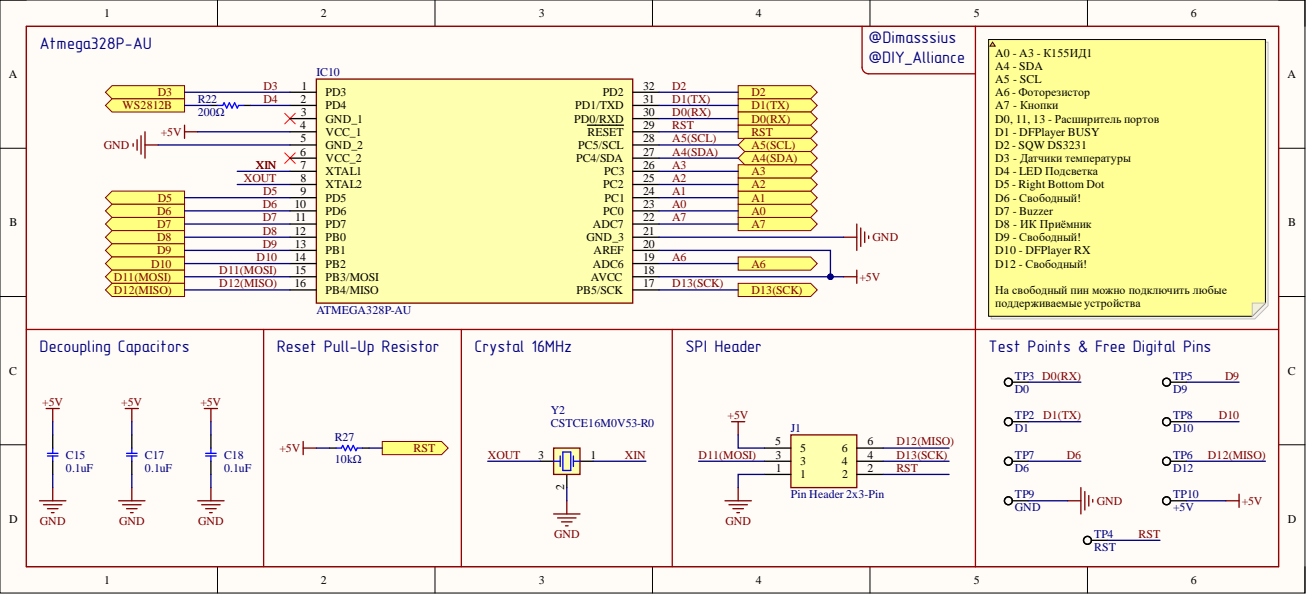
[picture p47: page 1]

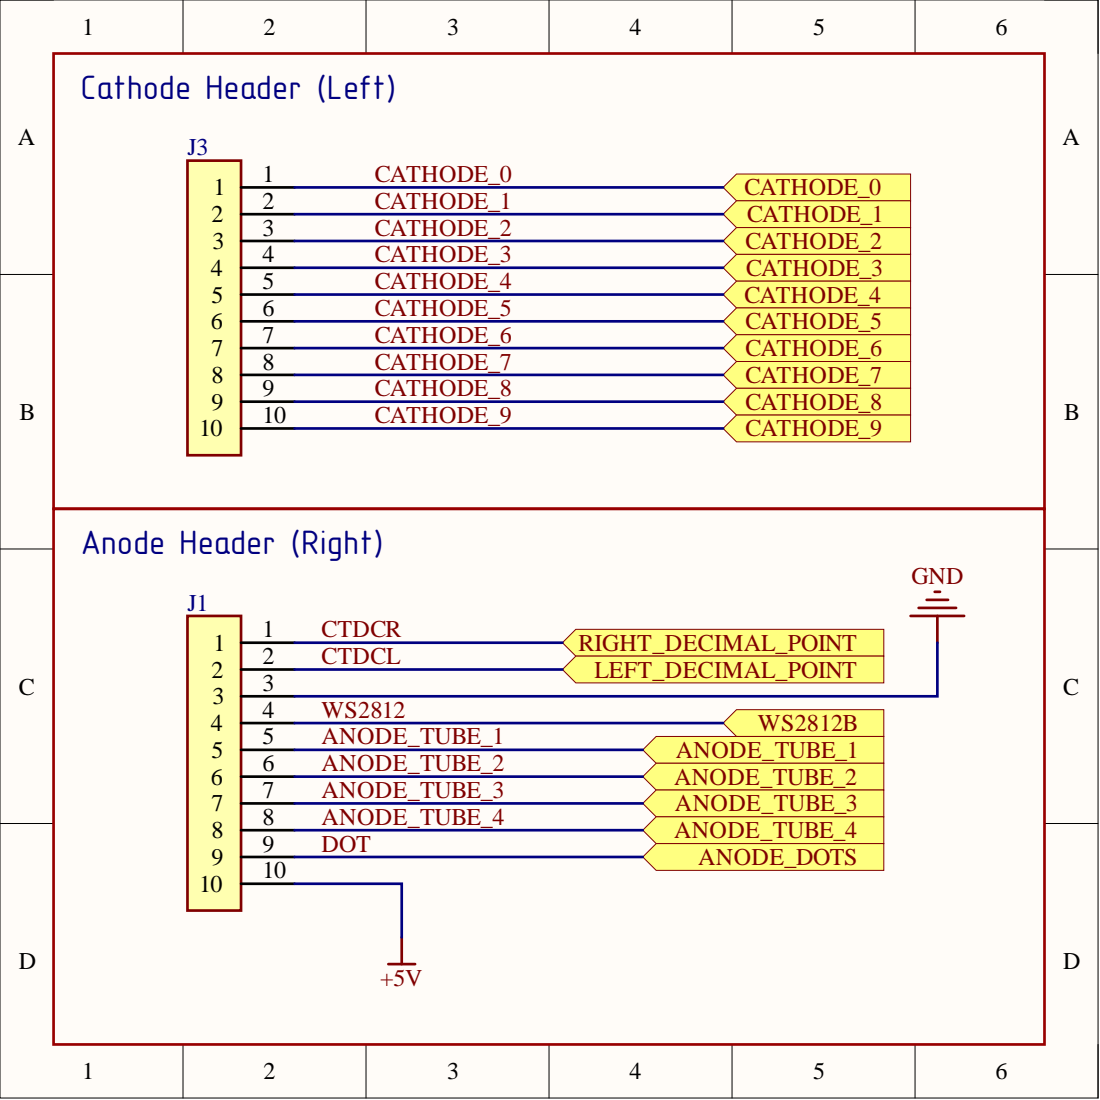
[picture p48: page 2]

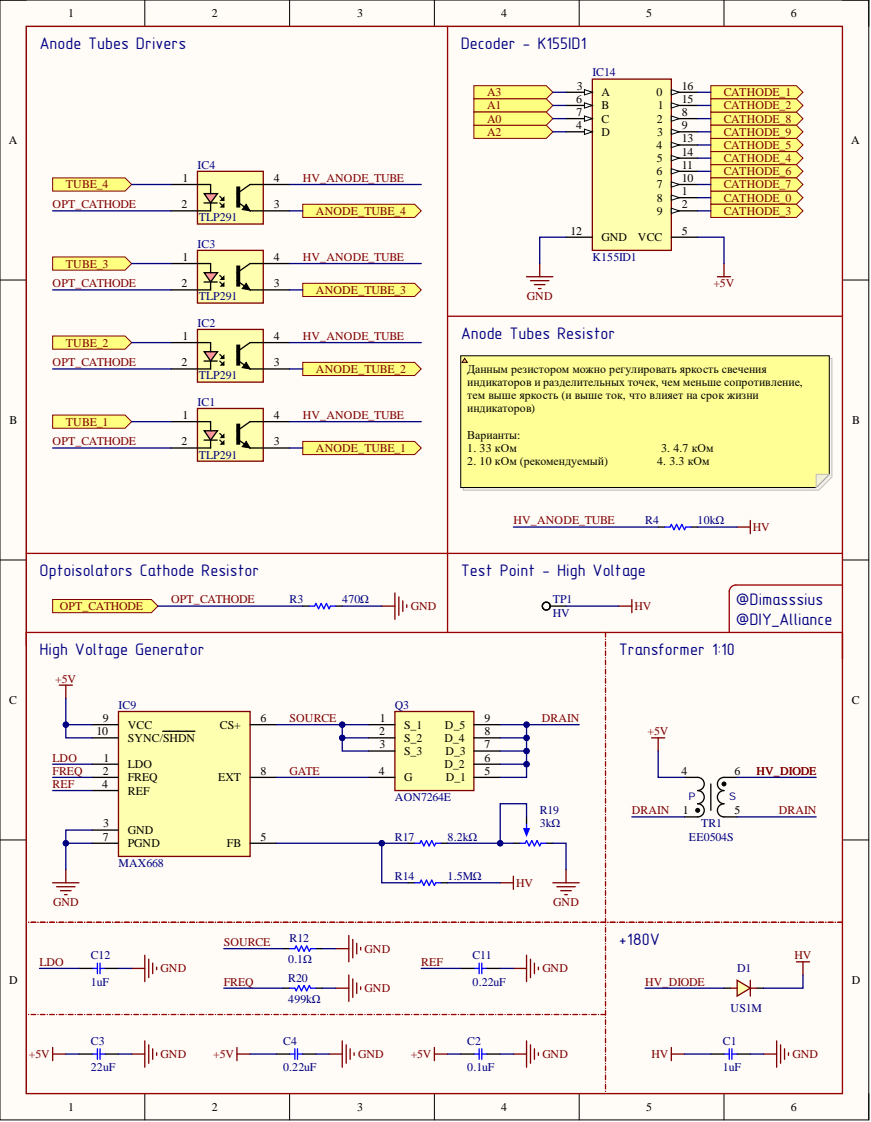
[picture p49: page 3]

Данным резистором можно регулировать яркость свечения
индикаторов и разделительных точек, чем меньше сопротивление,
тем выше яркость (и выше ток, что влияет на срок жизни
индикаторов)

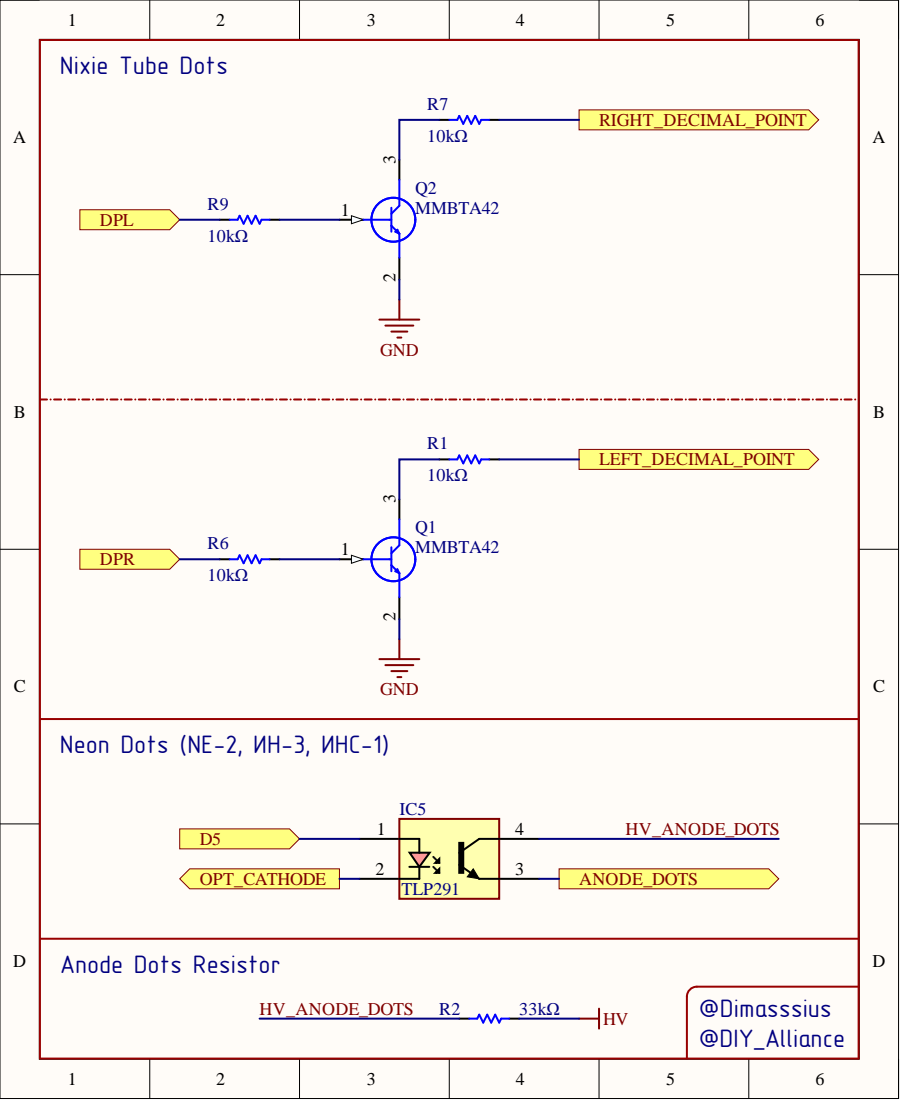
[picture p50: page 4]

Neon Dots (NE-2, ИН-3, ИНС-1)

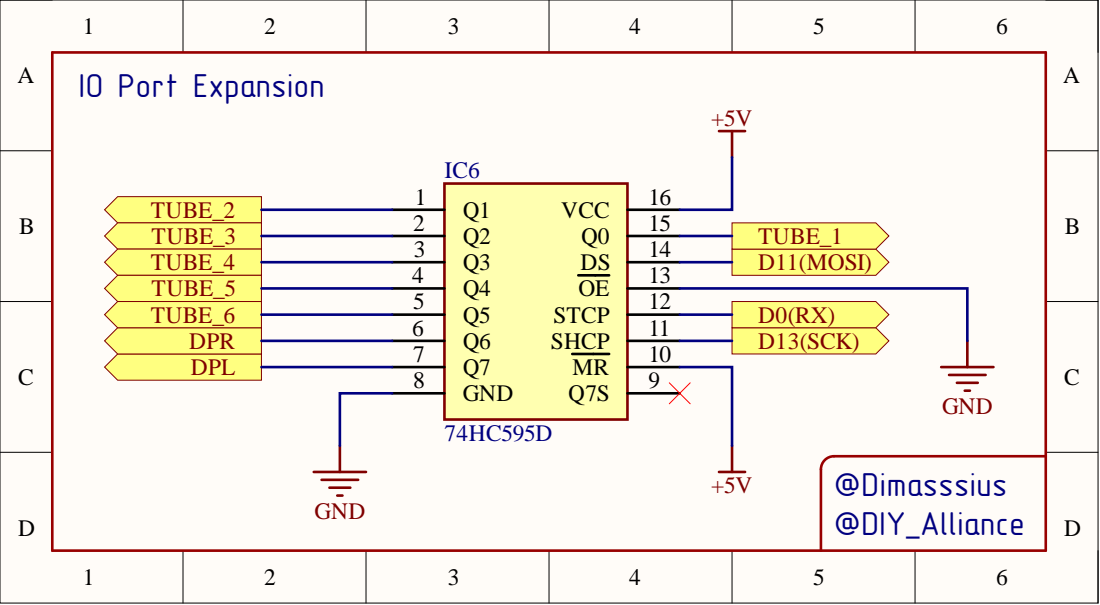
[picture p51: page 5]

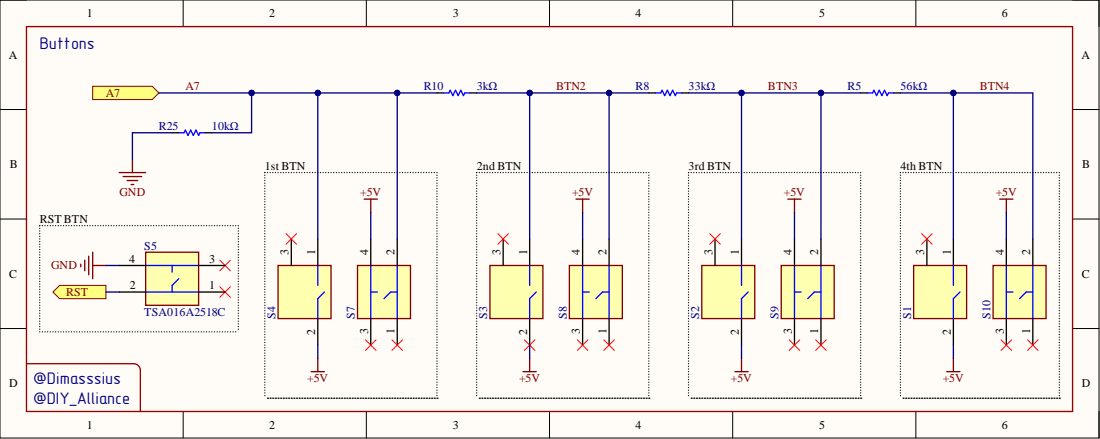
[picture p52: page 6]

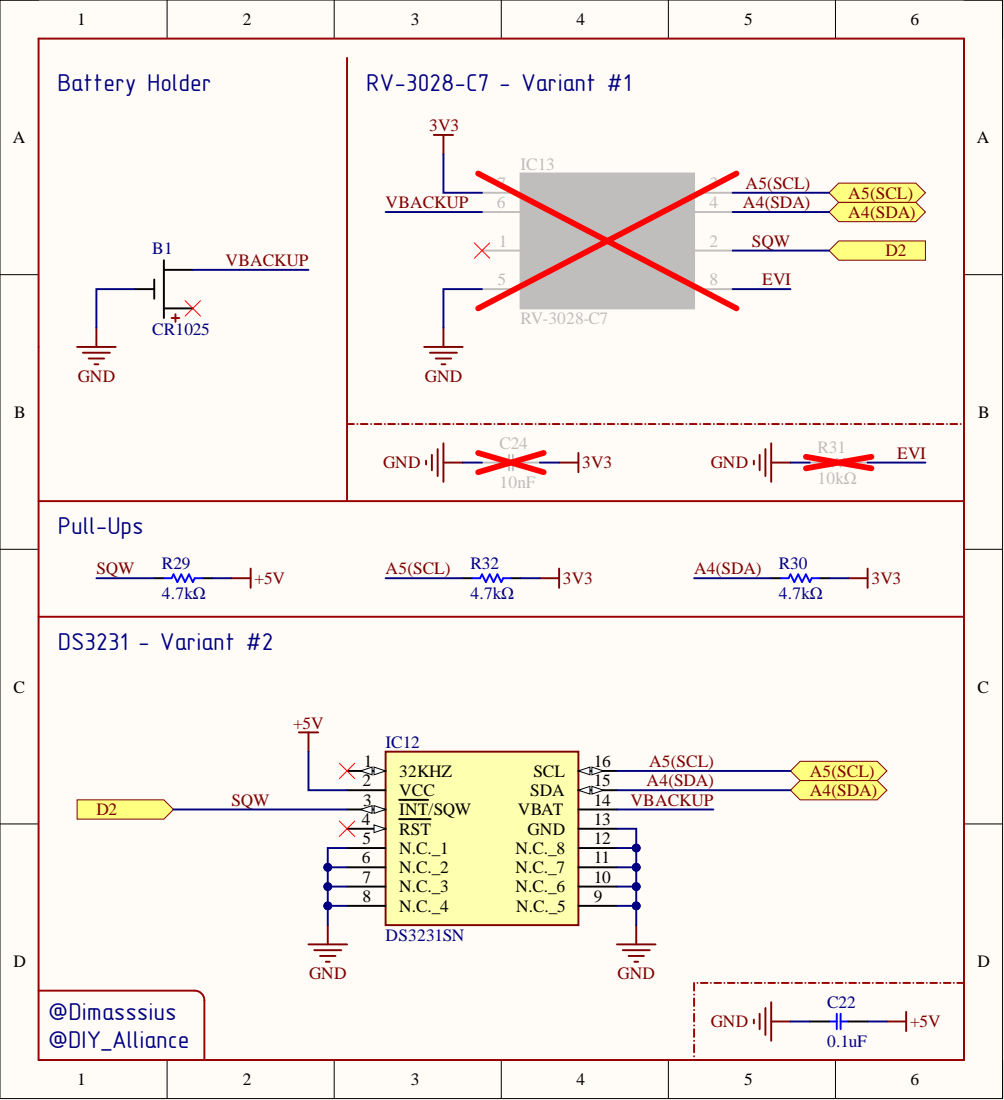
[picture p53: page 7]

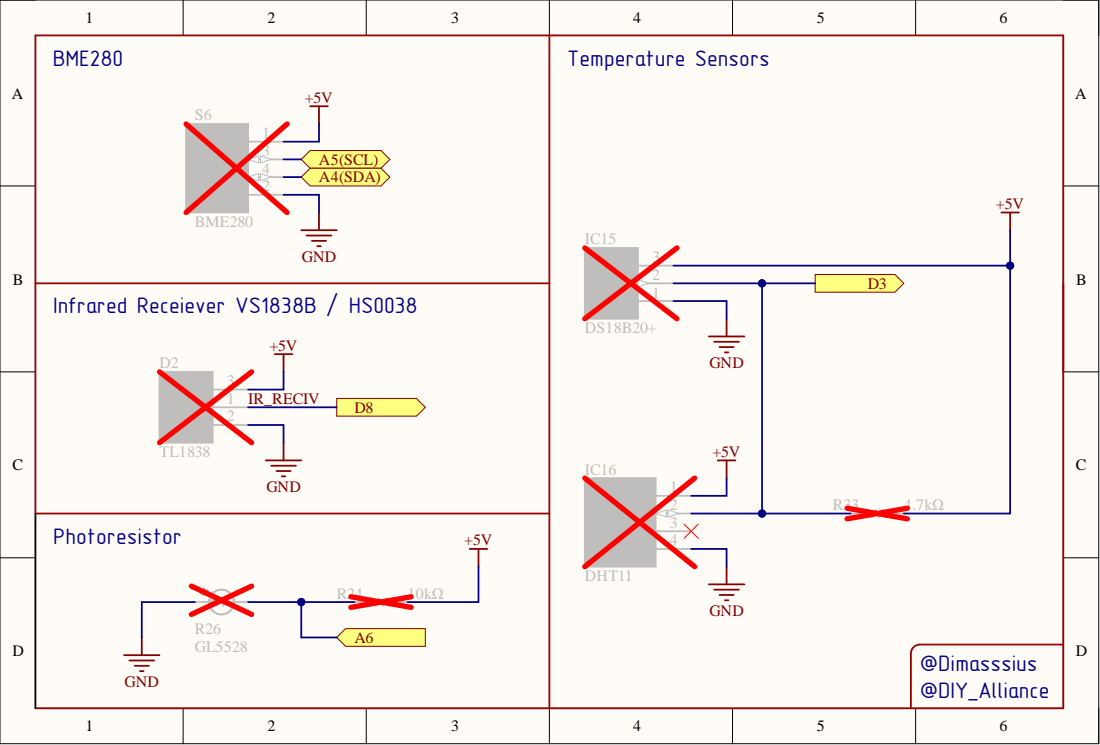
[picture p54: page 8]

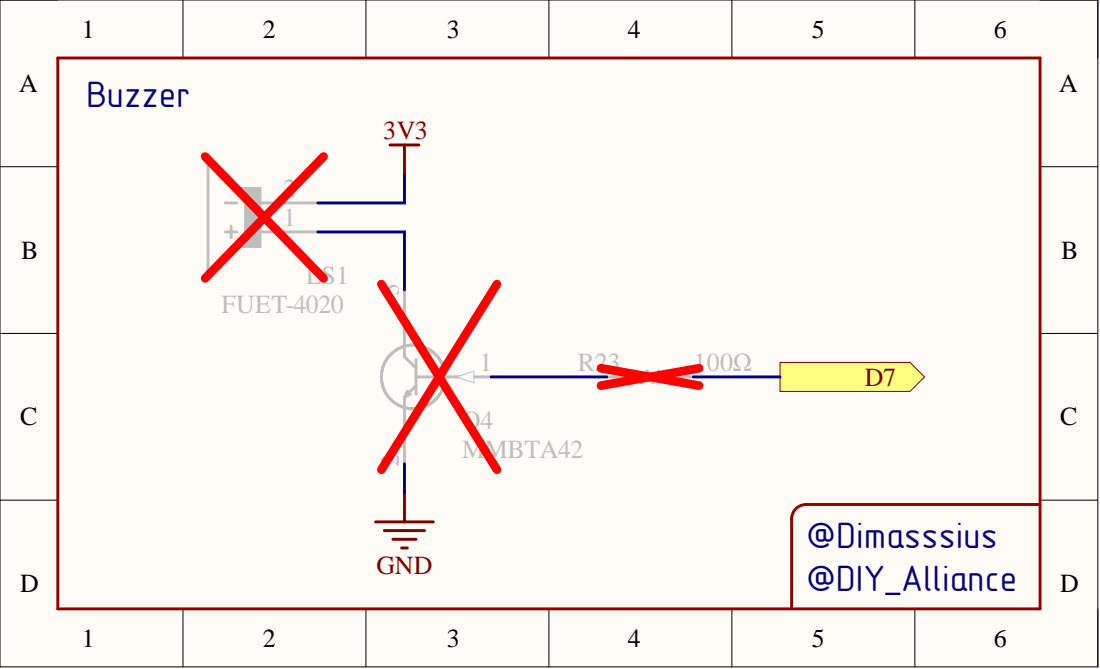
[picture p55: page 9]

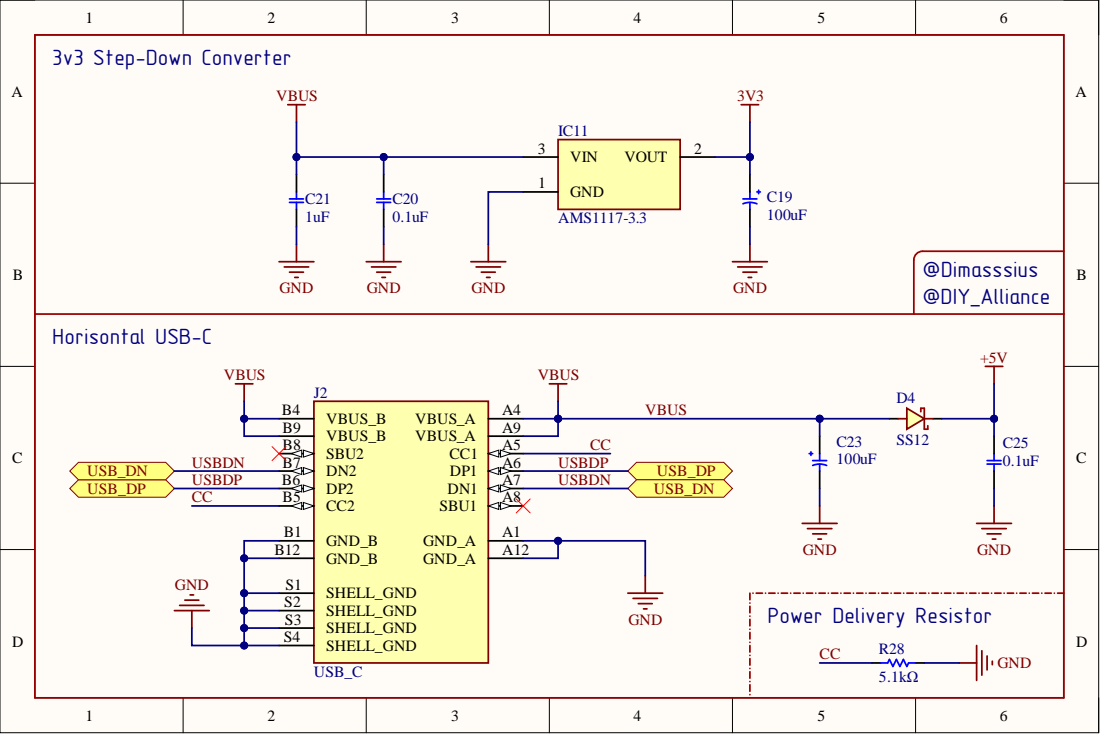
[picture p56: page 10]

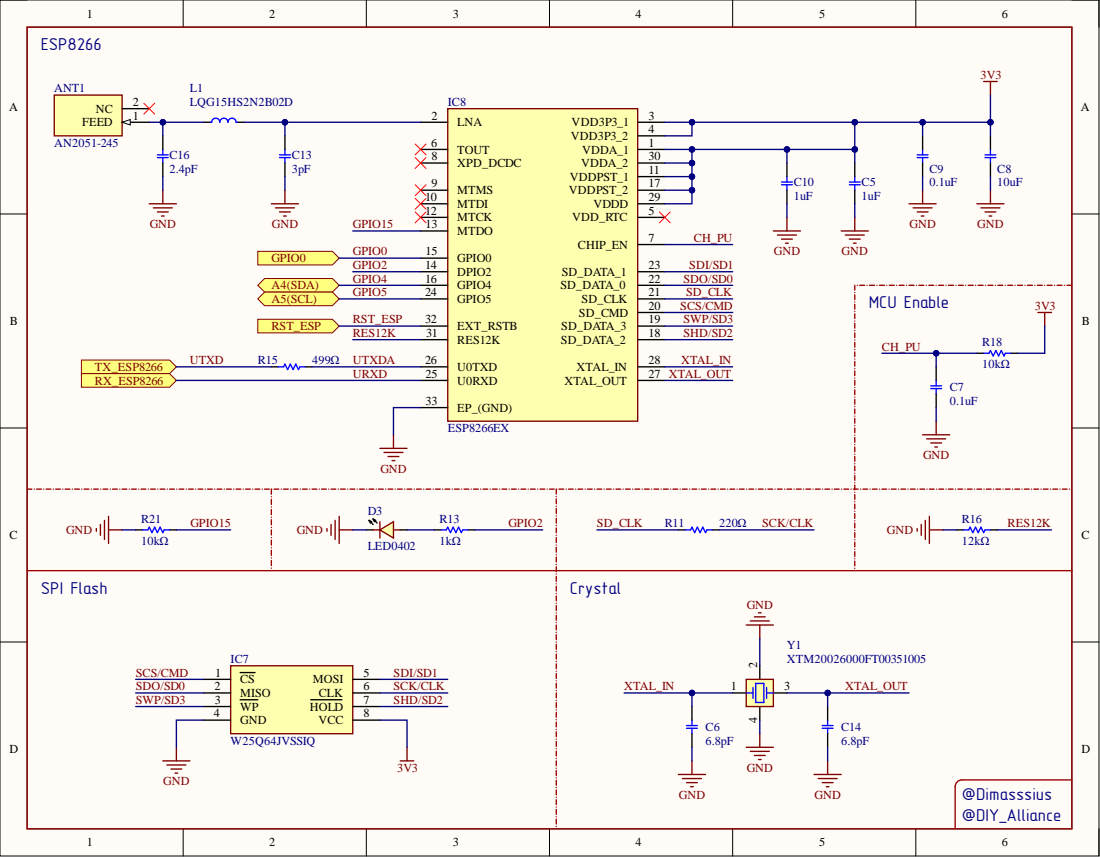
[picture p57: page 11]

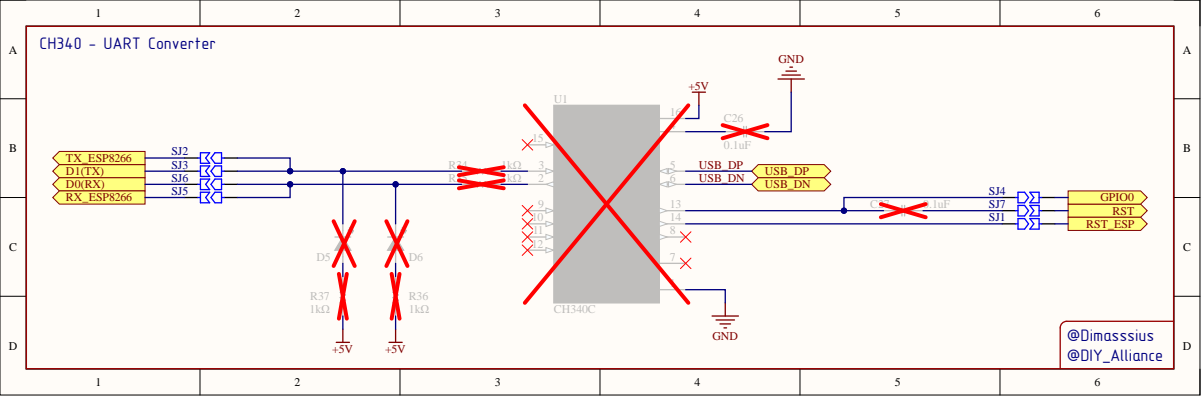
[picture p58: page 12]
