Dimasssius/DIY_Alliance_NixieClock_Userland/hardcore/assembly/hardcore-boards-x4-tubes/maximal-configuration/pcb-print/Assembly Drawings.PDF

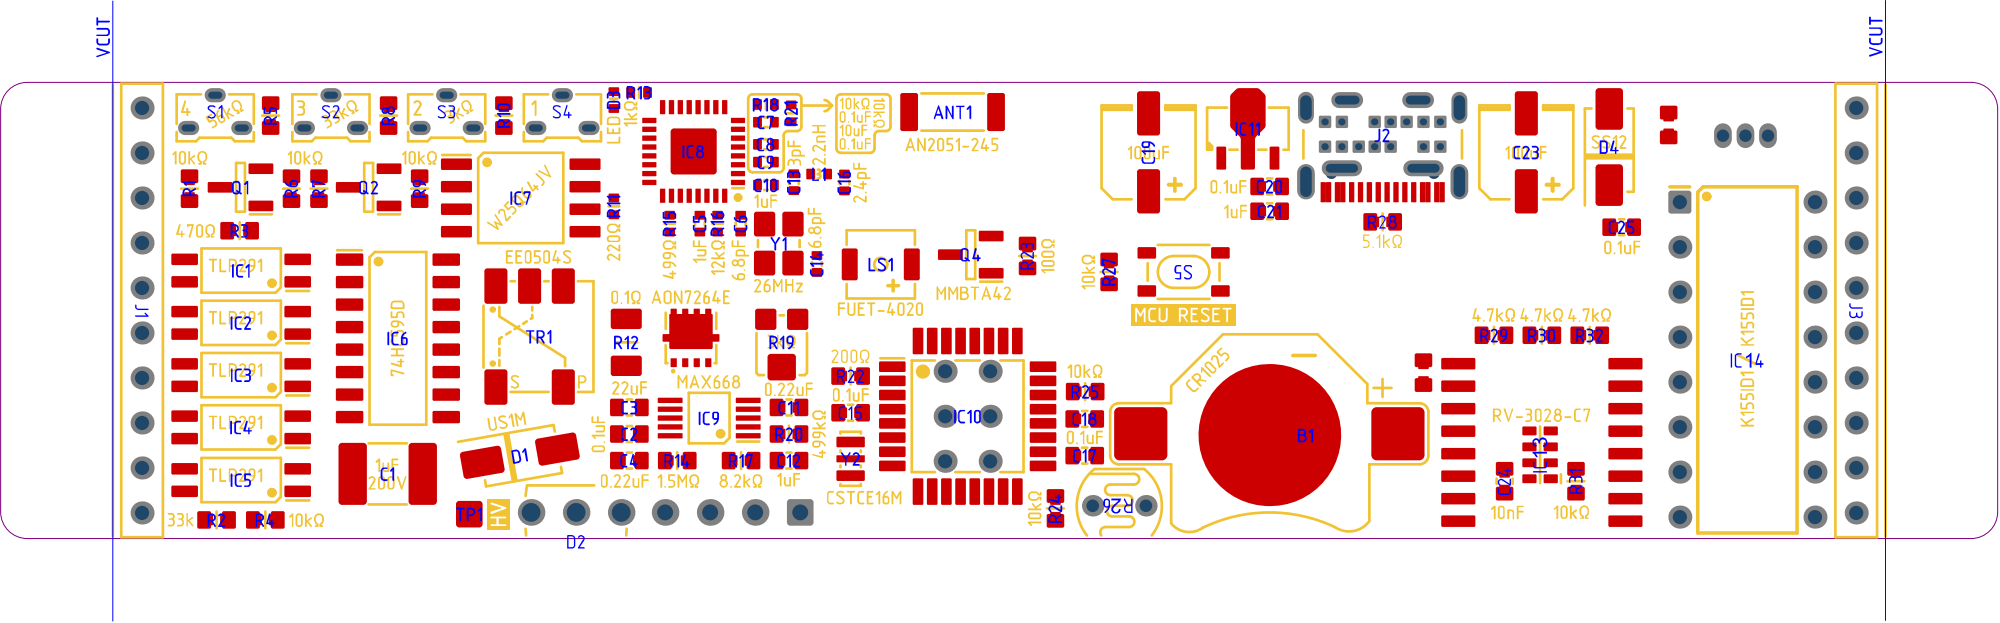
[picture p59: page 1]

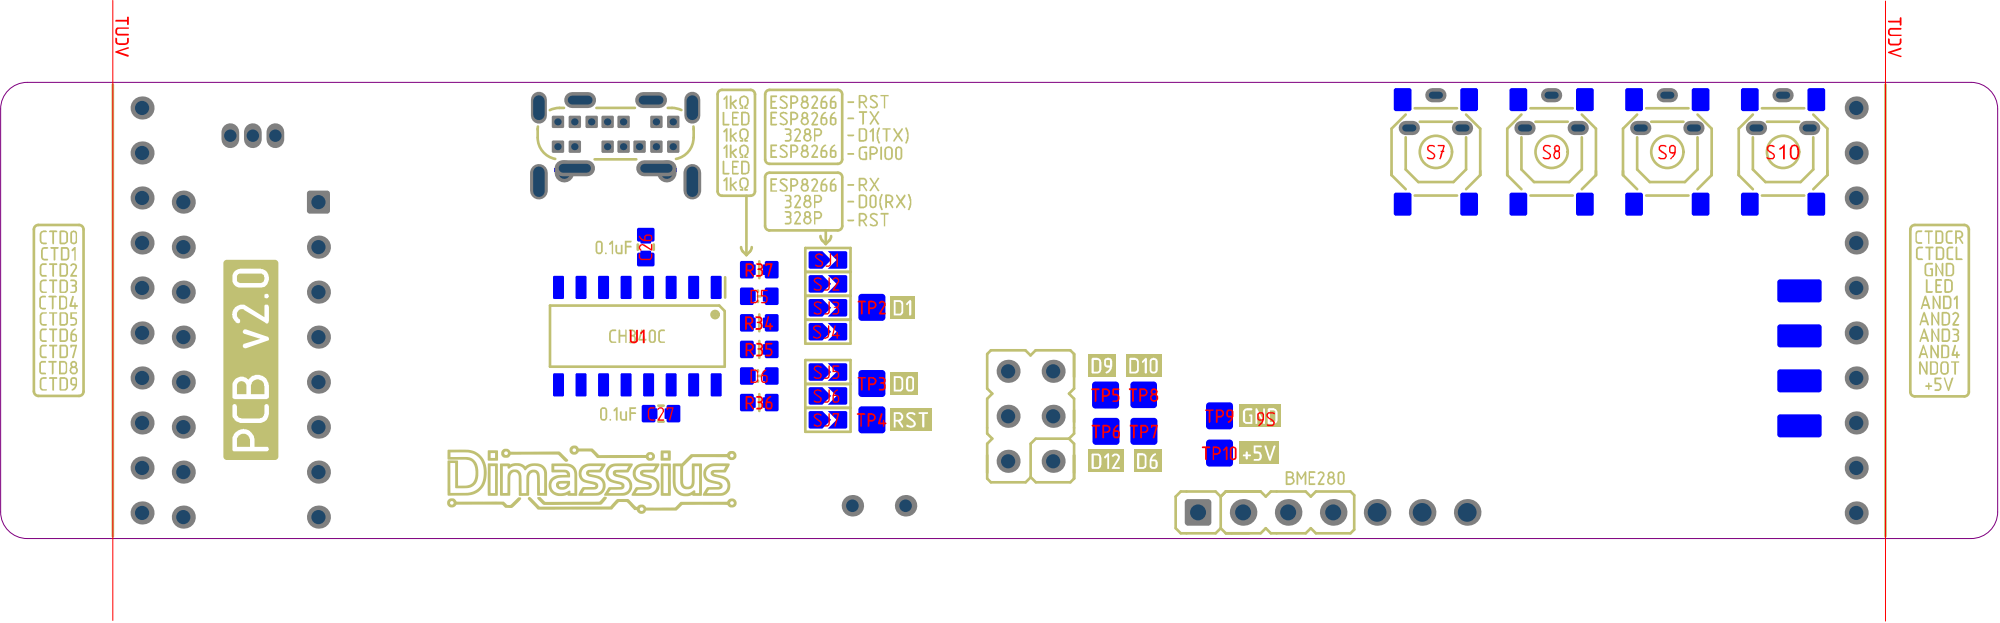
[picture p60: page 2]
