Dimasssius/DIY_Alliance_NixieClock_Userland/hardcore/assembly/hardcore-boards-x4-tubes/maximal-configuration/schematic-print/Schematic Prints.PDF

Данным резистором можно регулировать яркость свечения
индикаторов и разделительных точек, чем меньше сопротивление,
тем выше яркость (и выше ток, что влияет на срок жизни
индикаторов)


Neon Dots (NE-2, ИН-3, ИНС-1)



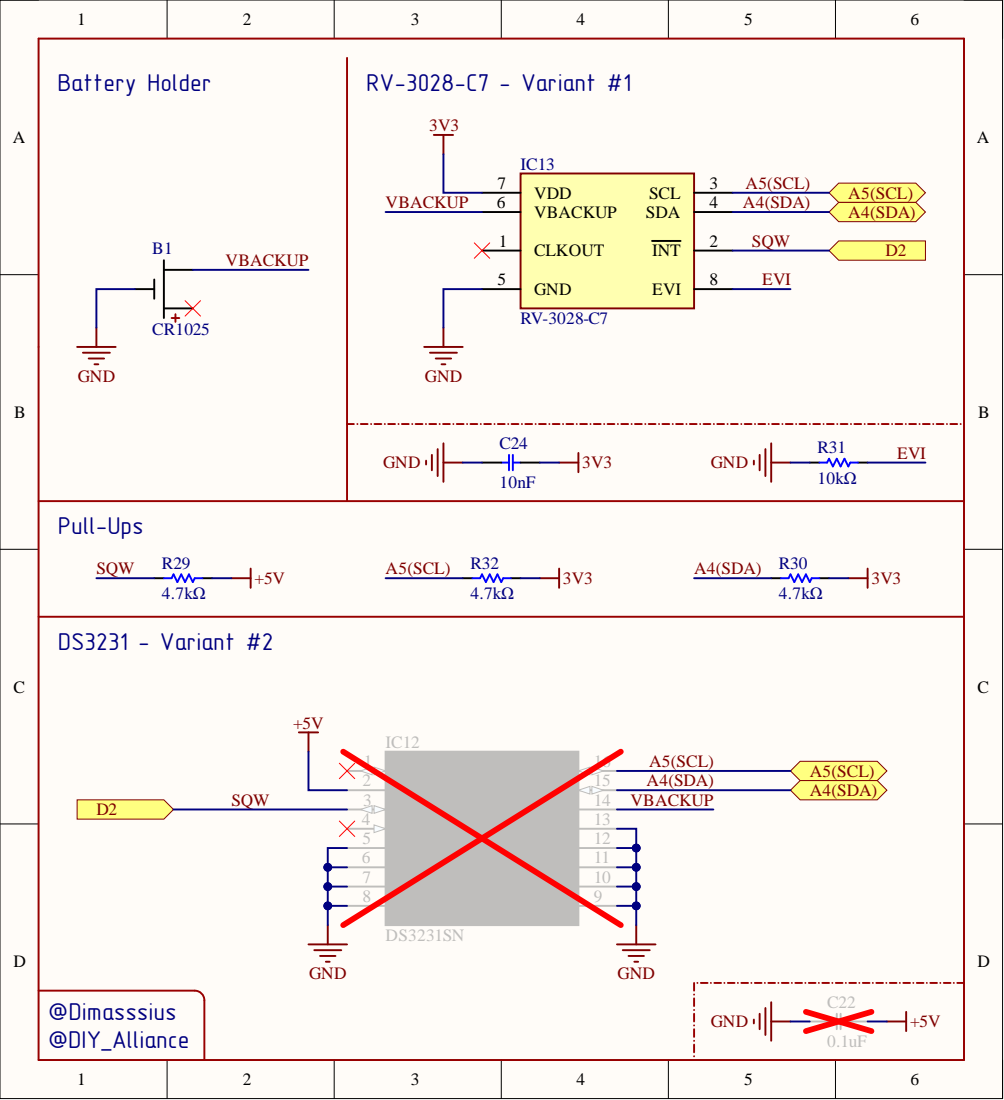
[picture p61: page 7]

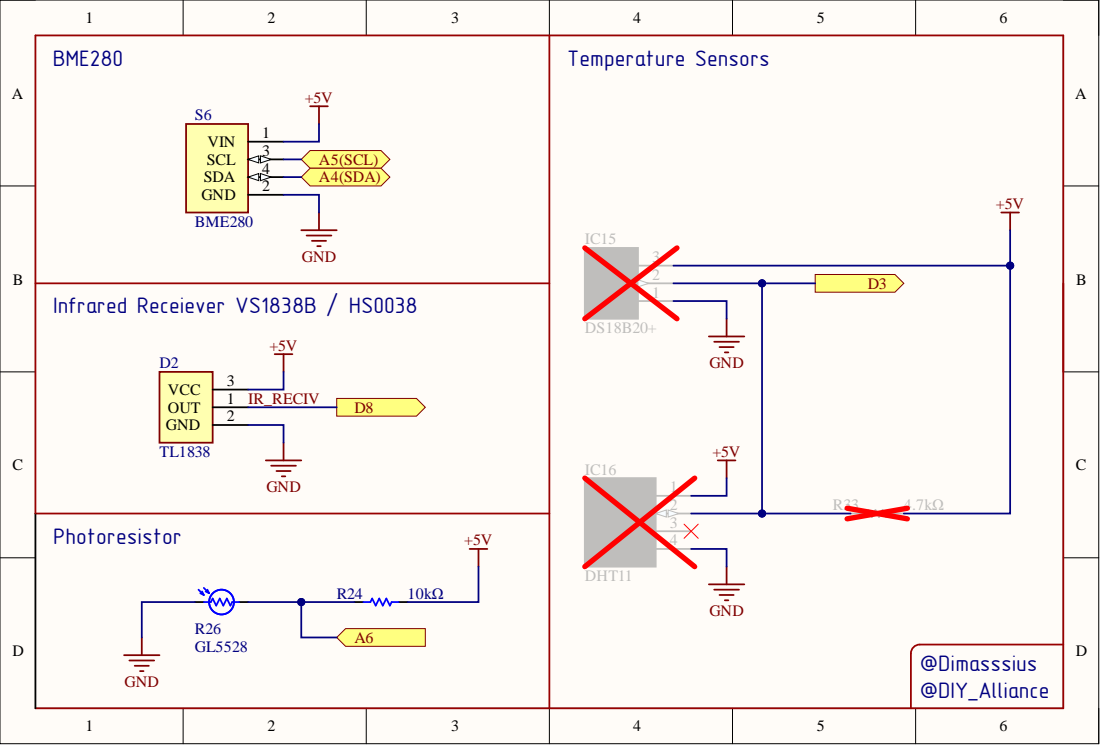
[picture p62: page 8]

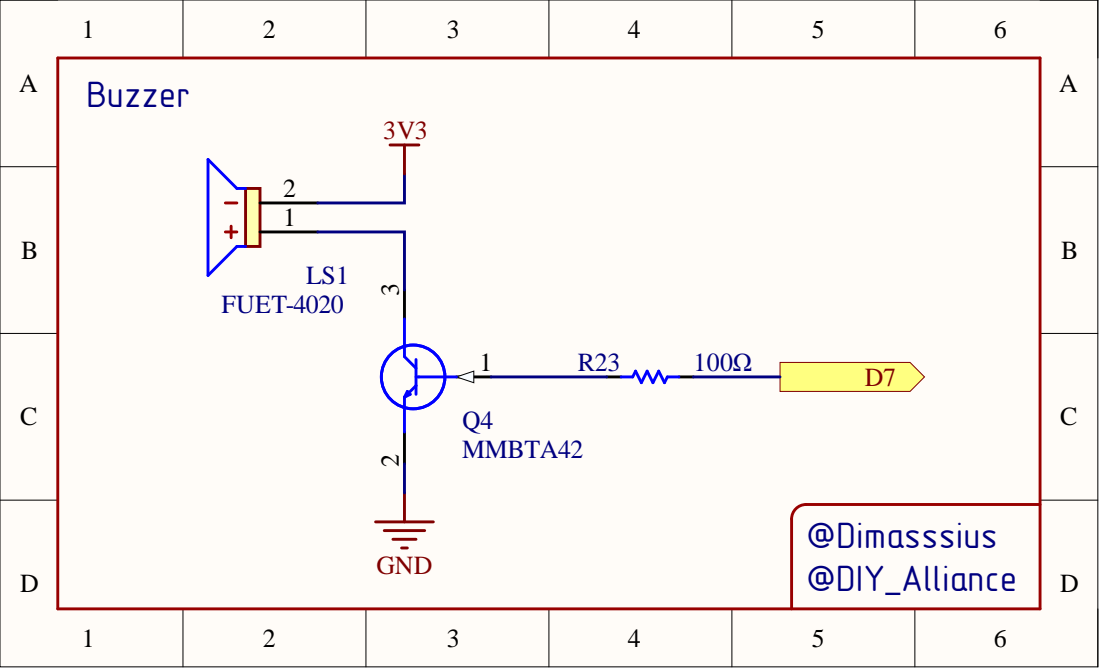
[picture p63: page 9]



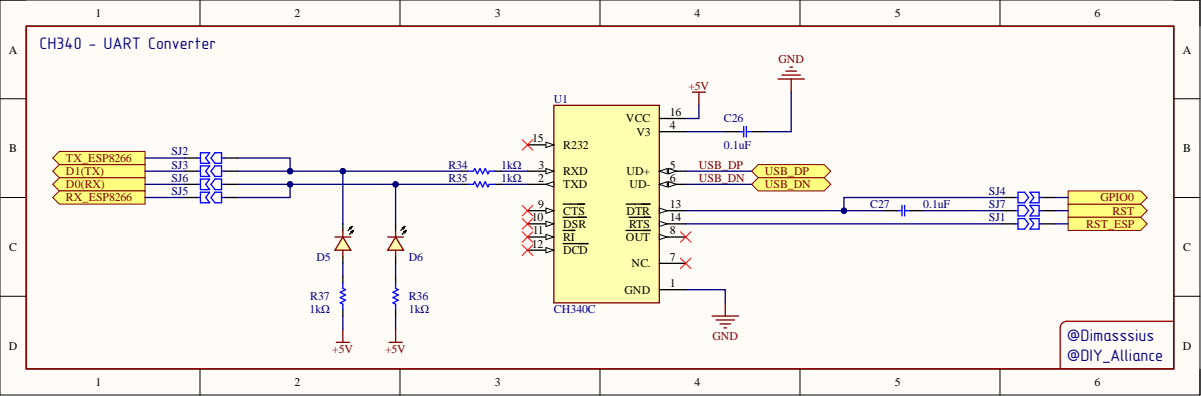
[picture p64: page 12]
