Dimasssius/DIY_Alliance_NixieClock_Userland/hardcore/assembly/hardcore-boards-x4-tubes/minimal-configuration/pcb-print/Assembly Drawings.PDF

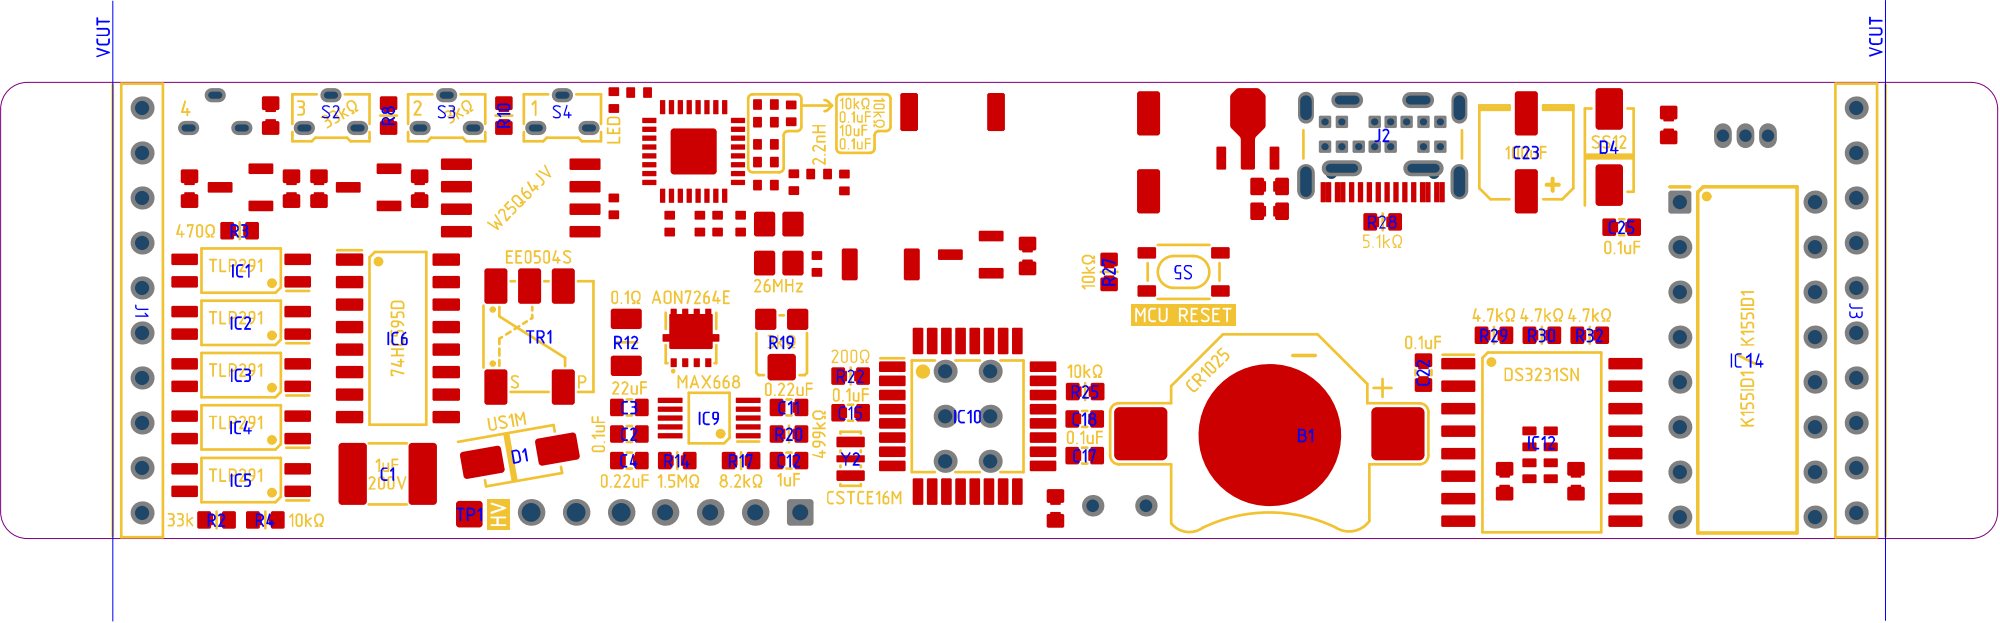
[picture p65: page 1]

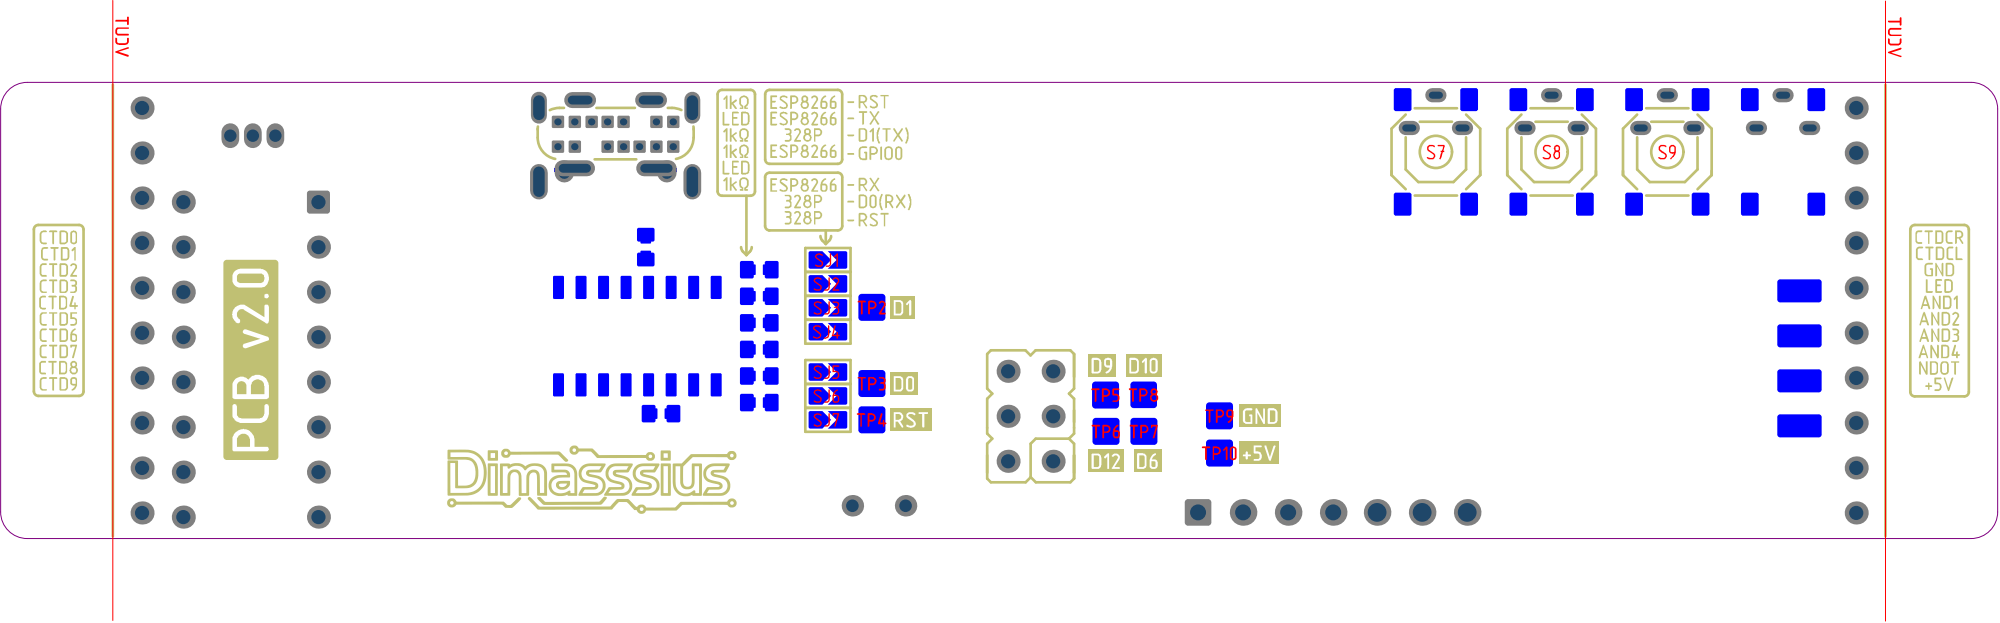
[picture p66: page 2]
