Dimasssius/DIY_Alliance_NixieClock_Userland/hardcore/assembly/hardcore-boards-x4-tubes/minimal-configuration/schematic-print/Schematic Prints.PDF

Данным резистором можно регулировать яркость свечения
индикаторов и разделительных точек, чем меньше сопротивление,
тем выше яркость (и выше ток, что влияет на срок жизни
индикаторов)

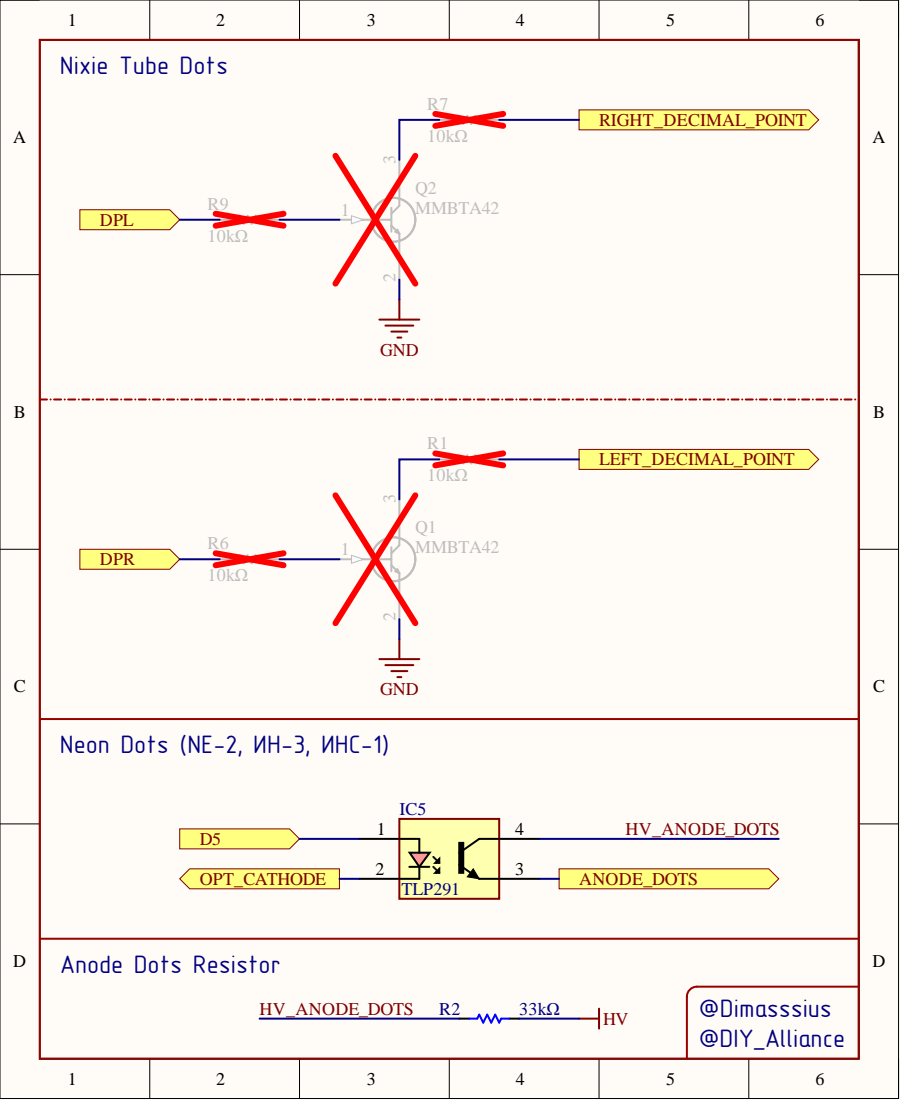
[picture p67: page 4]

Neon Dots (NE-2, ИН-3, ИНС-1)


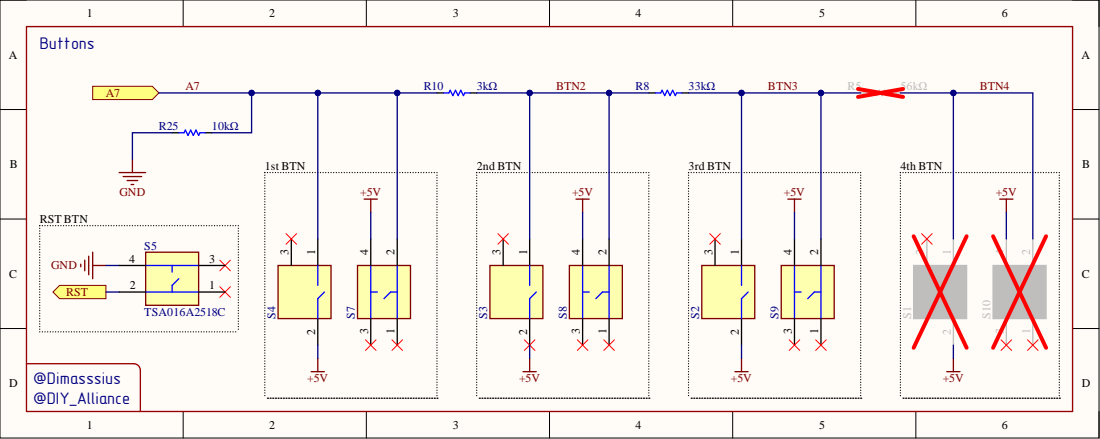
[picture p68: page 6]




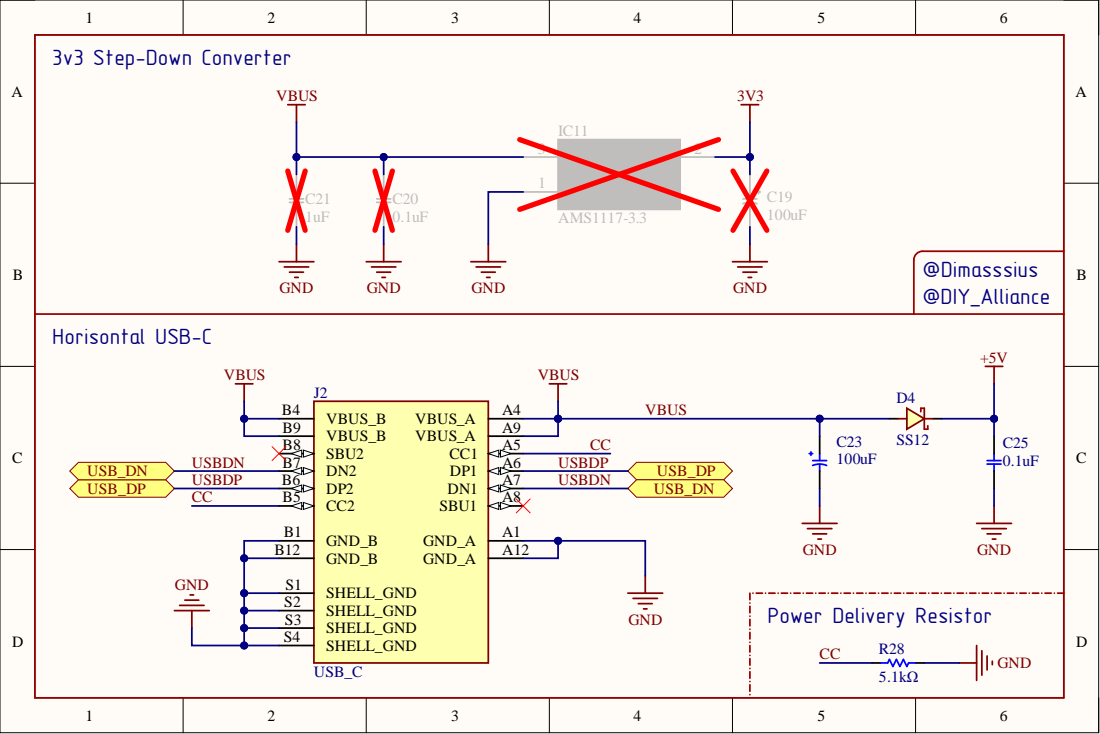
[picture p69: page 10]

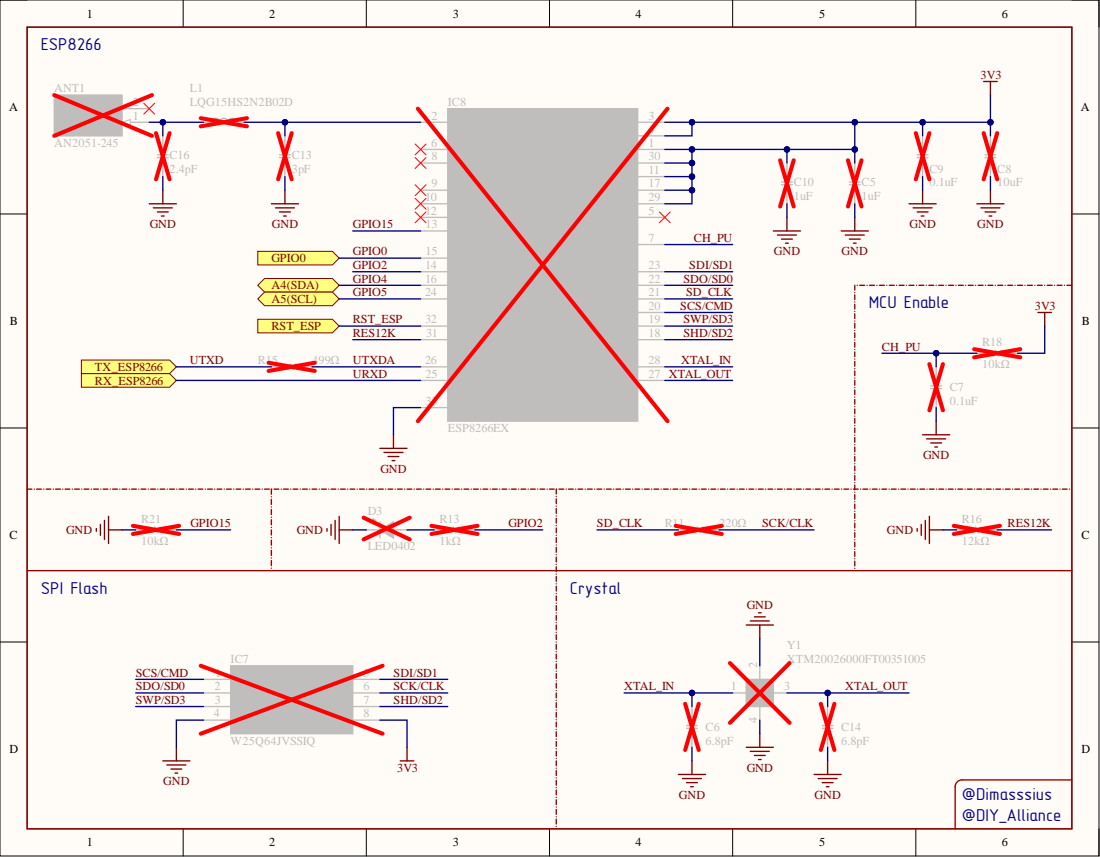
[picture p70: page 11]
