Dimasssius/DIY_Alliance_NixieClock_Userland/hardcore/assembly/hardcore-boards-x6-tubes/base-configuration/pcb-print/Assembly Drawings.PDF

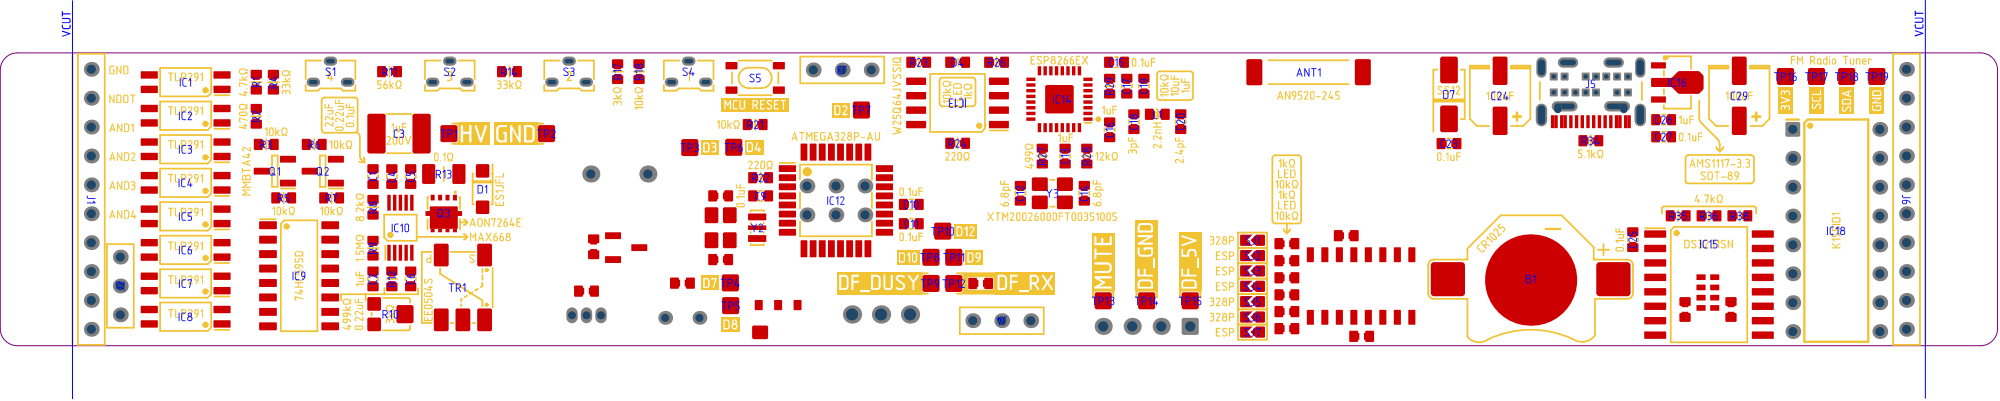
[picture p71: page 1]

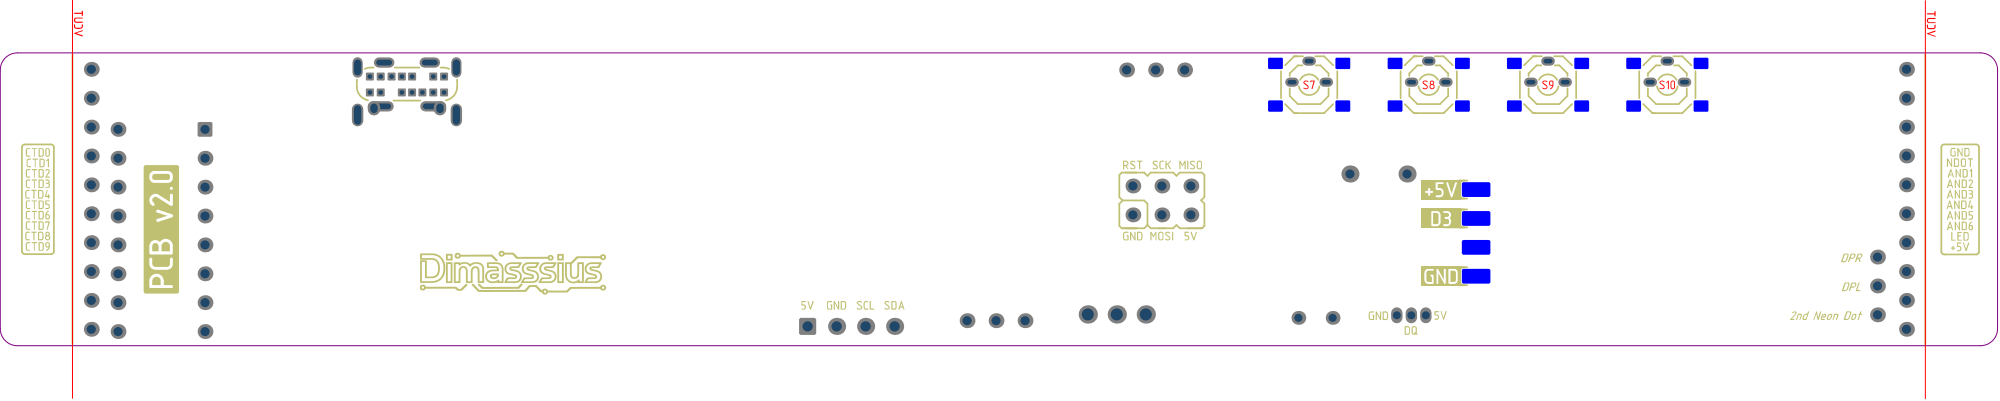
[picture p72: page 2]
