Dimasssius/DIY_Alliance_NixieClock_Userland/hardcore/assembly/hardcore-boards-x6-tubes/base-configuration/schematic-print/Schematic Prints.PDF

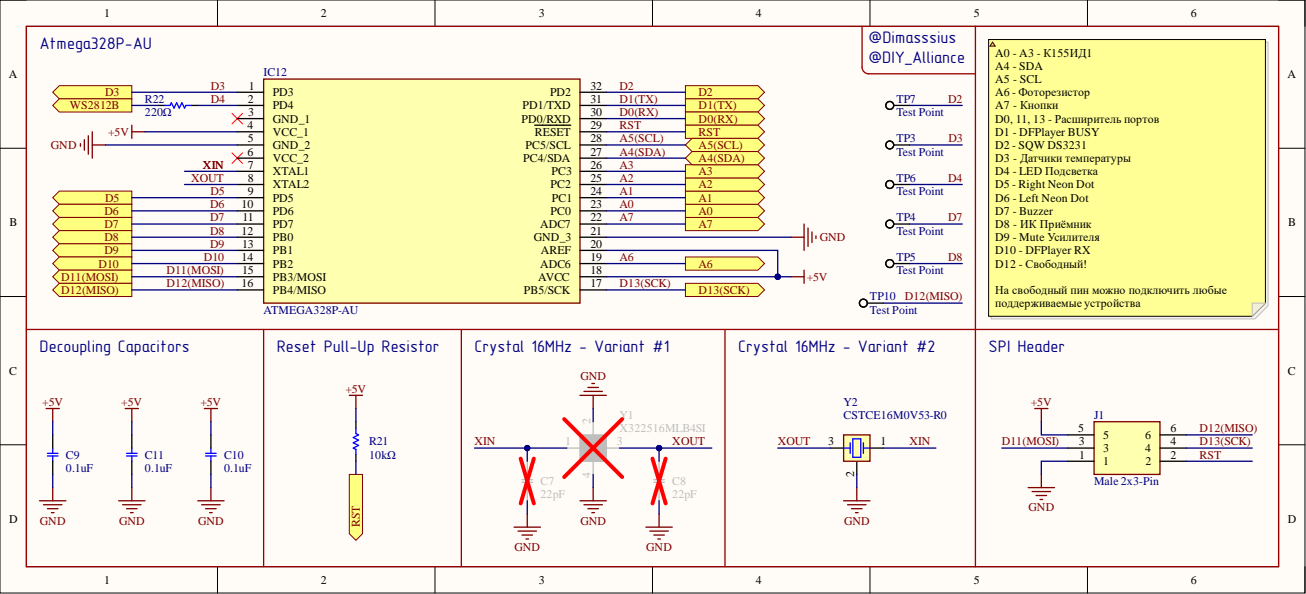
[picture p73: page 1]

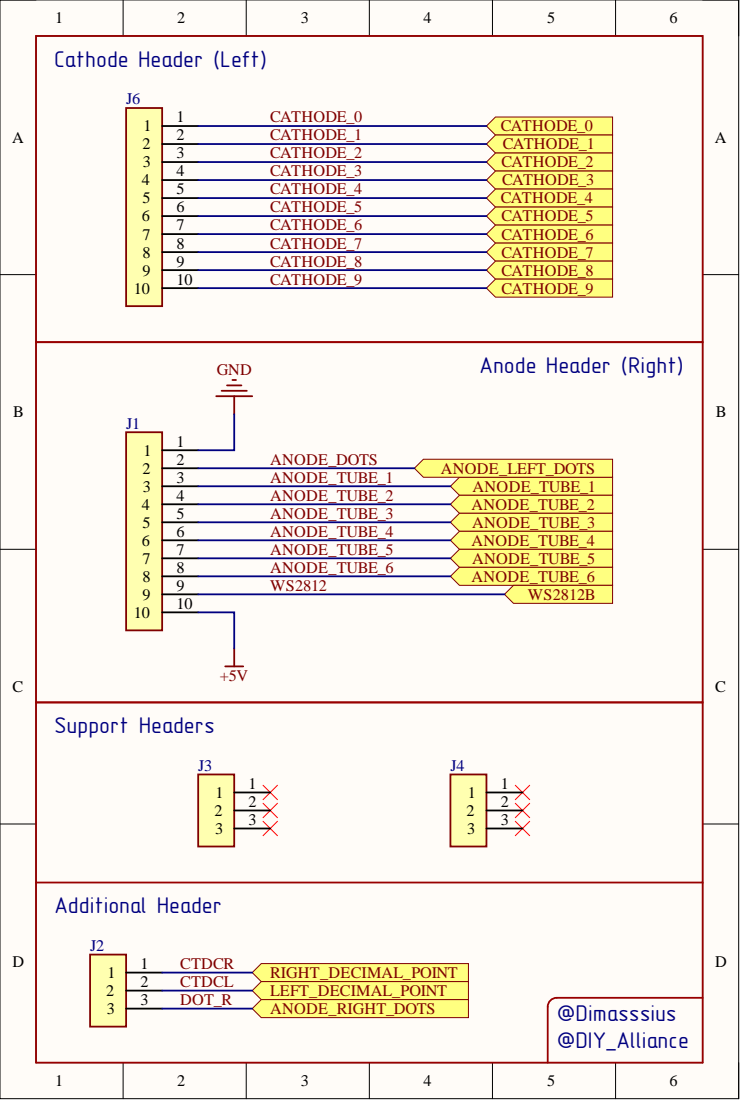
[picture p74: page 2]

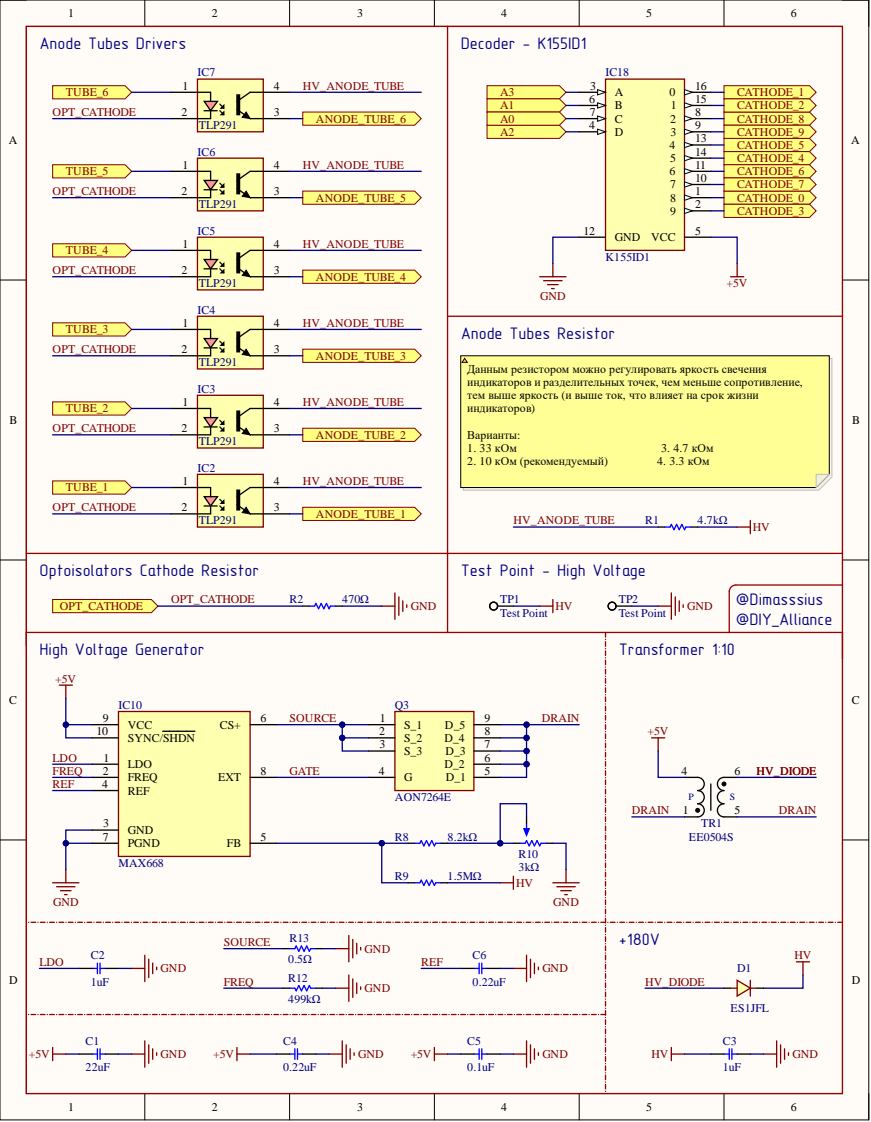
[picture p75: page 3]

Данным резистором можно регулировать яркость свечения
индикаторов и разделительных точек, чем меньше сопротивление,
тем выше яркость (и выше ток, что влияет на срок жизни
индикаторов)

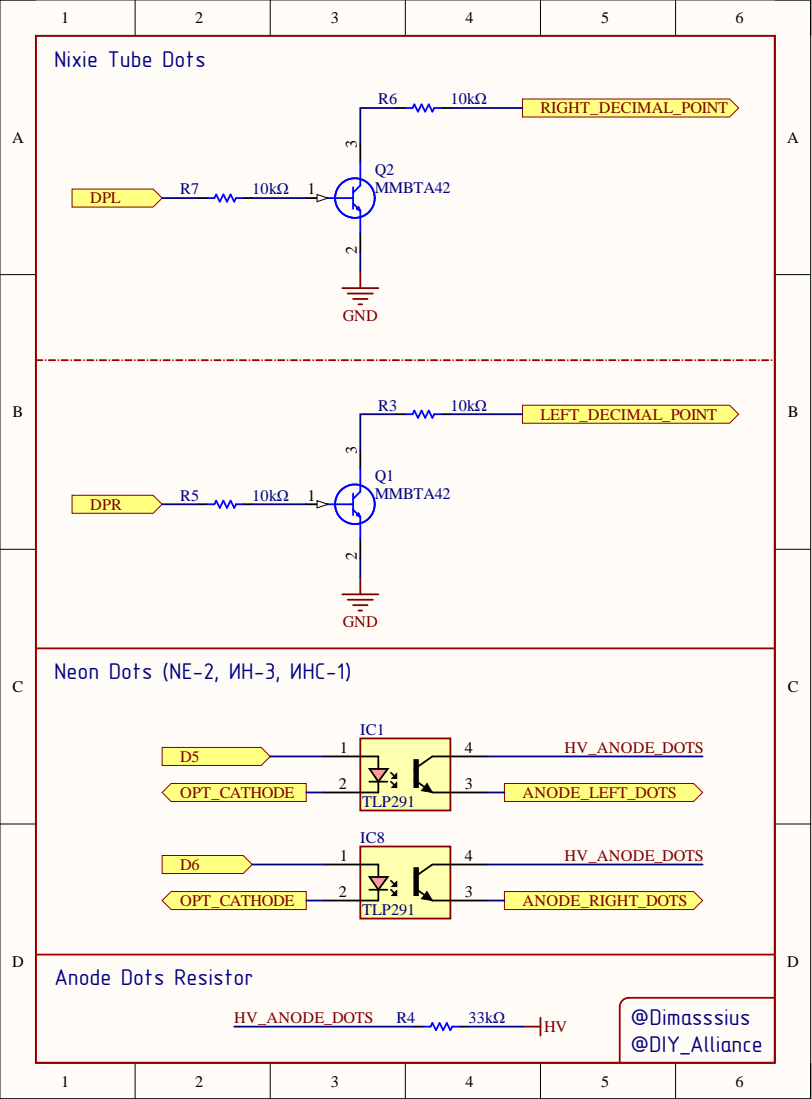
[picture p76: page 4]

Neon Dots (NE-2, ИН-3, ИНС-1)

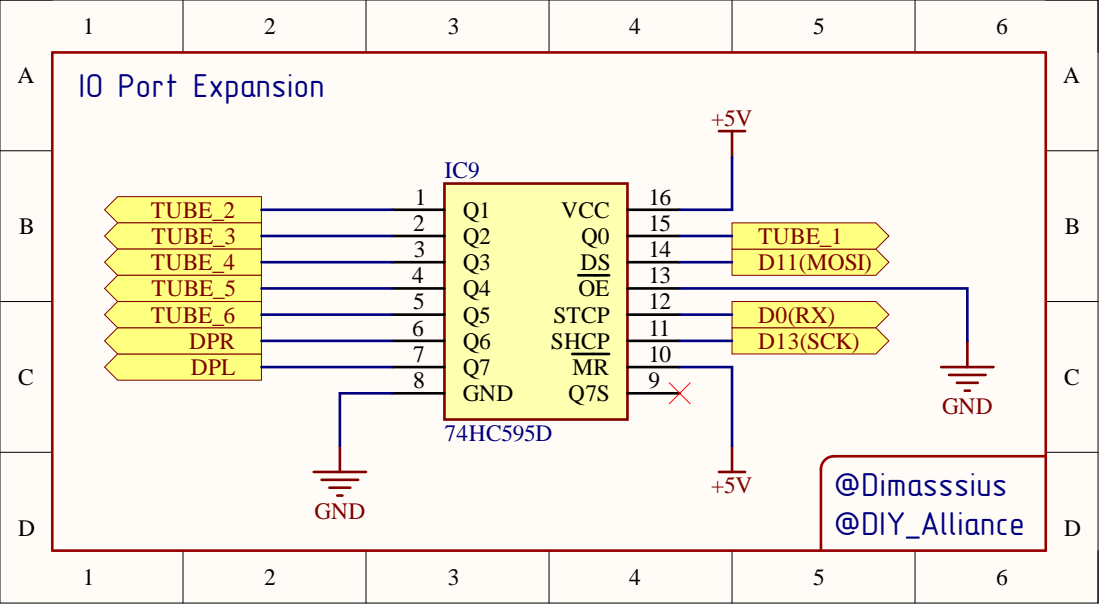
[picture p77: page 5]

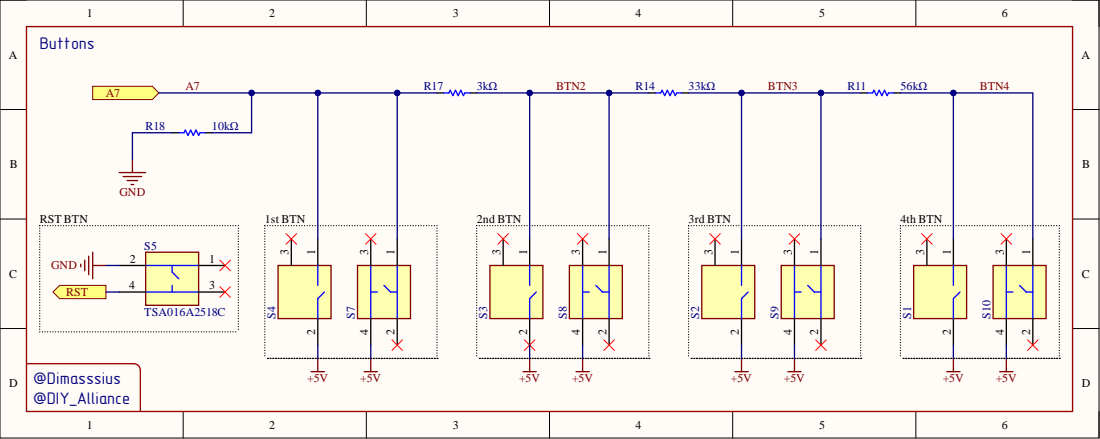
[picture p78: page 6]

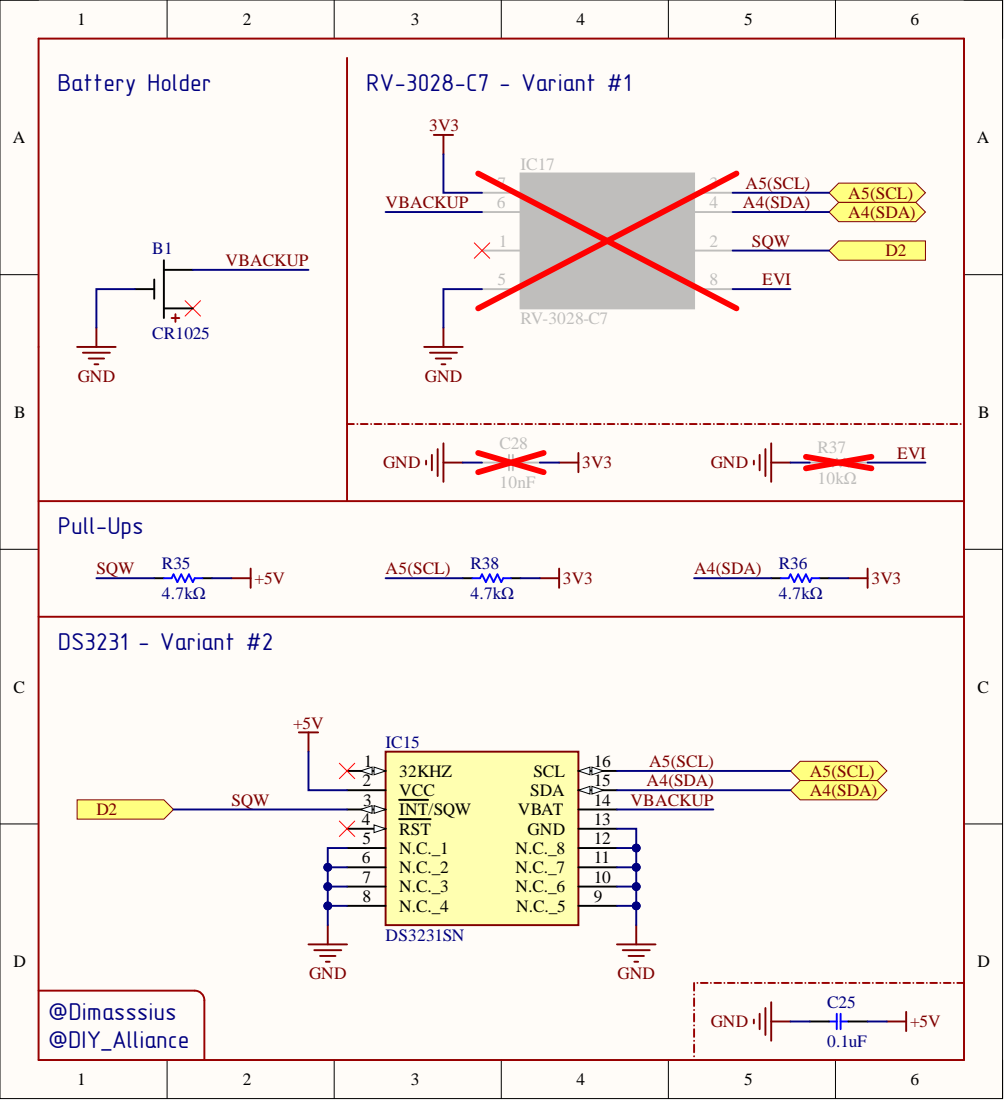
[picture p79: page 7]

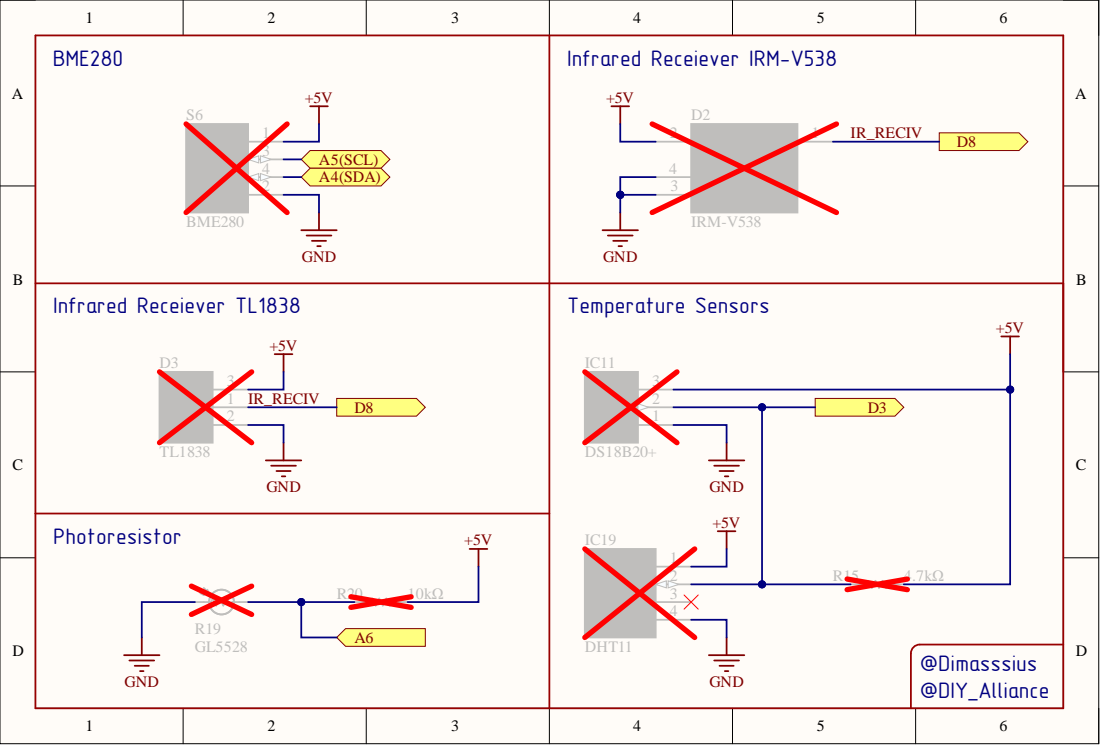
[picture p80: page 8]

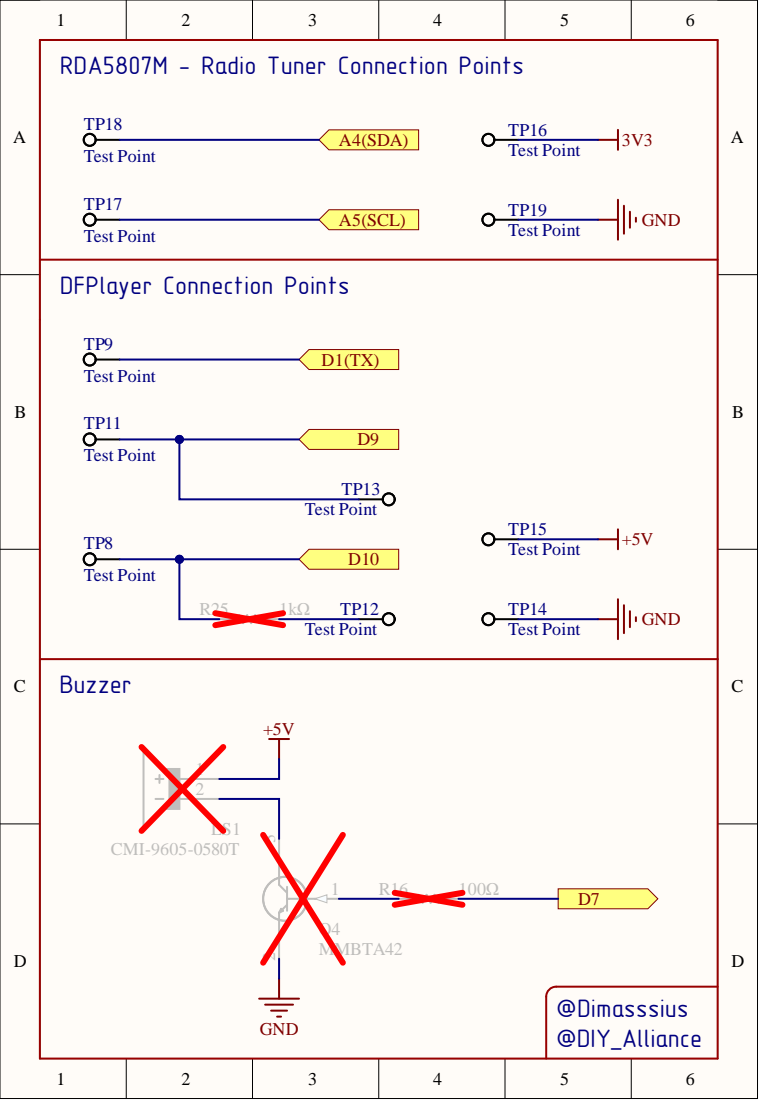
[picture p81: page 9]

RDA5807M - Radio Tuner Connection Points

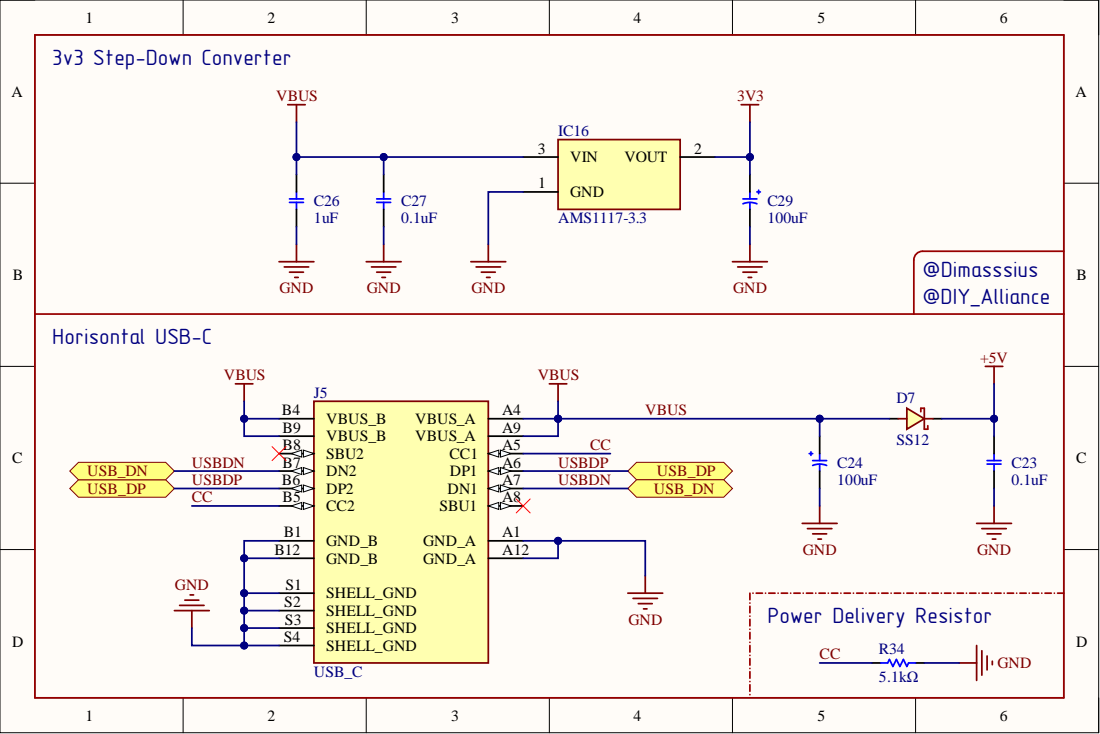
[picture p82: page 10]

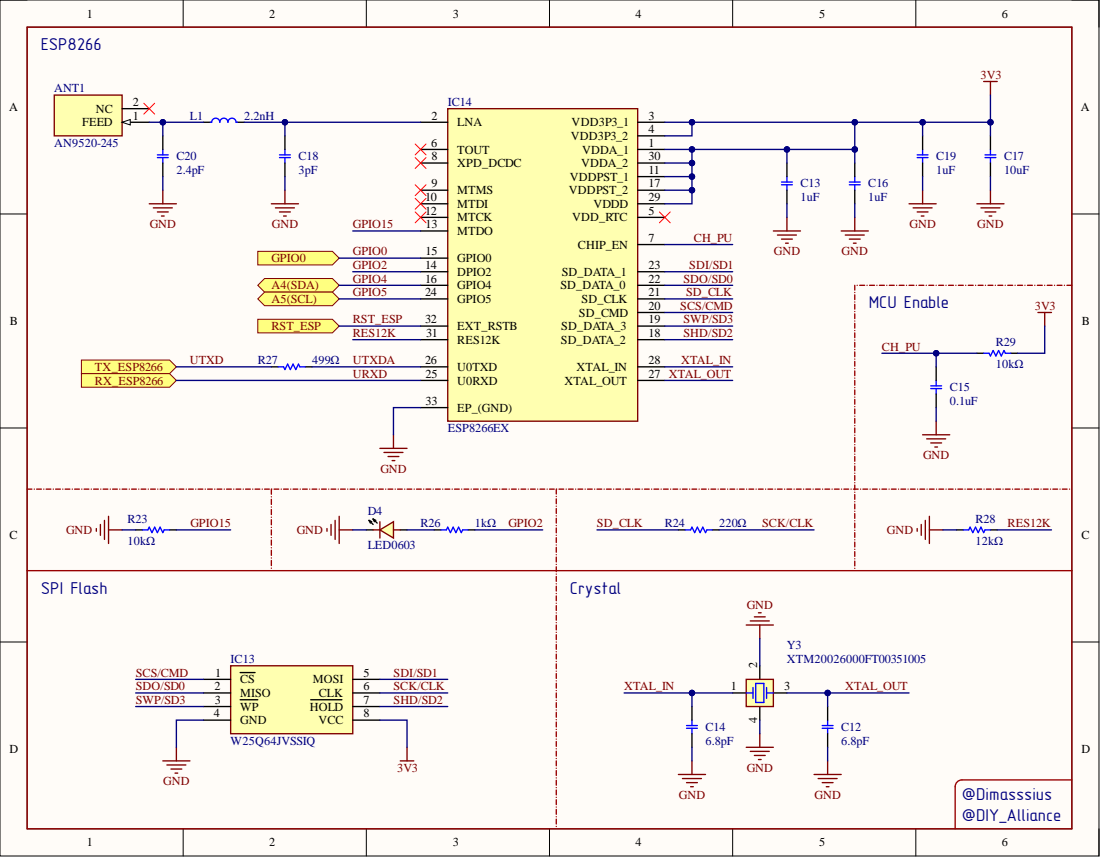
[picture p83: page 11]

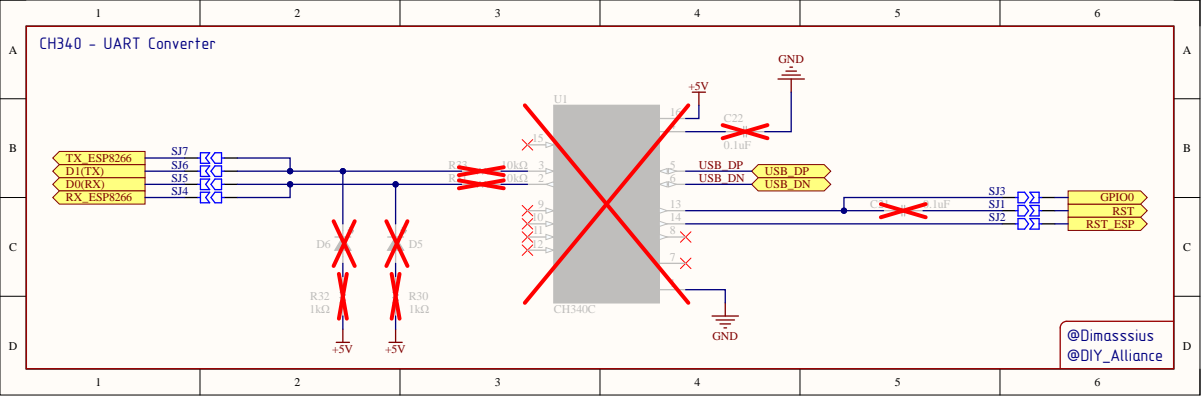
[picture p84: page 12]
