Dimasssius/DIY_Alliance_NixieClock_Userland/hardcore/assembly/hardcore-boards-x6-tubes/maximal-configuration/pcb-print/Assembly Drawings.PDF

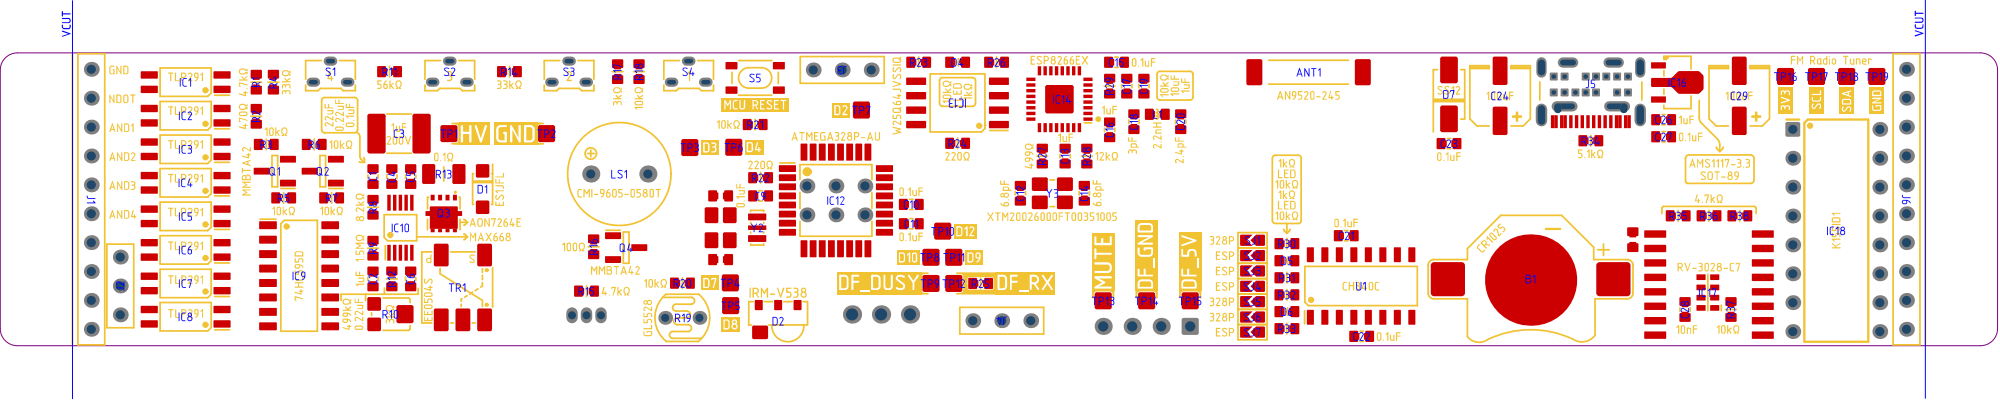
[picture p85: page 1]

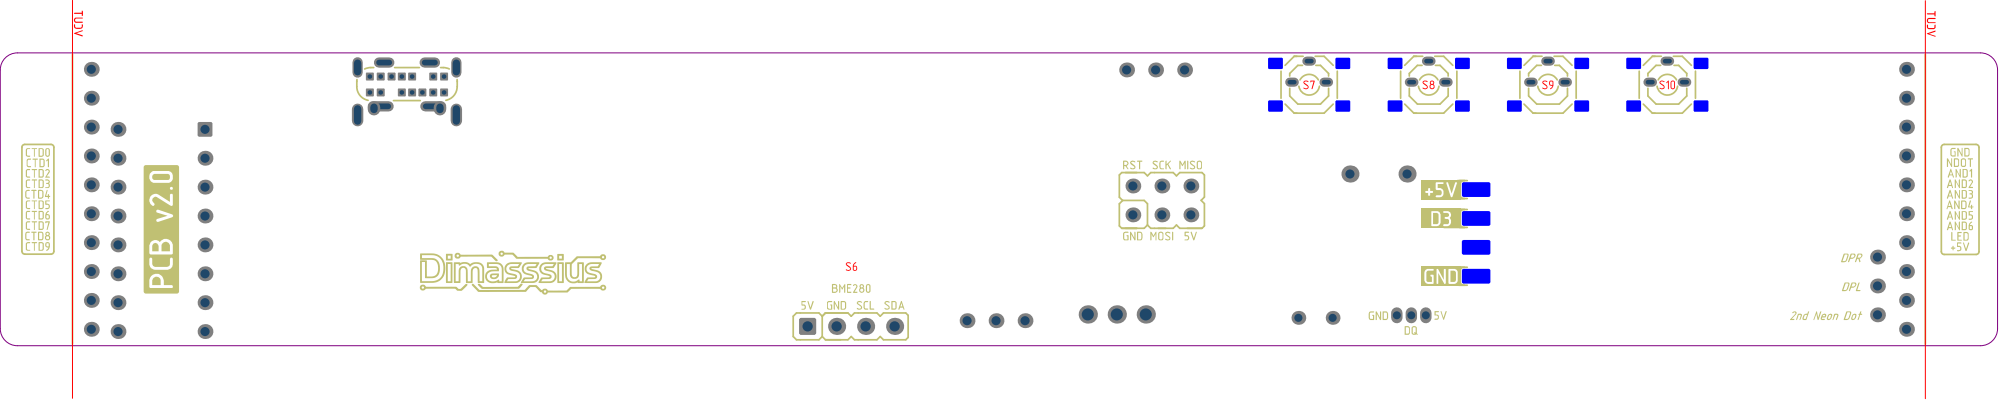
[picture p86: page 2]
