Dimasssius/DIY_Alliance_NixieClock_Userland/hardcore/assembly/hardcore-boards-x6-tubes/maximal-configuration/schematic-print/Schematic Prints.PDF

Данным резистором можно регулировать яркость свечения
индикаторов и разделительных точек, чем меньше сопротивление,
тем выше яркость (и выше ток, что влияет на срок жизни
индикаторов)


Neon Dots (NE-2, ИН-3, ИНС-1)



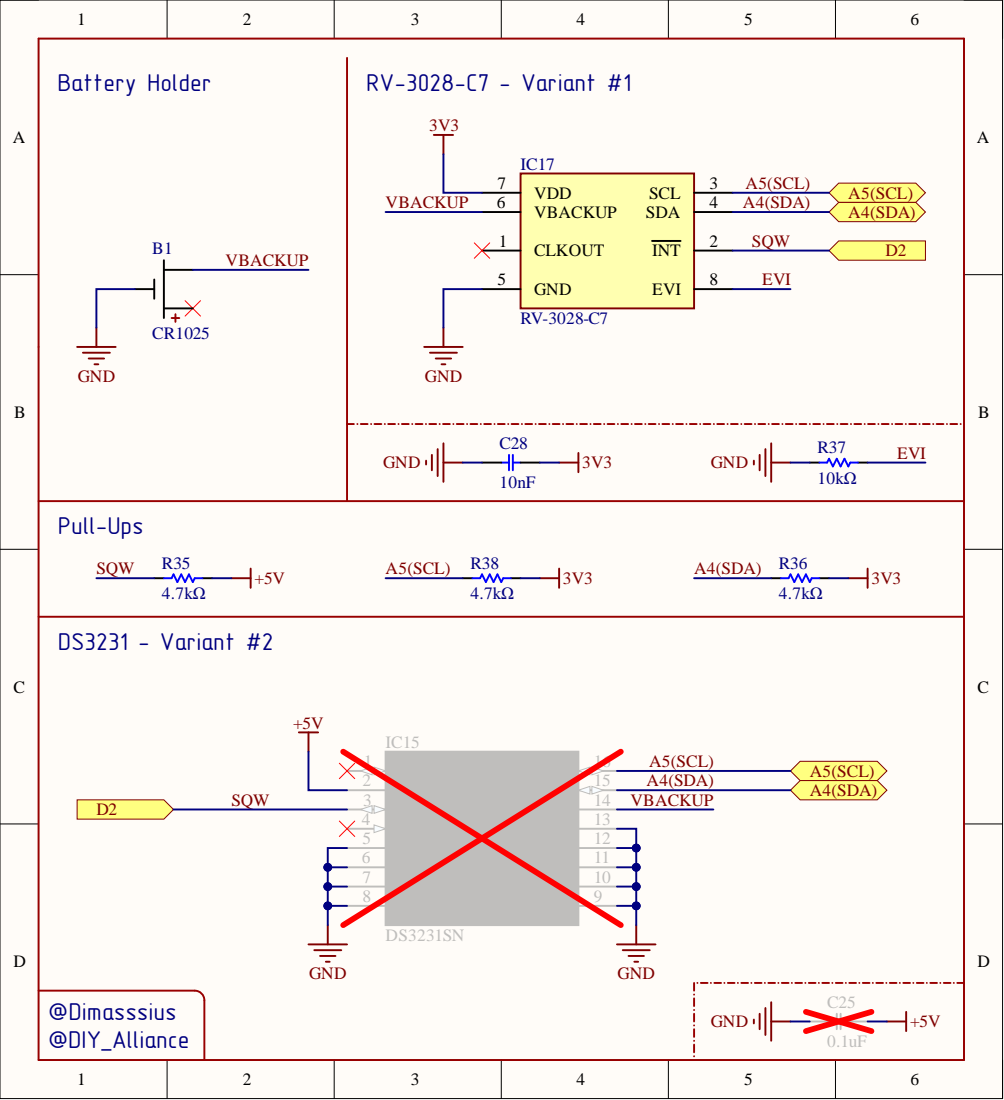
[picture p87: page 7]

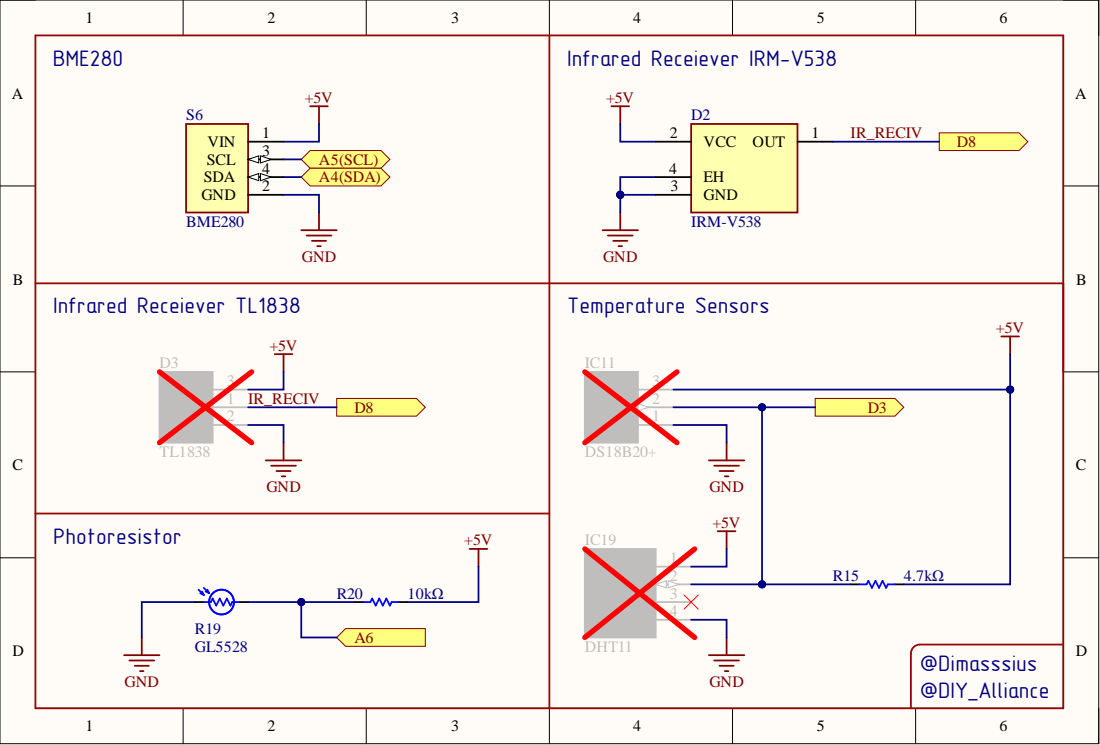
[picture p88: page 8]

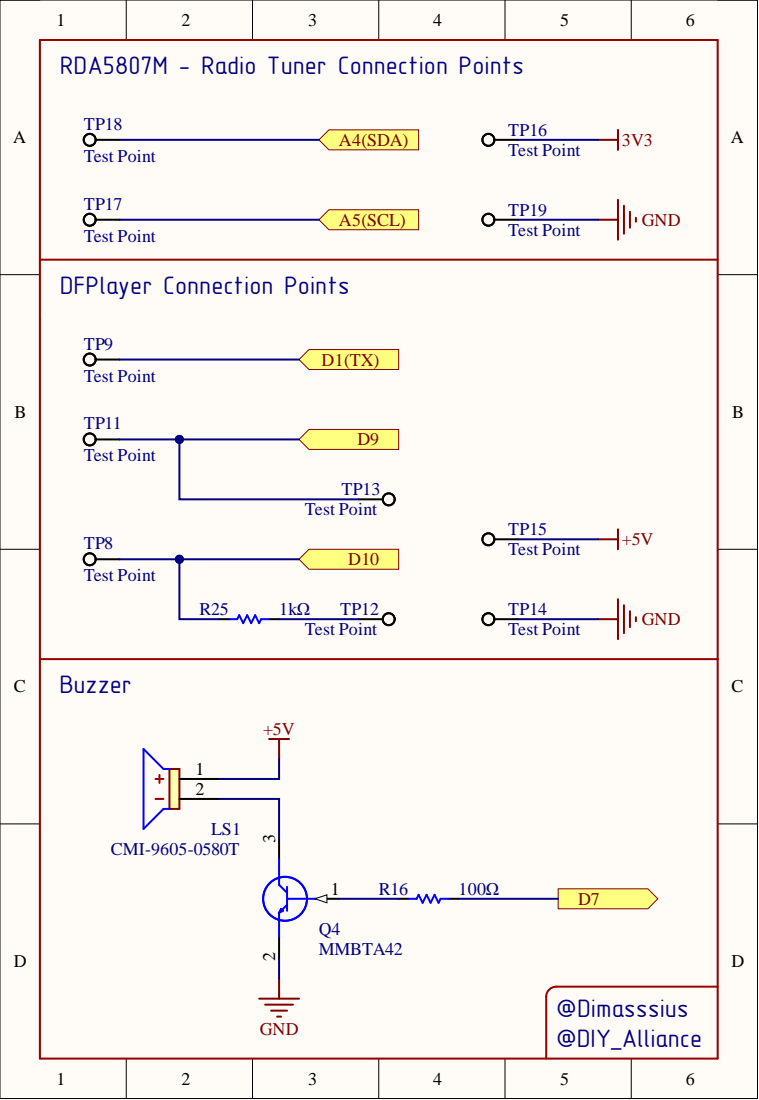
[picture p89: page 9]

RDA5807M - Radio Tuner Connection Points



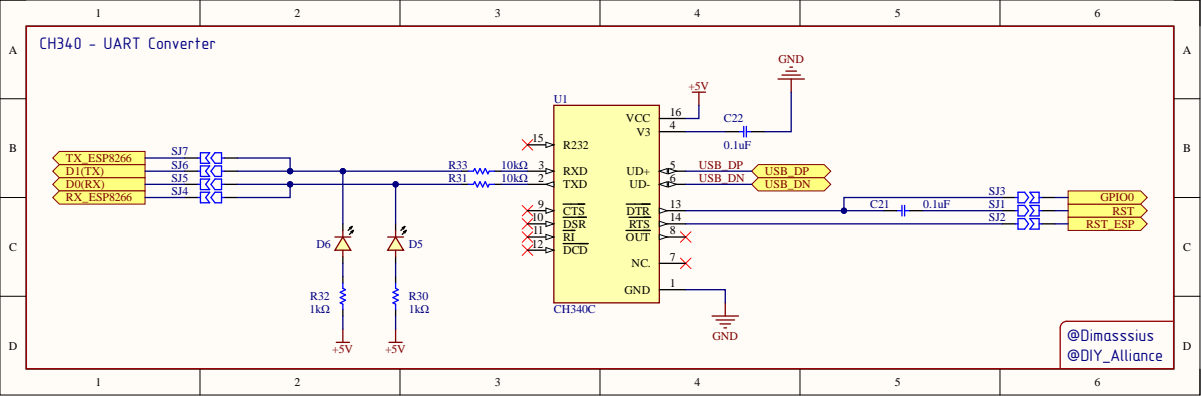
[picture p90: page 12]
