Dimasssius/DIY_Alliance_NixieClock_Userland/hardcore/assembly/hardcore-boards-x6-tubes/minimal-configuration/pcb-print/Assembly Drawings.PDF

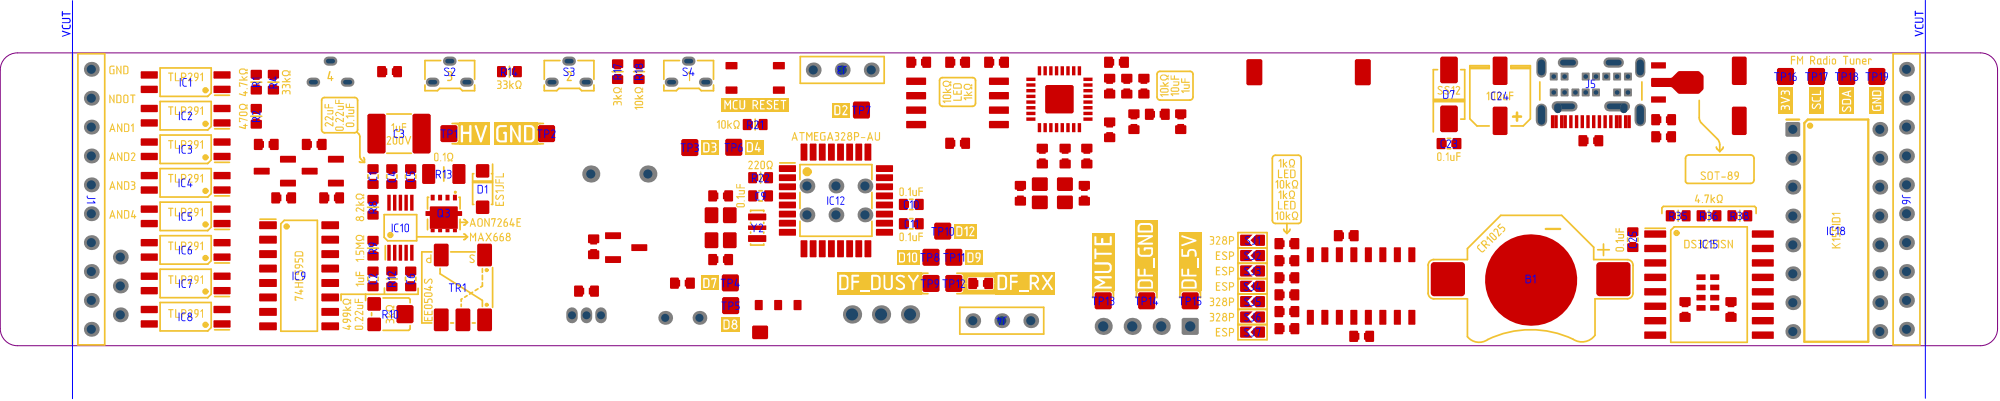
[picture p91: page 1]

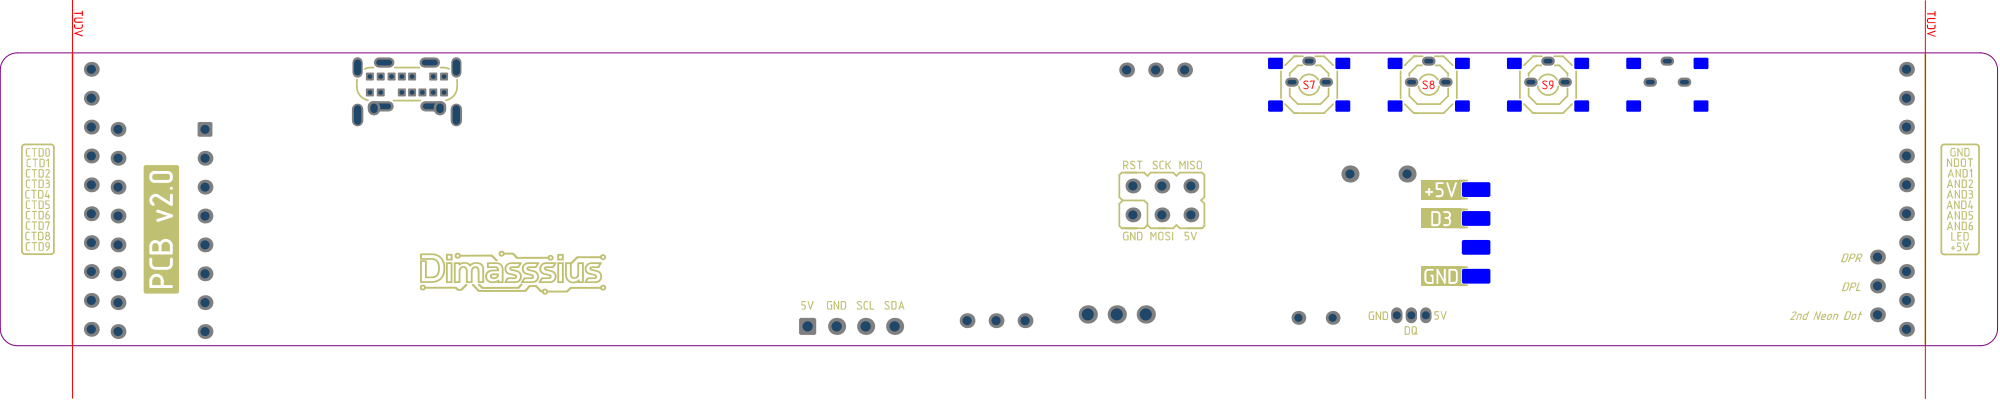
[picture p92: page 2]
