Dimasssius/DIY_Alliance_NixieClock_Userland/hardcore/assembly/hardcore-boards-x6-tubes/minimal-configuration/schematic-print/Schematic Prints.PDF

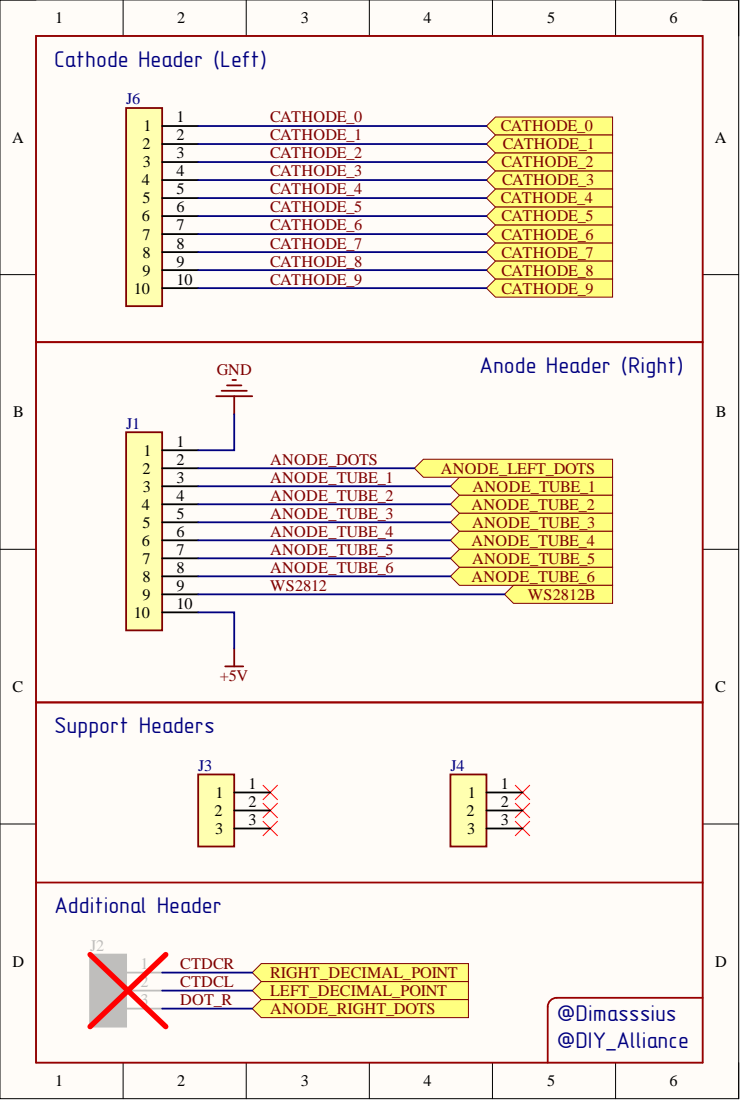
[picture p93: page 2]


Данным резистором можно регулировать яркость свечения
индикаторов и разделительных точек, чем меньше сопротивление,
тем выше яркость (и выше ток, что влияет на срок жизни
индикаторов)

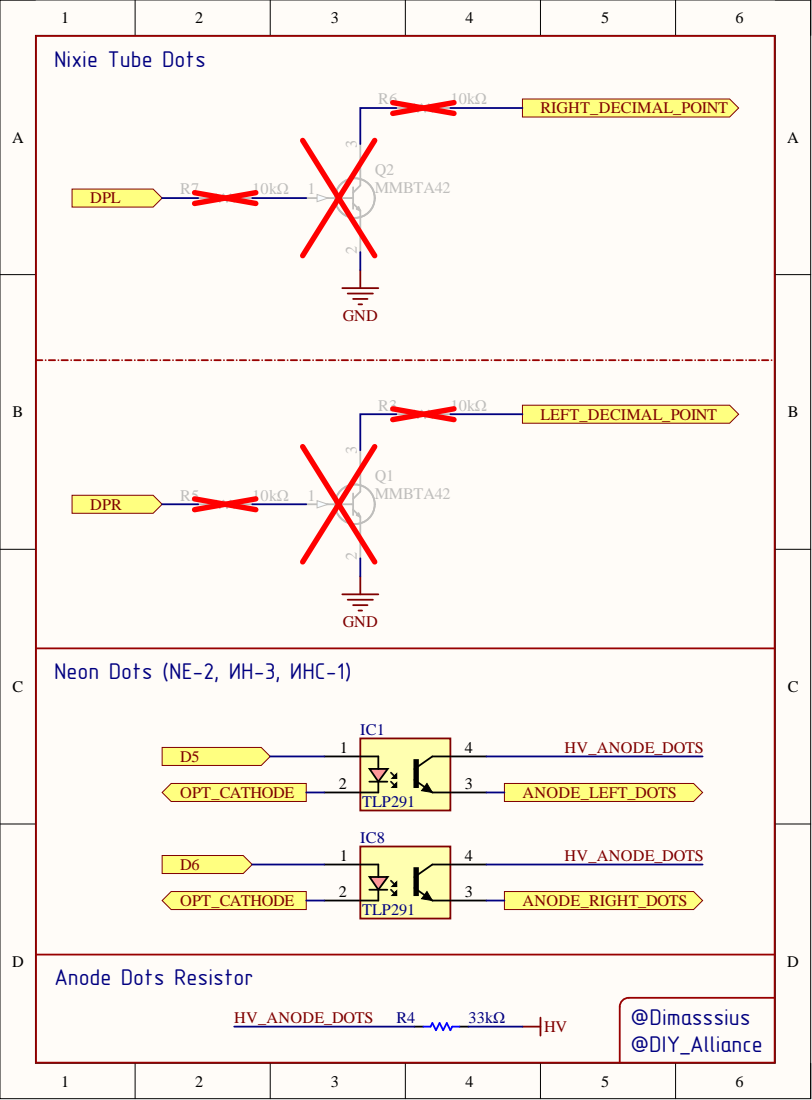
[picture p94: page 4]

Neon Dots (NE-2, ИН-3, ИНС-1)


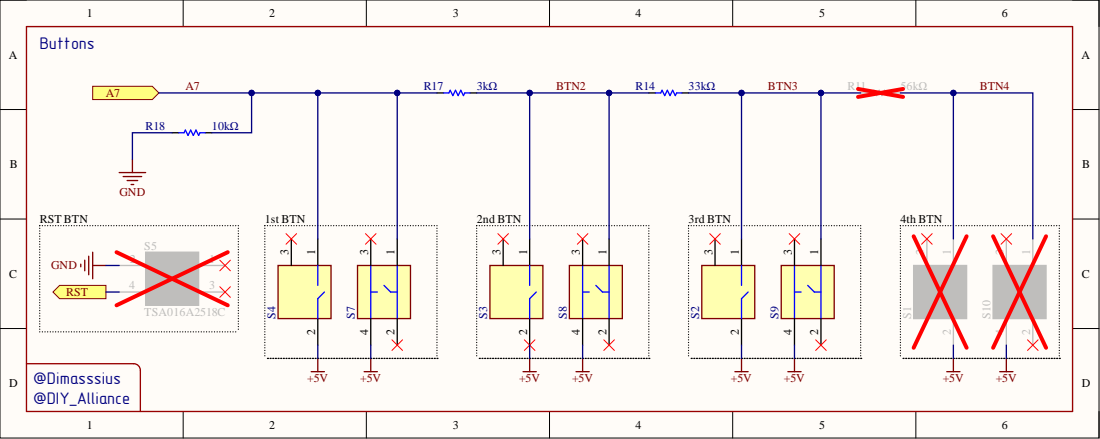
[picture p95: page 6]




RDA5807M - Radio Tuner Connection Points

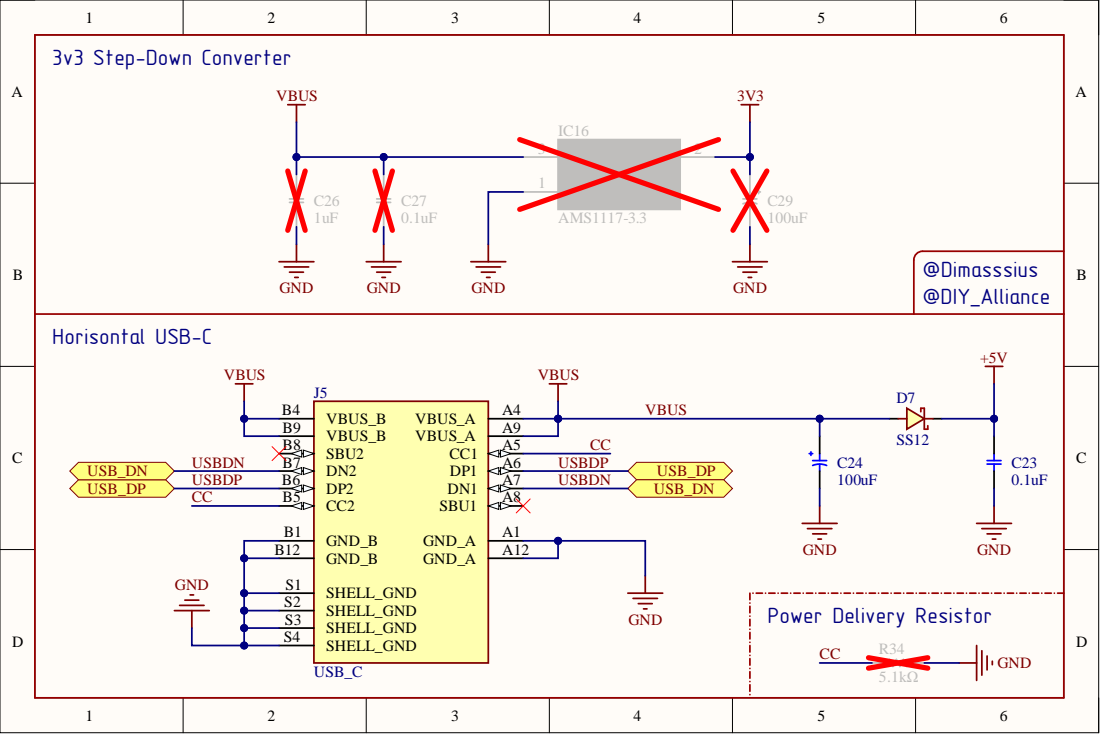
[picture p96: page 10]

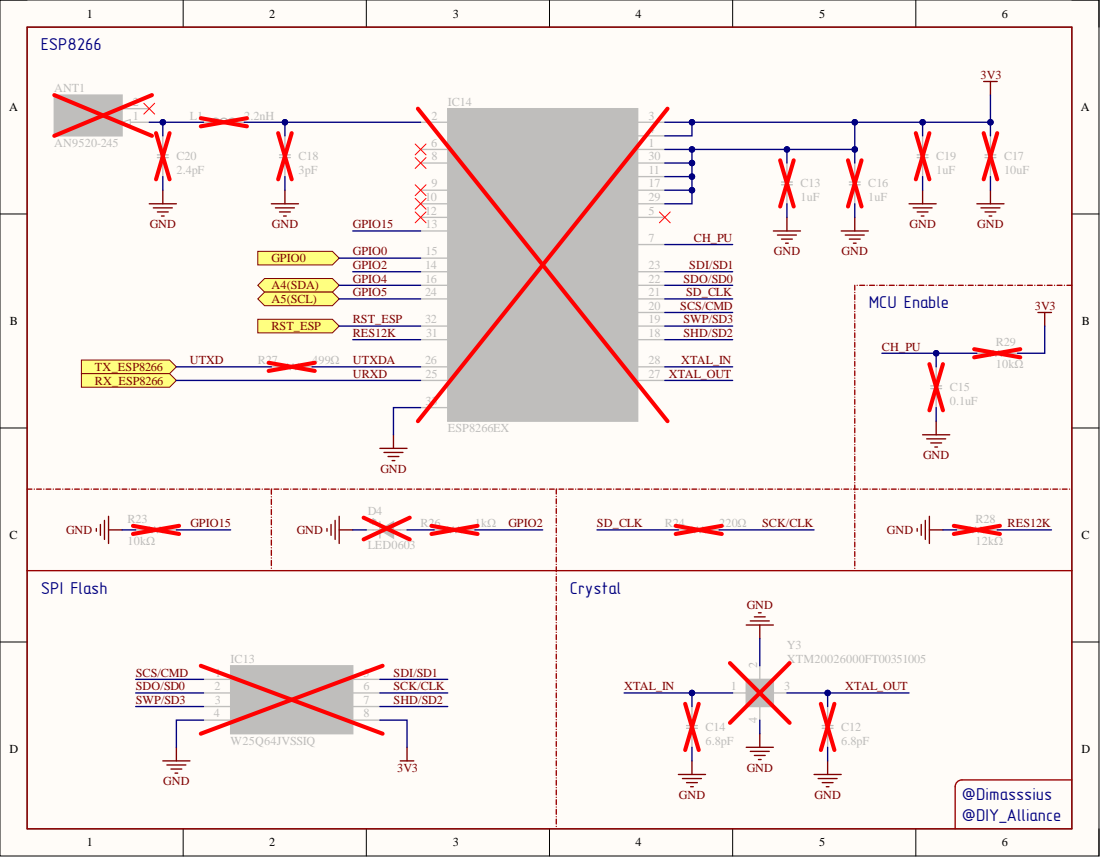
[picture p97: page 11]
