Dimasssius/DIY_Alliance_NixieClock_Userland/(commit log)

2026-06-03 Add hardcore BOM datasheets and folder docs
    [Bill Of Materials - Excell.xlsx]
2026-06-03 Добавить комплектации Hardcore и уточнить лицензию
2026-06-03 Добавлены комплектации для плат Hardcore
2026-06-03 Разделены сборочные материалы Hardcore на версии x4 и x6 SMD
    [Bill Of Materials - Excell.xlsx, Pick And Place (PnP) Files.csv]
2026-06-04 Обновлены сборочные материалы Standard и Hardcore
    [3D Модель - PARASOLID (Поверхностный монтаж, Вертикальные индикаторы).x_t, 3D Модель - PARASOLID (Поверхностный монтаж, Горизонтальные индикаторы).x_t, 3D Модель - STEP (Поверхностный монтаж, Вертикальные индикаторы).step, 3D Модель - STEP (Поверхностный монтаж, Горизонтальные индикаторы).step, Bill Of Materials - Excell.xlsx, Pick And Place (PnP) Files.csv, Перечень элементов (BOM) - Excell (Выв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]
2026-06-07 Добавлены руководства, прошивка и галерея индикаторов
2026-06-07 Добавлено объявление о печатных платах v2.0
2026-06-07 Общие материалы сборки и настройки перенесены в common
2026-06-07 Разделы диагностики и индикаторов перенесены в common
2026-06-07 В README добавлена галерея печатных плат
2026-06-07 Рендеры печатных плат добавлены в разделы Standard и Hardcore
2026-10-10 docs: улучшить навигацию и подачу Wiki
2026-10-10 docs: улучшить визуальное оформление Wiki
